OilyT/ShroomShedMKII/SolidWorks/AE_parts/AE_Hinge_31x40_ass.SLDASM

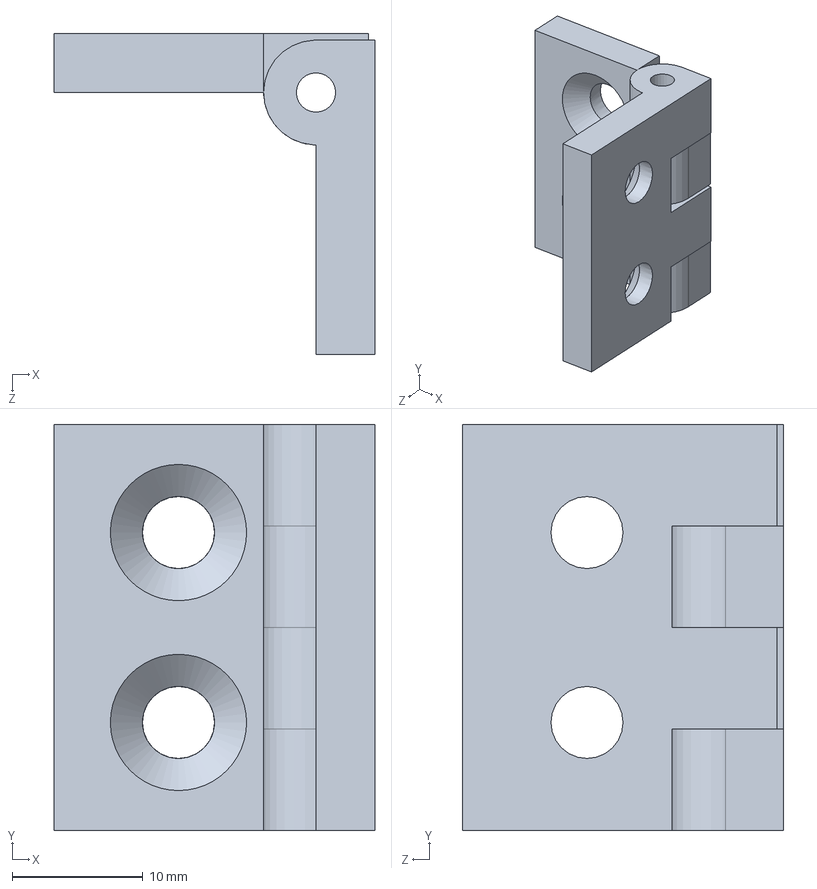
[picture p1: CAD file, 2026-11-09]
SolidWorks/AE_parts/AE_Hinge_31x40_ass.SLDASM
24.5 x 31.0 x 24.5 mm
AE_Hinge_31x40_A x 2
