OilyT/ShroomShedMKII/SolidWorks/Right_Assembly.SLDASM

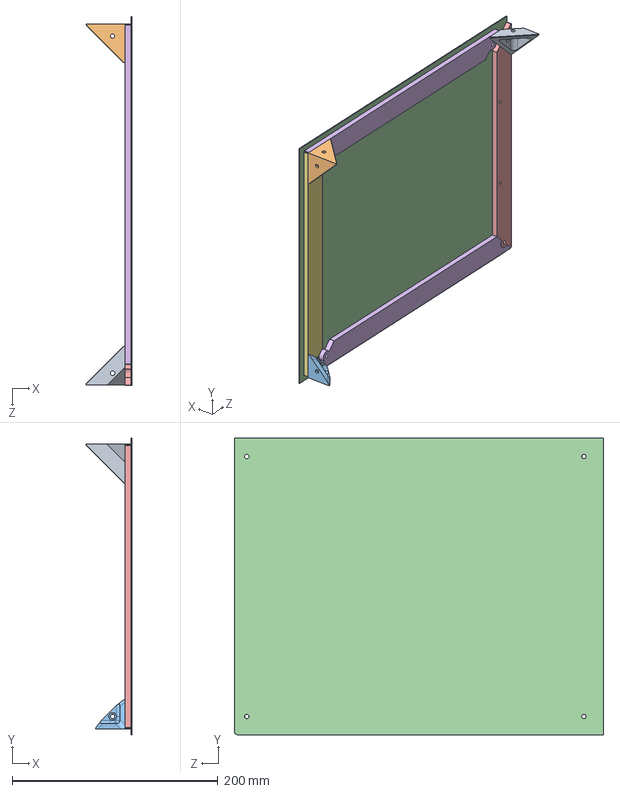
[picture p2: CAD file, 2026-11-09]
SolidWorks/Right_Assembly.SLDASM
45.0 x 289.0 x 359.3 mm
FRAME_SIDE_VERTICAL
FRAME_SIDE_HORIZONTAL x 2
FRAME_SIDE_VERTICAL_HOLED_RIGHT
Right_Panel
L2_bracket_2H_1C
L2_bracket_3H
V3_bracket_front_TOP
