OilyT/ShroomShedMKII/SolidWorks/DXF/Frame_cuts_all.SLDASM

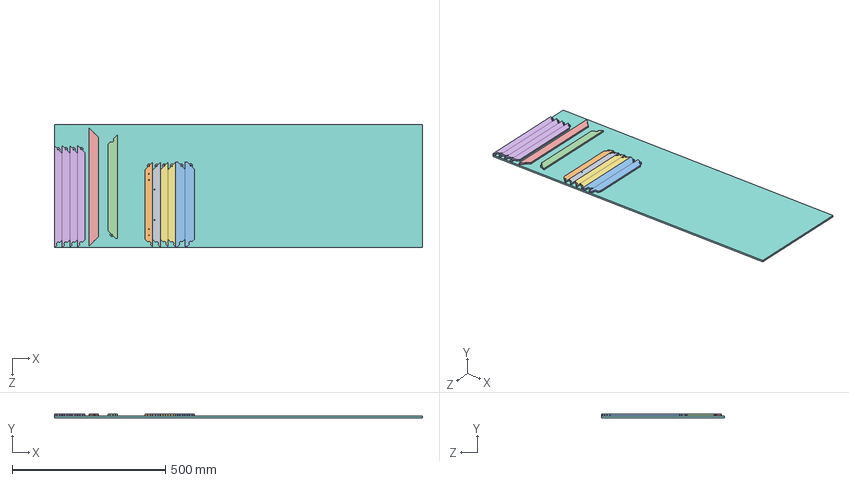
[picture p3: CAD file, 2026-11-09]
SolidWorks/DXF/Frame_cuts_all.SLDASM
1200.0 x 12.0 x 400.4 mm
400x1200mm_base
FRAME_SIDE_VERTICAL x 2
FRAME_SIDE_HORIZONTAL x 4
FRAME_TOP_BACK
FRAME_TOP_SIDE
FRAME_REAR_VERT x 2
FRAME_SIDE_VERTICAL_HOLED
FRAME_SIDE_VERTICAL_HOLED_RIGHT
