OilyT/ShroomShedMKII/SolidWorks/Rear_assembly.SLDASM

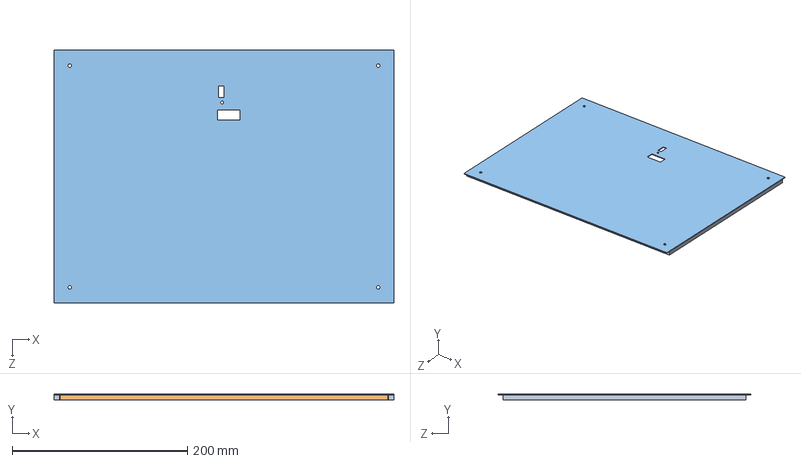
[picture p4: CAD file, 2026-11-09]
SolidWorks/Rear_assembly.SLDASM
388.0 x 7.00 x 289.0 mm
Rear_Panel
FRAME_REAR_BOTT
FRAME_REAR_VERT x 2
