OilyT/ShroomShedMKII/SolidWorks/subass/Hinge 2 Piece.SLDASM

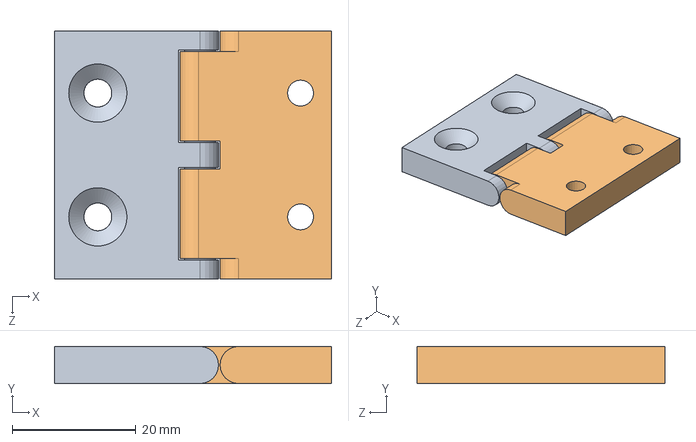
[picture p5: CAD file, 2026-11-09]
SolidWorks/subass/Hinge 2 Piece.SLDASM
44.8 x 6.00 x 40.0 mm
Hinge_SideB
Hinge_sideA
