OilyT/ShroomShedMKII/SolidWorks/SIDE_FRAME.SLDASM

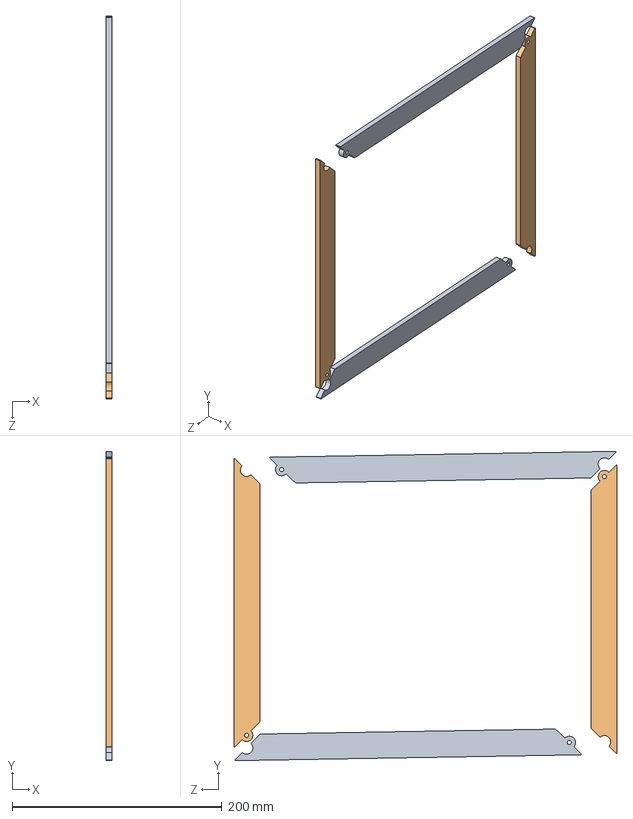
[picture p6: CAD file, 2026-02-02]
SolidWorks/SIDE_FRAME.SLDASM
6.00 x 295.1 x 365.5 mm
FRAME_SIDE_VERTICAL x 2
FRAME_SIDE_HORIZONTAL x 2
