OilyT/ShroomShedMKII/MFG/ShroomShed 0.1/DXF/PC_LEFT_RIGHT_DOOR_REAR.DXF

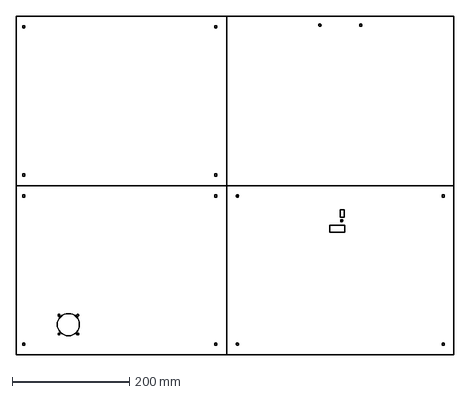
[picture p7: CAD file, 2026-07-16]
MFG/ShroomShed 0.1/DXF/PC_LEFT_RIGHT_DOOR_REAR.DXF
748.0 x 578.0 mm
