OilyT/ShroomShedMKII/MFG/ShroomShed 0.2/DXF/Frame/FRAME_CUT_C.DXF

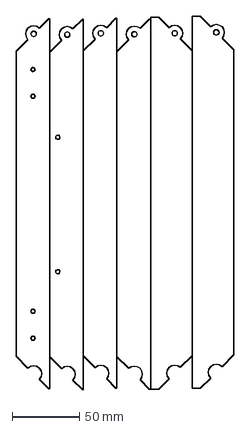
[picture p9: CAD file, 2026-11-09]
MFG/ShroomShed 0.2/DXF/Frame/FRAME_CUT_C.DXF
162.0 x 277.9 mm
