OilyT/ShroomShedMKII/MFG/ShroomShed 0.2/DXF/Top_Panel_.DXF

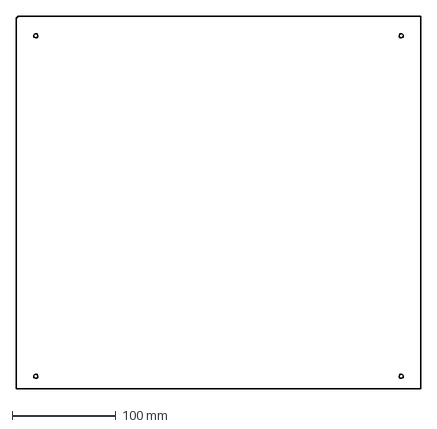
[picture p10: CAD file, 2026-11-09]
MFG/ShroomShed 0.2/DXF/Top_Panel_.DXF
390.0 x 359.0 mm
