OilyT/ShroomShedMKII/ShroomShed_MKII_PCB/ShroomShed_Sensor/Shroomshed_Sensor_R1_PCB.step

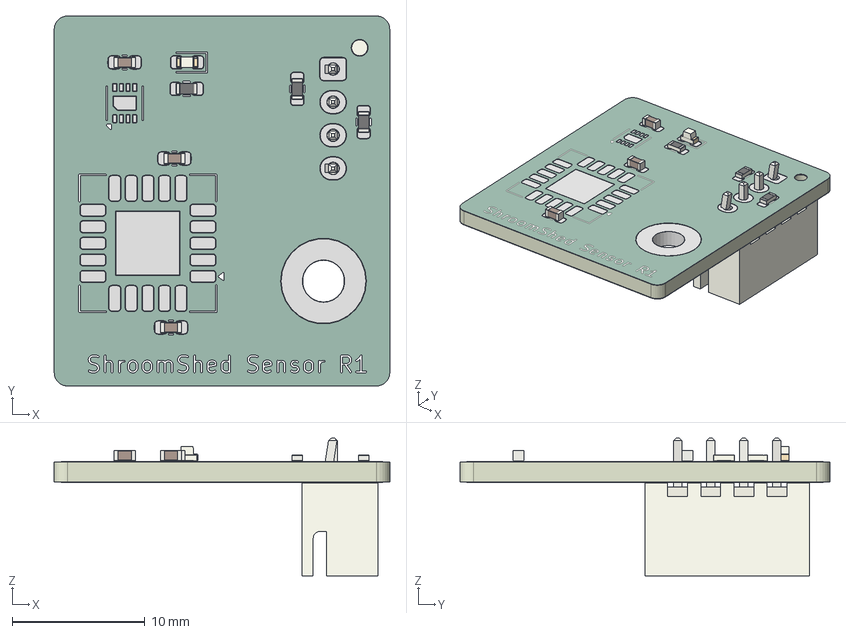
[picture p12: CAD file, 2026-07-03]
ShroomShed_MKII_PCB/ShroomShed_Sensor/Shroomshed_Sensor_R1_PCB.step
25.3 x 27.9 x 10.4 mm
LED_0603_1608Metric
C_0603_1608Metric x 3
R_0603_1608Metric x 3
JST_XH_B4B-XH-A_1x04_P2.50mm_Vertical
ShroomShed_Sensor_copper
ShroomShed_Sensor_pad
ShroomShed_Sensor_via
ShroomShed_Sensor_silkscreen x 2
ShroomShed_Sensor_soldermask x 2
ShroomShed_Sensor_PCB
