OilyT/ShroomShedMKII/ShroomShed_MKII_PCB/ShroomShedController_V22_simple.step

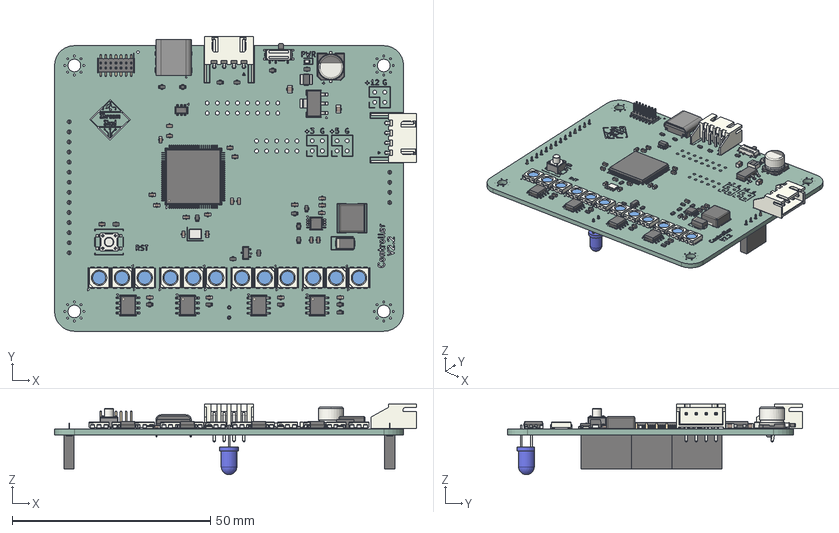
[picture p13: CAD file, 2026-07-03]
ShroomShed_MKII_PCB/ShroomShedController_V22_simple.step
91.2 x 74.2 x 17.8 mm
C_0603_1608Metric x 24
LED_RGB_5050-6 x 12
R_0603_1608Metric x 19
SW_SPST_PTS647Sx50
JST_XH_S4B-XH-A-1_1x04_P2.50mm_Horizontal x 2
USB_C_Receptacle_GCT_USB4085
C_0805_2012Metric x 2
CP_Elec_6.3x5.4
L_TechFuse_SL0630
Fuse_1210_3225Metric
SOIC-8_3.9x4.9mm_P1.27mm x 4
Crystal_SMD_3225-4Pin_3.2x2.5mm
SOT-223
PinHeader_2x07_P1.27mm_Vertical_SMD
SOT-23
SOT-23-6
VSSOP-8_3x3mm_P0.65mm
LQFP-100_14x14mm_P0.5mm
SW_SPDT_PCM12
LED_0603_1608Metric
D_SMA
LED_D4.0mm_Blue
PinSocket_1x04_P2.54mm_Vertical
PinSocket_1x14_P2.54mm_Vertical
ShroomShed_MKII_PCB_silkscreen x 2
ShroomShed_MKII_PCB_PCB
