OilyT/ShroomShedMKII/SolidWorks/AE_parts/AE_Hinge_31x40_A.SLDPRT

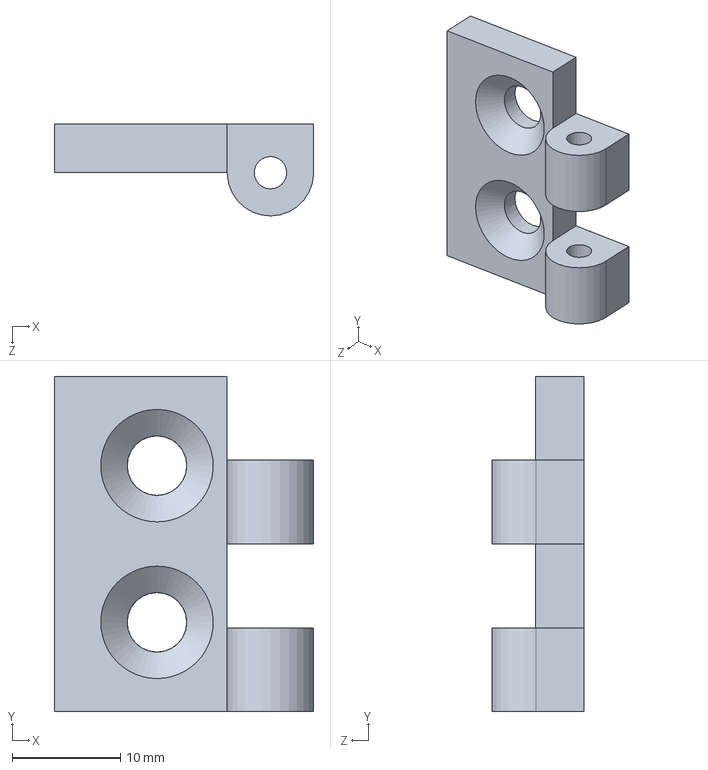
[picture p14: CAD file, 2026-11-09]
SolidWorks/AE_parts/AE_Hinge_31x40_A.SLDPRT
24.0 x 31.0 x 8.50 mm
