OilyT/ShroomShedMKII/SolidWorks/DXF/Door_V2.DXF

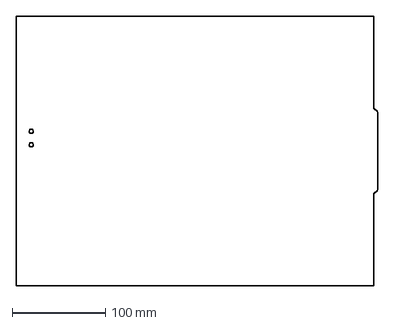
[picture p15: CAD file, 2026-11-09]
SolidWorks/DXF/Door_V2.DXF
388.0 x 289.0 mm
