OilyT/ShroomShedMKII/SolidWorks/proto/L1_bracket_1H_1C.STL

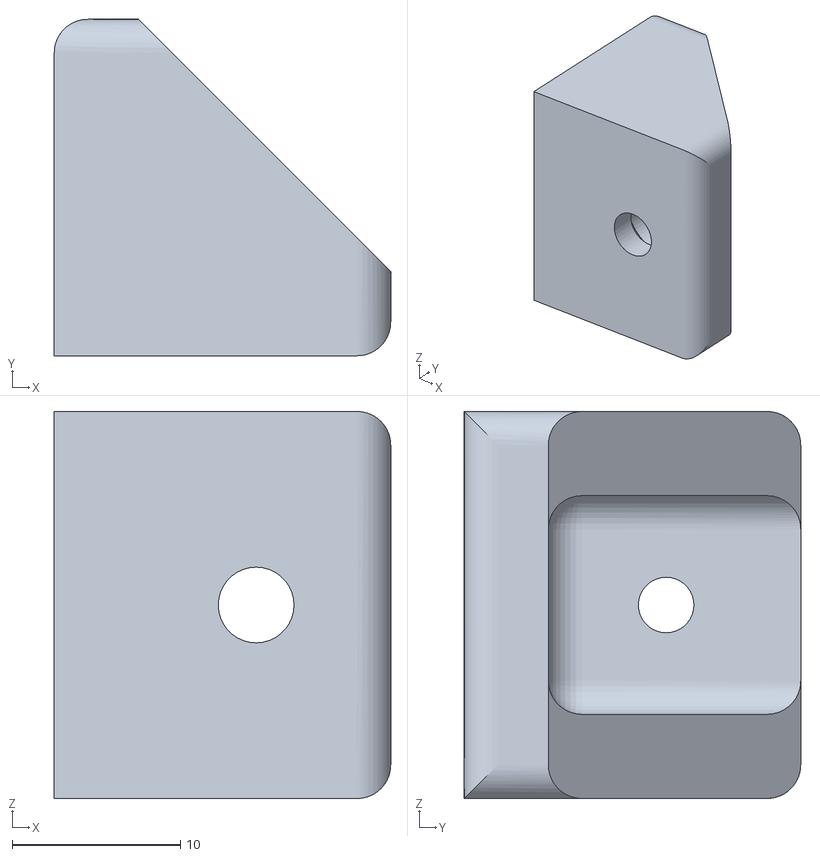
[picture p16: CAD file, 2026-11-09]
SolidWorks/proto/L1_bracket_1H_1C.STL
20.0 x 20.0 x 23.0
