OilyT/ShroomShedMKII/SolidWorks/Rear_Panel.SLDPRT

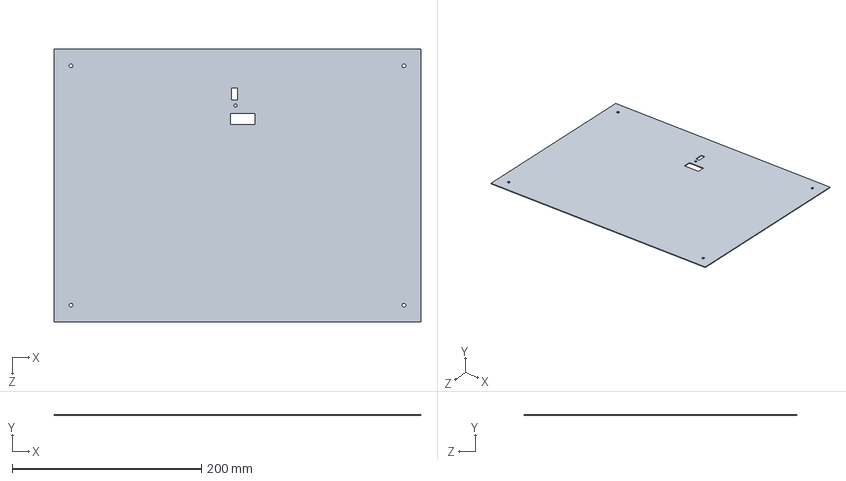
[picture p17: CAD file, 2026-11-09]
SolidWorks/Rear_Panel.SLDPRT
388.0 x 1.00 x 289.0 mm
