OilyT/ShroomShedMKII/SolidWorks/STL/TPU_SEAL_85mm.SLDPRT

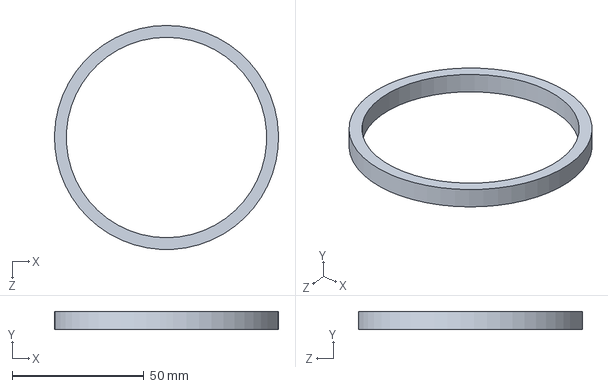
[picture p18: CAD file, 2026-07-21]
SolidWorks/STL/TPU_SEAL_85mm.SLDPRT
85.0 x 7.00 x 85.0 mm
