OilyT/ShroomShedMKII/SolidWorks/subass/Hinge_sideA.SLDPRT

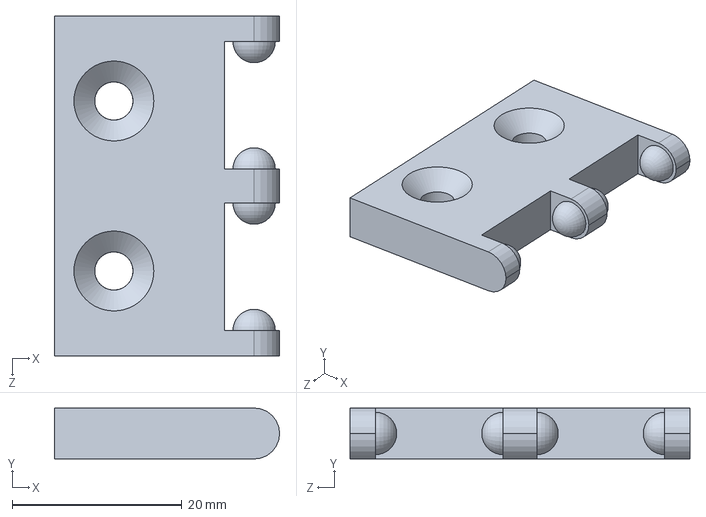
[picture p19: CAD file, 2026-11-09]
SolidWorks/subass/Hinge_sideA.SLDPRT
26.5 x 6.00 x 40.0 mm
