OilyT/ShroomShedMKII/MFG/ShroomShed 0.1/DXF/FRAME_top_side_2.DXF

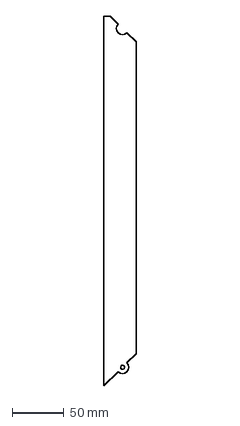
[picture p20: CAD file, 2026-07-03]
MFG/ShroomShed 0.1/DXF/FRAME_top_side_2.DXF
31.0 x 358.0 mm
