OilyT/ShroomShedMKII/MFG/ShroomShed 0.1/STL/Wick_cutting_jig_56mm.STL

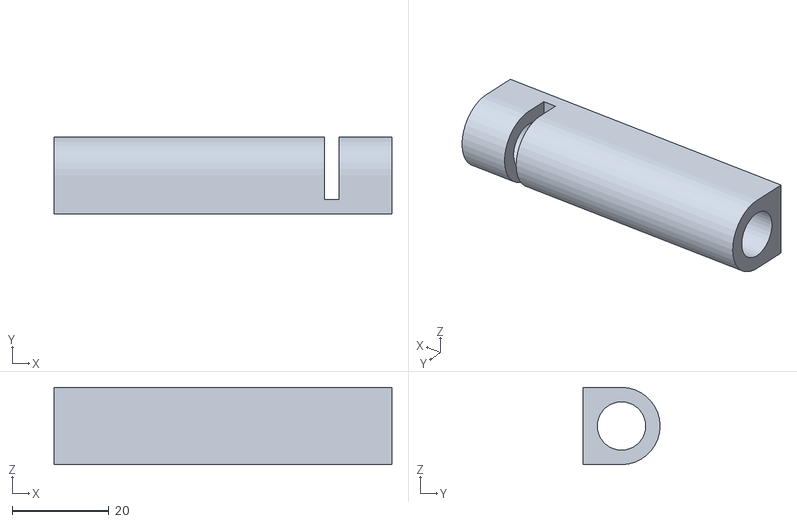
[picture p21: CAD file, 2026-07-30]
MFG/ShroomShed 0.1/STL/Wick_cutting_jig_56mm.STL
70.0 x 16.0 x 16.0
