OilyT/ShroomShedMKII/MFG/ShroomShed 0.2/DXF/Door_.DXF

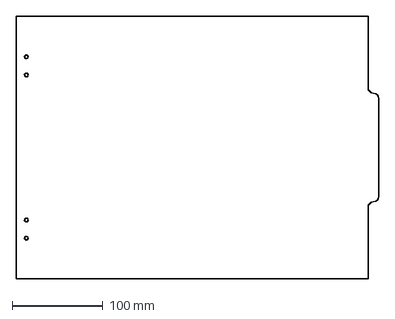
[picture p22: CAD file, 2026-11-09]
MFG/ShroomShed 0.2/DXF/Door_.DXF
400.0 x 289.0 mm
