OilyT/ShroomShedMKII/MFG/ShroomShed 0.2/DXF/Frame/FRAME_SIDE_VERTICAL_HOLED_RIGHT.DXF

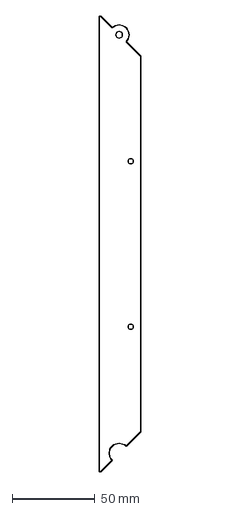
[picture p23: CAD file, 2026-11-09]
MFG/ShroomShed 0.2/DXF/Frame/FRAME_SIDE_VERTICAL_HOLED_RIGHT.DXF
25.0 x 275.7 mm
