OilyT/ShroomShedMKII/ShroomShed_MKII_PCB/ERM_PCB/ERM_BOARD_TRACES.step

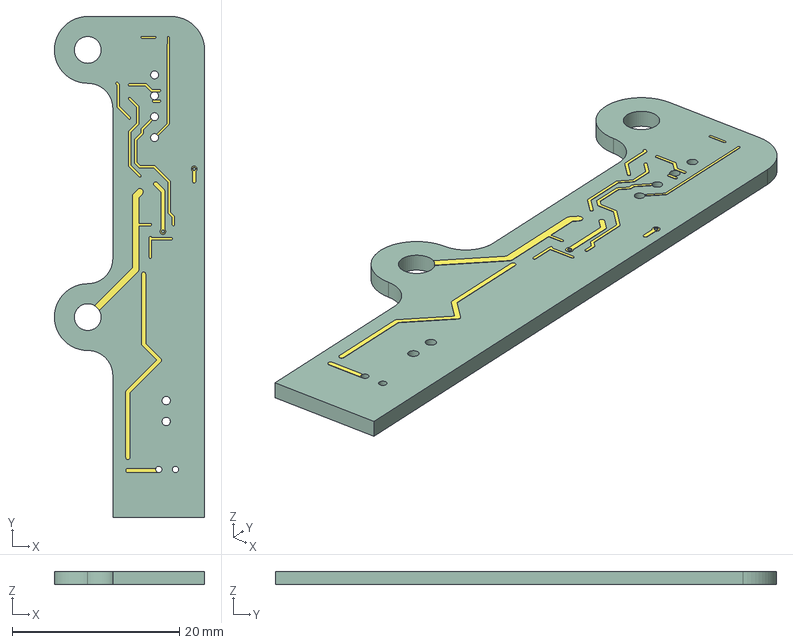
[picture p24: CAD file, 2026-04-01]
ShroomShed_MKII_PCB/ERM_PCB/ERM_BOARD_TRACES.step
18.0 x 60.0 x 1.58 mm
ERM_PCB_copper
ERM_PCB_via
ERM_PCB_PCB
