OilyT/ShroomShedMKII/ShroomShed_MKII_PCB/ShroomShed_MKII_PCB.step

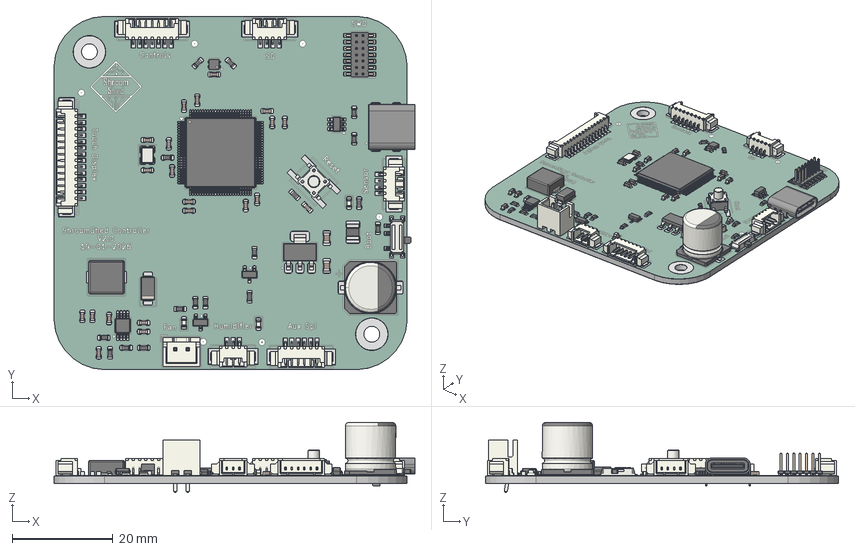
[picture p25: CAD file, 2026-02-02]
ShroomShed_MKII_PCB/ShroomShed_MKII_PCB.step
71.5 x 70.0 x 13.9 mm
C_0603_1608Metric x 21
R_0603_1608Metric x 17
LED_0603_1608Metric x 3
SW_SPDT_PCM12
SW_SPST_PTS647Sx50
Molex_PicoBlade_53261-0471_1x04-1MP_P1.25mm_Horizontal x 2
USB_C_Receptacle_GCT_USB4085
C_0805_2012Metric x 2
CP_Elec_10x10.5
L_TechFuse_SL0630
Fuse_1210_3225Metric
Crystal_SMD_3225-4Pin_3.2x2.5mm
SOT-223
SOT-23 x 2
PinHeader_2x07_P1.27mm_Vertical_SMD
DFN-6-1EP_2x2mm_P0.5mm_EP0.61x1.42mm
SOT-23-6
VSSOP-8_3x3mm_P0.65mm
Molex_PicoBlade_53261-0371_1x03-1MP_P1.25mm_Horizontal
LQFP-100_14x14mm_P0.5mm
Molex_PicoBlade_53261-1471_1x14-1MP_P1.25mm_Horizontal
Molex_PicoBlade_53261-0771_1x07-1MP_P1.25mm_Horizontal
Molex_PicoBlade_53261-0671_1x06-1MP_P1.25mm_Horizontal
D_SMA
JST_XH_B2B-XH-A_1x02_P2.50mm_Vertical
ShroomShed_MKII_PCB_copper
ShroomShed_MKII_PCB_pad
ShroomShed_MKII_PCB_via
ShroomShed_MKII_PCB_silkscreen x 2
ShroomShed_MKII_PCB_soldermask x 2
ShroomShed_MKII_PCB_PCB
