OilyT/ShroomShedMKII/SolidWorks/DXF/400x1200mm_base.SLDPRT

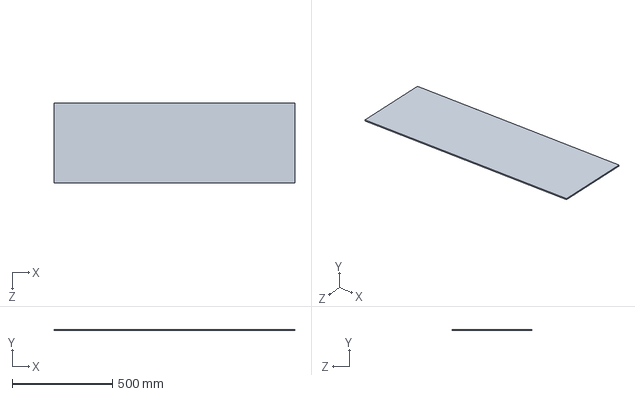
[picture p26: CAD file, 2026-11-09]
SolidWorks/DXF/400x1200mm_base.SLDPRT
1200.0 x 6.00 x 400.0 mm
