OilyT/ShroomShedMKII/SolidWorks/proto/L1_bracket_1H_1C_MAG_Bracket.STL

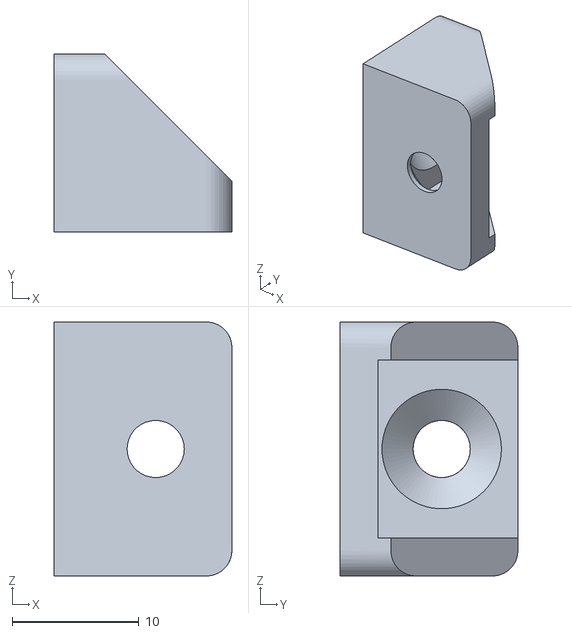
[picture p27: CAD file, 2026-11-09]
SolidWorks/proto/L1_bracket_1H_1C_MAG_Bracket.STL
14.0 x 14.0 x 20.0
