OilyT/ShroomShedMKII/SolidWorks/STL/Filter_Bracket.SLDPRT

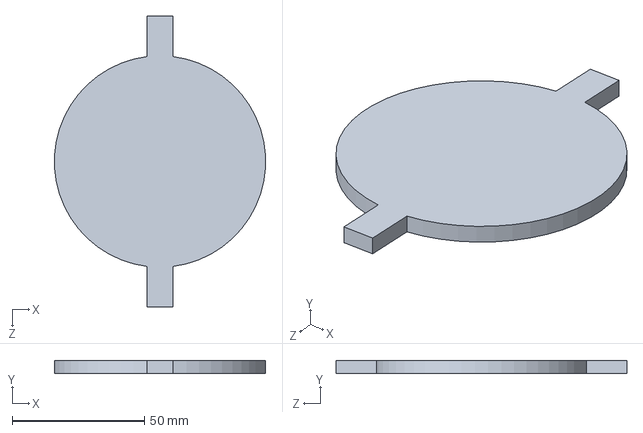
[picture p28: CAD file, 2026-07-21]
SolidWorks/STL/Filter_Bracket.SLDPRT
79.8 x 5.00 x 110.0 mm
