OilyT/ShroomShedMKII/SolidWorks/subass/Hinge_SideB.SLDPRT

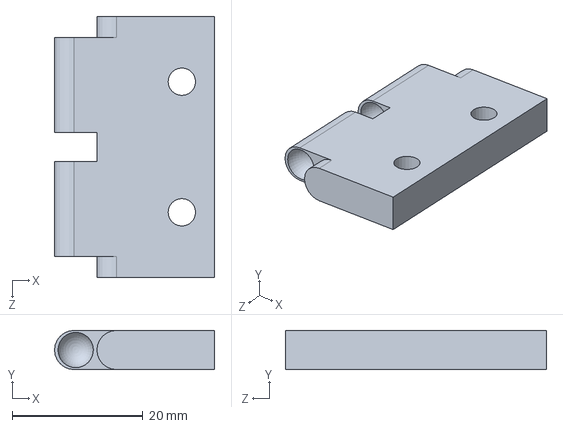
[picture p29: CAD file, 2026-11-09]
SolidWorks/subass/Hinge_SideB.SLDPRT
24.5 x 6.00 x 40.0 mm
