OilyT/ShroomShedMKII/MFG/ShroomShed 0.1/DXF/FRAME_CUT_C.DXF

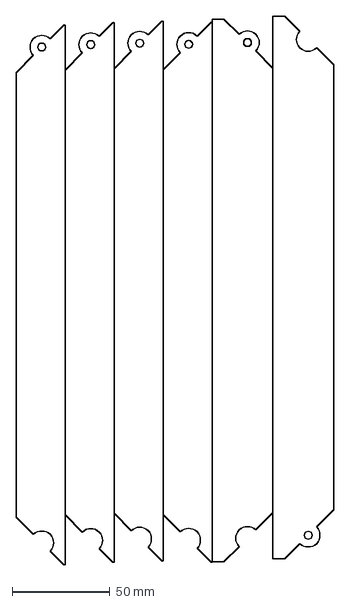
[picture p30: CAD file, 2026-07-03]
MFG/ShroomShed 0.1/DXF/FRAME_CUT_C.DXF
162.0 x 280.2 mm
