OilyT/ShroomShedMKII/MFG/ShroomShed 0.1/STL/Controller_Module.STL

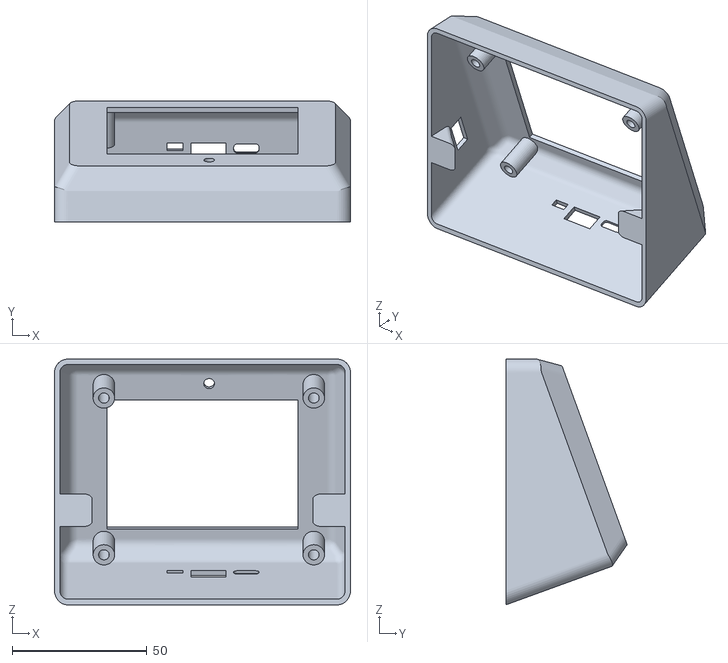
[picture p31: CAD file, 2026-07-03]
MFG/ShroomShed 0.1/STL/Controller_Module.STL
110.0 x 45.1 x 91.3
