OilyT/ShroomShedMKII/MFG/ShroomShed 0.2/DXF/Floor.DXF

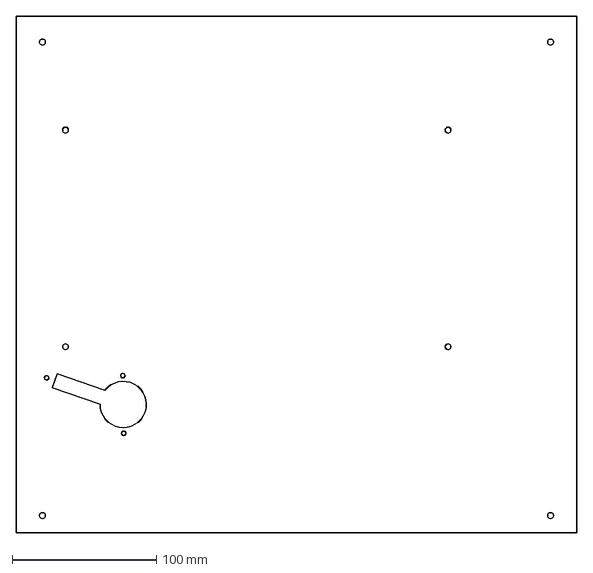
[picture p32: CAD file, 2026-11-09]
MFG/ShroomShed 0.2/DXF/Floor.DXF
388.0 x 358.0 mm
