OilyT/ShroomShedMKII/ShroomShed_MKII_PCB/ERM_PCB/ERM_PCB.step

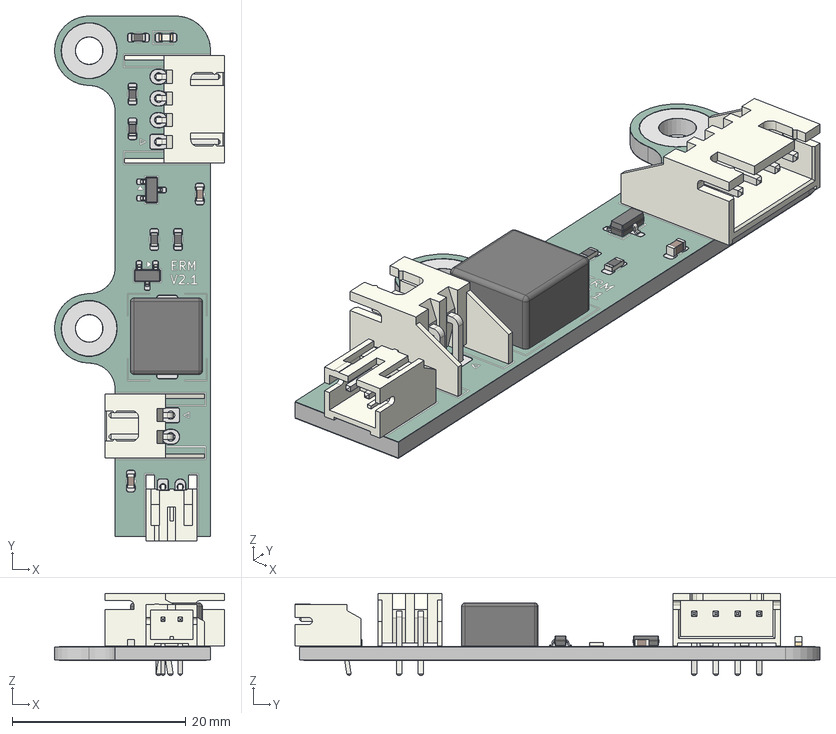
[picture p34: CAD file, 2026-02-11]
ShroomShed_MKII_PCB/ERM_PCB/ERM_PCB.step
19.6 x 60.5 x 9.50 mm
JST_XH_S2B-XH-A-1_1x02_P2.50mm_Horizontal
R_0603_1608Metric x 5
C_0603_1608Metric x 2
L_Coilcraft_XAL8050-223
JST_PH_S2B-PH-K_1x02_P2.00mm_Horizontal
SOT-23 x 2
JST_XH_S4B-XH-A-1_1x04_P2.50mm_Horizontal
LED_0603_1608Metric
ERM_PCB_copper
ERM_PCB_pad
ERM_PCB_via
ERM_PCB_silkscreen
ERM_PCB_soldermask x 2
ERM_PCB_PCB
