OilyT/ShroomShedMKII/SolidWorks/proto/V3_bracket_front_base.STL

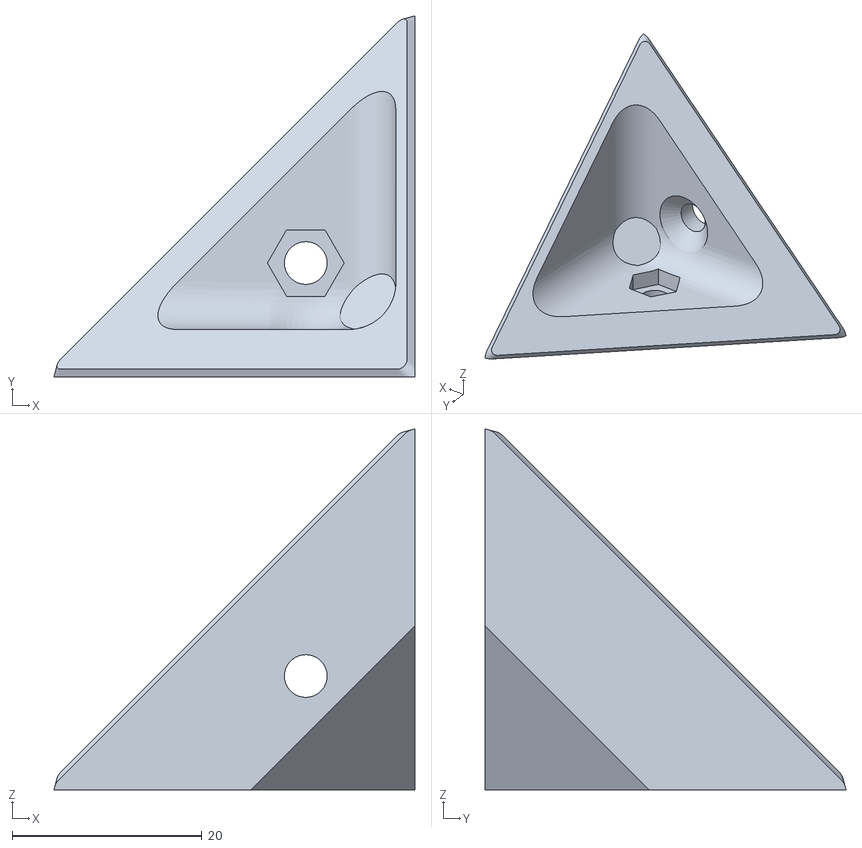
[picture p35: CAD file, 2026-11-09]
SolidWorks/proto/V3_bracket_front_base.STL
38.0 x 38.0 x 38.0
