OilyT/ShroomShedMKII/MFG/ShroomShed 0.1/DXF/Right_Panel.DXF

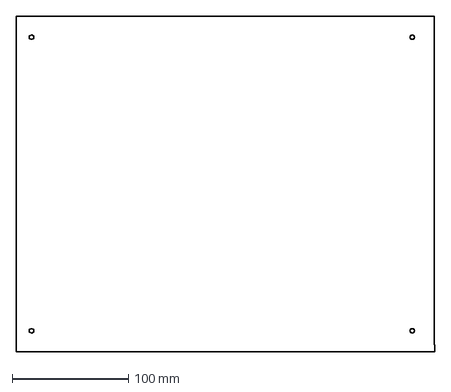
[picture p36: CAD file, 2026-07-03]
MFG/ShroomShed 0.1/DXF/Right_Panel.DXF
360.2 x 289.0 mm
