OilyT/ShroomShedMKII/MFG/ShroomShed 0.2/DXF/Frame/FRAME_rear_bot_(tf).DXF

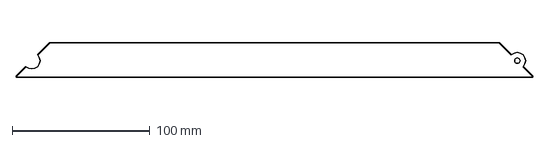
[picture p38: CAD file, 2026-07-03]
MFG/ShroomShed 0.2/DXF/Frame/FRAME_rear_bot_(tf).DXF
374.7 x 25.0 mm
