OilyT/ShroomShedMKII/MFG/ShroomShed 0.2/DXF/Rear_Panel.DXF

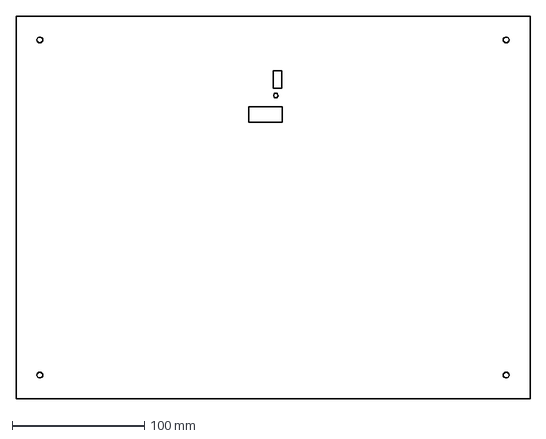
[picture p39: CAD file, 2026-11-09]
MFG/ShroomShed 0.2/DXF/Rear_Panel.DXF
388.0 x 289.0 mm
