OilyT/ShroomShedMKII/SolidWorks/proto/Hinge 2 Piece_holed.STL

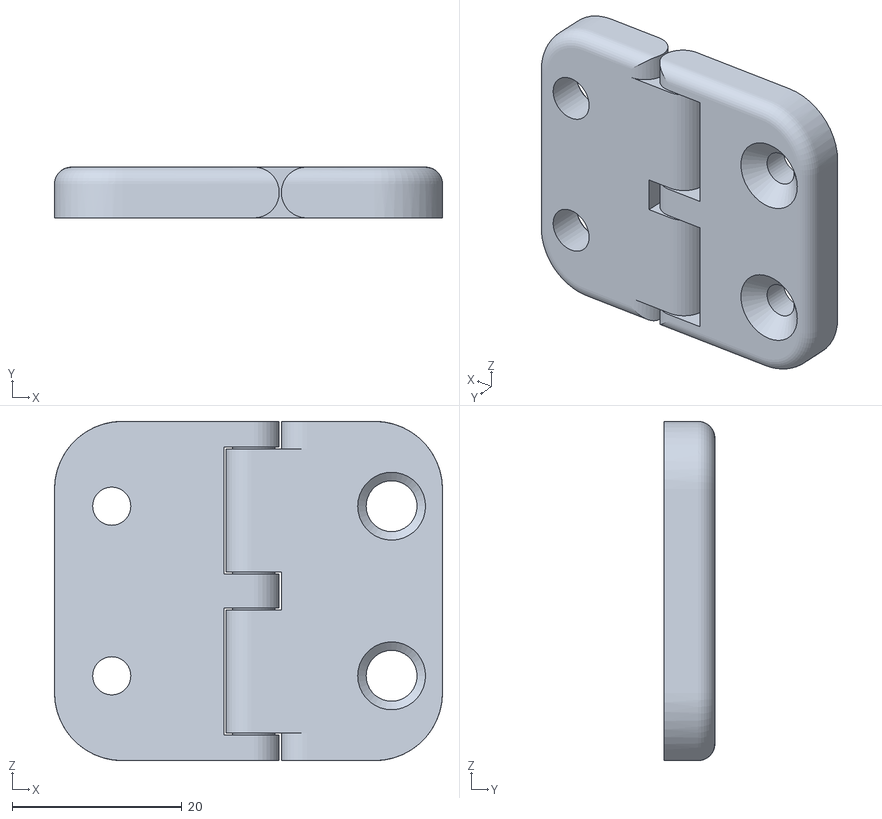
[picture p40: CAD file, 2026-11-09]
SolidWorks/proto/Hinge 2 Piece_holed.STL
45.8 x 6.00 x 40.0
