OilyT/ShroomShedMKII/MFG/ShroomShed 0.1/DXF/FRAME_top_back.DXF

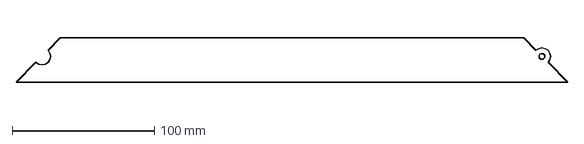
[picture p41: CAD file, 2026-07-03]
MFG/ShroomShed 0.1/DXF/FRAME_top_back.DXF
388.0 x 31.0 mm
