OilyT/ShroomShedMKII/MFG/ShroomShed 0.1/STL/L2_bracket_front_high.STL

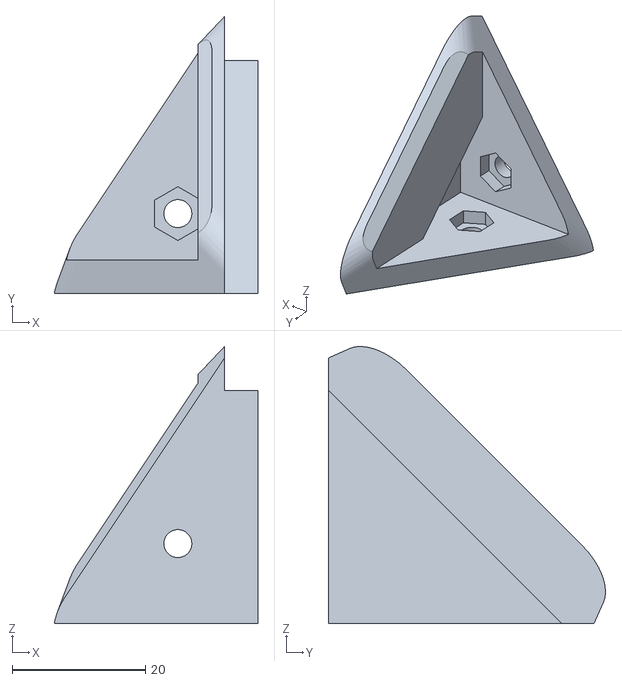
[picture p42: CAD file, 2026-07-03]
MFG/ShroomShed 0.1/STL/L2_bracket_front_high.STL
30.6 x 41.6 x 41.6
