OilyT/ShroomShedMKII/MFG/ShroomShed 0.2/DXF/acrylic_magnet_bracket.DXF

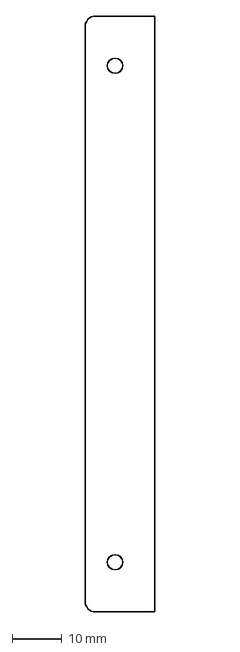
[picture p43: CAD file, 2026-11-09]
MFG/ShroomShed 0.2/DXF/acrylic_magnet_bracket.DXF
14.0 x 120.0 mm
