OilyT/ShroomShedMKII/SolidWorks/DXF/PC_TOP_X2.DXF

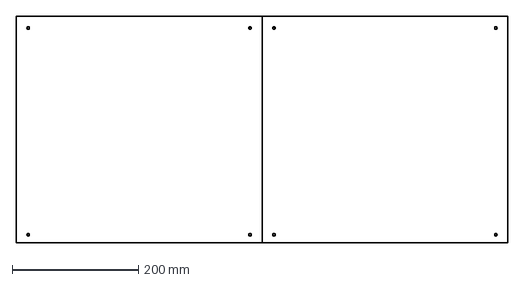
[picture p44: CAD file, 2026-07-16]
SolidWorks/DXF/PC_TOP_X2.DXF
780.0 x 360.0 mm
