OilyT/ShroomShedMKII/MFG/ShroomShed 0.1/DXF/Left_Panel.DXF

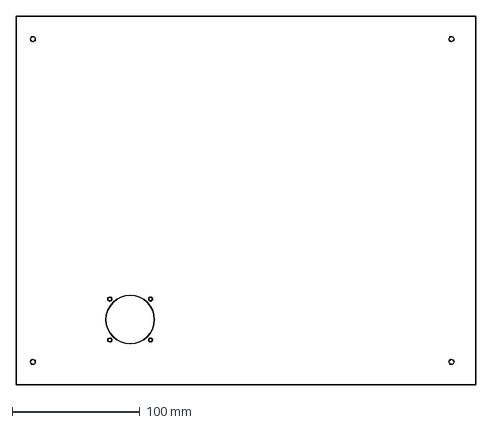
[picture p45: CAD file, 2026-07-03]
MFG/ShroomShed 0.1/DXF/Left_Panel.DXF
360.0 x 289.0 mm
