OilyT/ShroomShedMKII/MFG/ShroomShed 0.2/DXF/Right_Panel.DXF

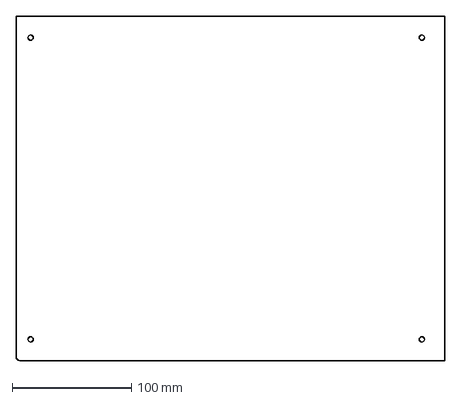
[picture p46: CAD file, 2026-11-09]
MFG/ShroomShed 0.2/DXF/Right_Panel.DXF
359.3 x 289.0 mm
