OilyT/ShroomShedMKII/SolidWorks/DXF/PC_DOOR_REAR.DXF

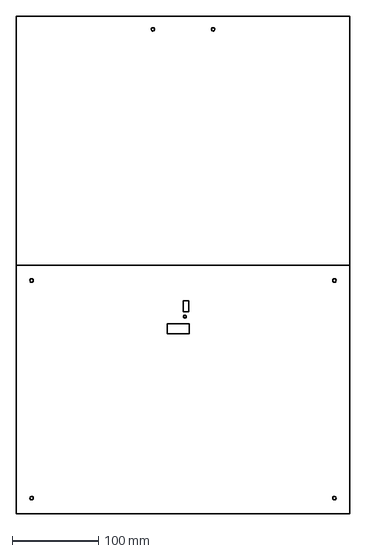
[picture p47: CAD file, 2026-07-16]
SolidWorks/DXF/PC_DOOR_REAR.DXF
388.0 x 578.0 mm
