OilyT/ShroomShedMKII/SolidWorks/hinge_bracket.SLDPRT

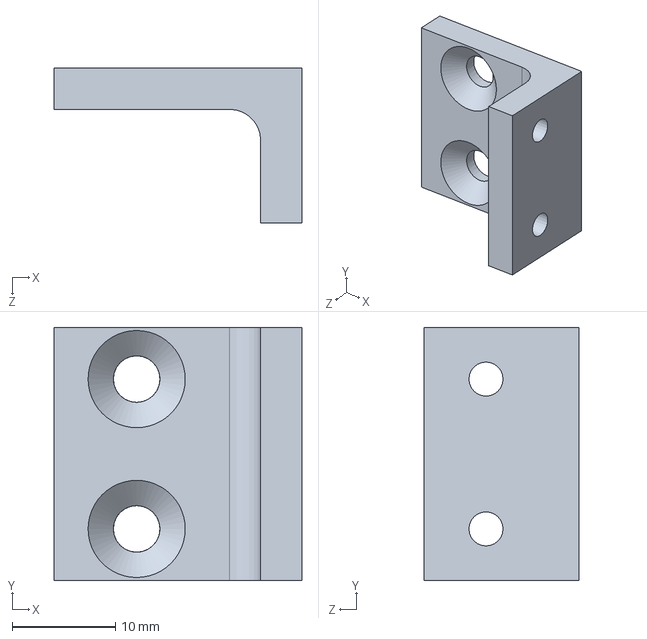
[picture p48: CAD file, 2026-11-09]
SolidWorks/hinge_bracket.SLDPRT
24.0 x 24.5 x 15.0 mm
