OilyT/ShroomShedMKII/SolidWorks/proto/Transducer_Lid_CONV_V2.STL

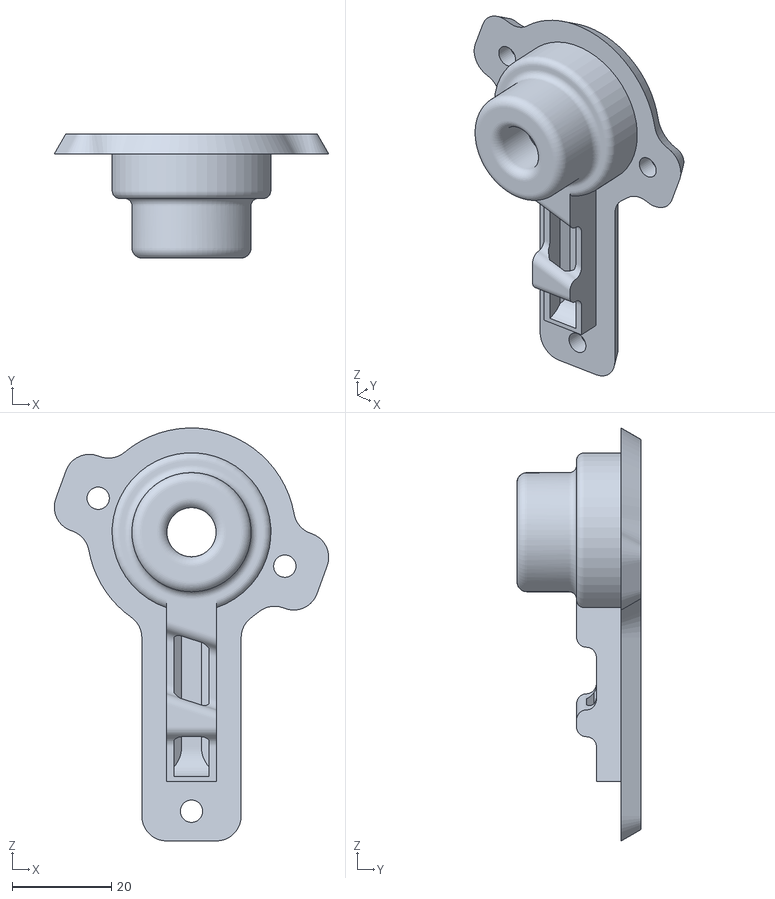
[picture p49: CAD file, 2026-11-09]
SolidWorks/proto/Transducer_Lid_CONV_V2.STL
55.3 x 25.0 x 83.2
