OilyT/ShroomShedMKII/MFG/ShroomShed 0.1/STL/Transducer_Lid.STL

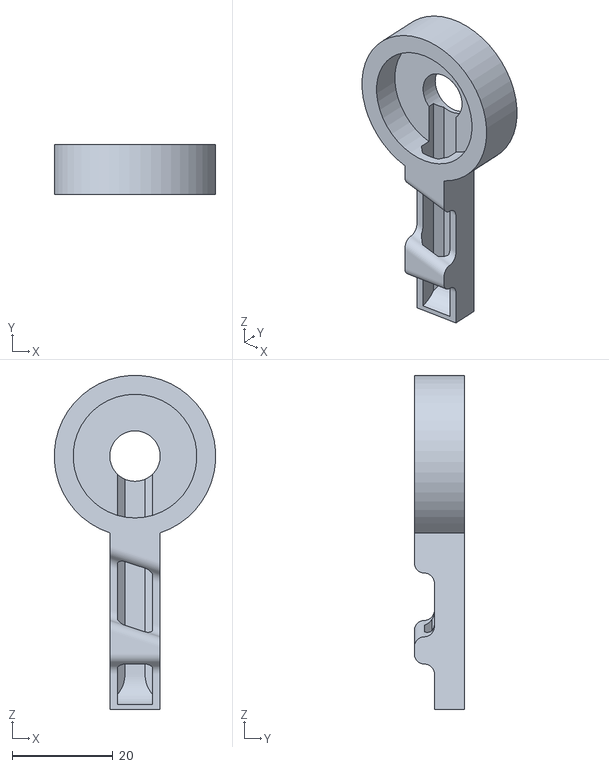
[picture p50: CAD file, 2026-04-29]
MFG/ShroomShed 0.1/STL/Transducer_Lid.STL
31.9 x 10.0 x 66.2
