OilyT/ShroomShedMKII/MFG/ShroomShed 0.2/DXF/Left_Panel.DXF

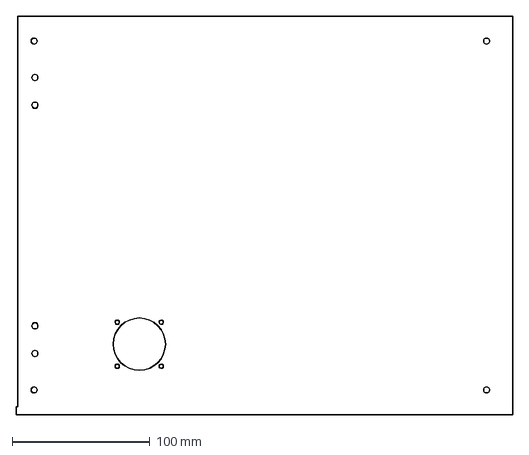
[picture p51: CAD file, 2026-11-09]
MFG/ShroomShed 0.2/DXF/Left_Panel.DXF
360.0 x 289.0 mm
