OilyT/ShroomShedMKII/SolidWorks/acrylic_magnet_bracket.SLDPRT

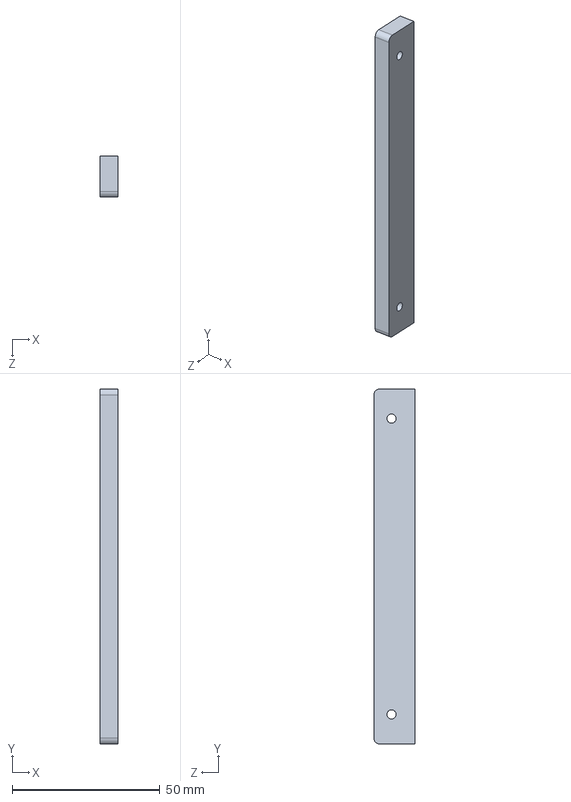
[picture p52: CAD file, 2026-11-09]
SolidWorks/acrylic_magnet_bracket.SLDPRT
6.00 x 120.0 x 14.0 mm
