OilyT/ShroomShedMKII/SolidWorks/DXF/PC_LEFT_RIGHT.DXF

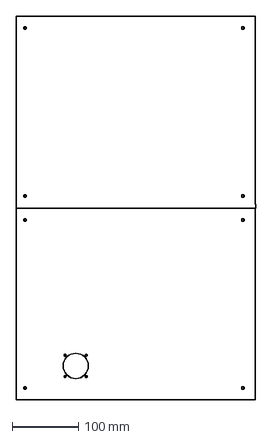
[picture p53: CAD file, 2026-07-16]
SolidWorks/DXF/PC_LEFT_RIGHT.DXF
360.2 x 578.0 mm
