OilyT/ShroomShedMKII/MFG/ShroomShed 0.1/DXF/FRAME_CUT_B.DXF

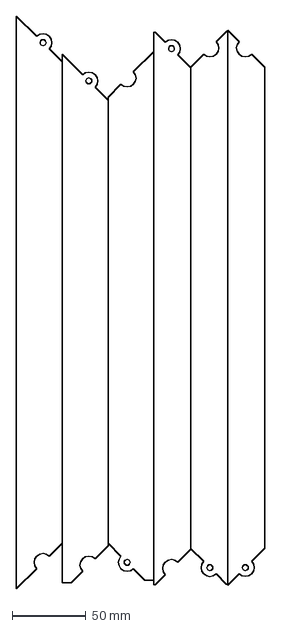
[picture p54: CAD file, 2026-07-03]
MFG/ShroomShed 0.1/DXF/FRAME_CUT_B.DXF
168.0 x 388.0 mm
