OilyT/ShroomShedMKII/MFG/ShroomShed 0.1/STL/L2_bracket_3H.STL

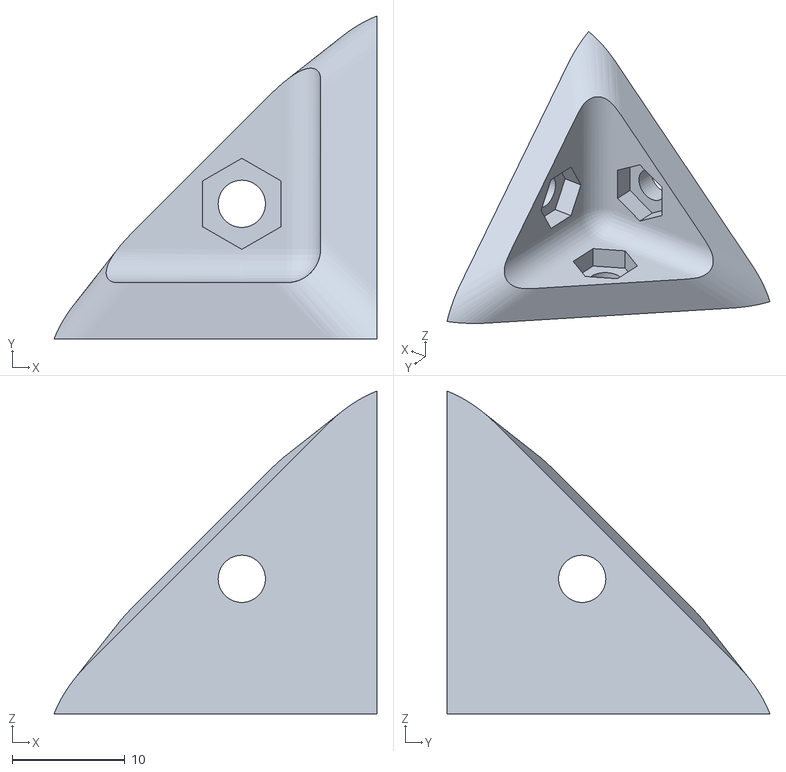
[picture p55: CAD file, 2026-04-09]
MFG/ShroomShed 0.1/STL/L2_bracket_3H.STL
28.7 x 28.7 x 28.7
