OilyT/ShroomShedMKII/SolidWorks/DXF/FRAME_side_vert.DXF

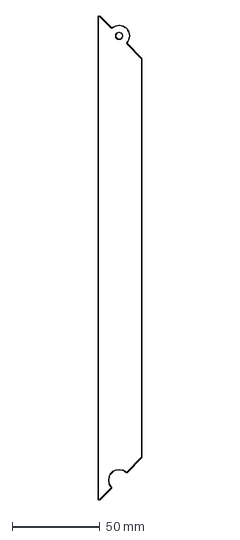
[picture p56: CAD file, 2026-07-03]
SolidWorks/DXF/FRAME_side_vert.DXF
25.0 x 275.7 mm
