OilyT/ShroomShedMKII/SolidWorks/FRAME_REAR_BOTT.SLDPRT

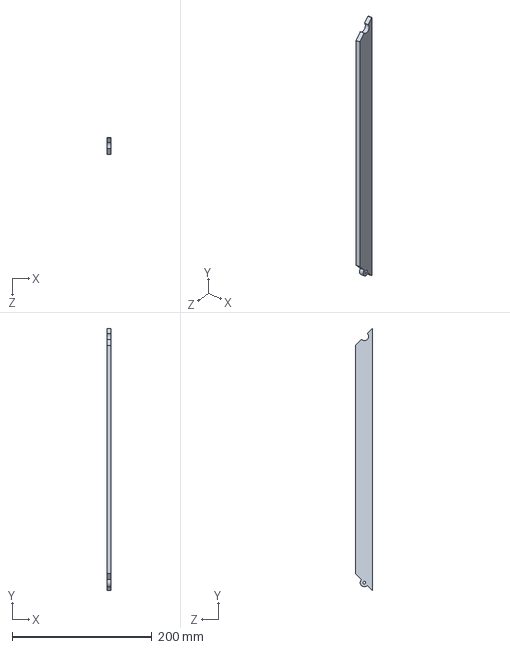
[picture p57: CAD file, 2026-11-09]
SolidWorks/FRAME_REAR_BOTT.SLDPRT
6.00 x 374.6 x 25.0 mm
