OilyT/ShroomShedMKII/SolidWorks/proto/V3_bracket_front_TOP.STL

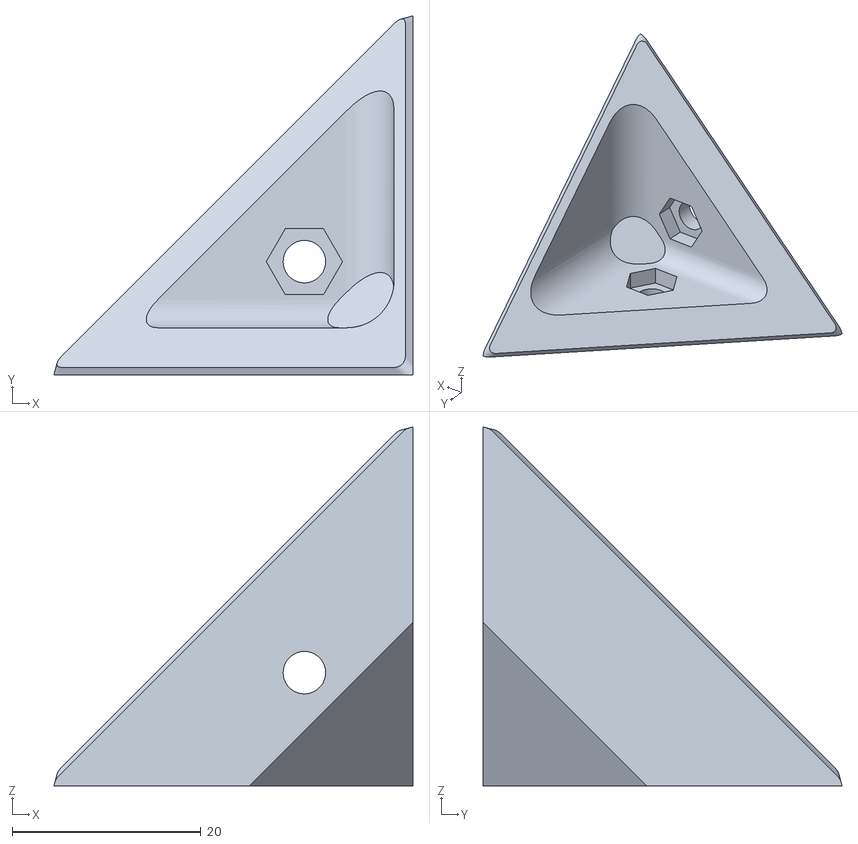
[picture p58: CAD file, 2026-11-09]
SolidWorks/proto/V3_bracket_front_TOP.STL
38.0 x 38.0 x 38.0
