OilyT/ShroomShedMKII/SolidWorks/DXF/FRAME_rear_top_(actual).DXF

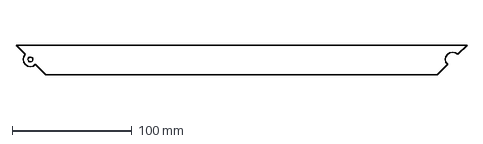
[picture p59: CAD file, 2026-07-03]
SolidWorks/DXF/FRAME_rear_top_(actual).DXF
376.0 x 25.0 mm
