OilyT/ShroomShedMKII/SolidWorks/FRAME_SIDE_HORIZONTAL.SLDPRT

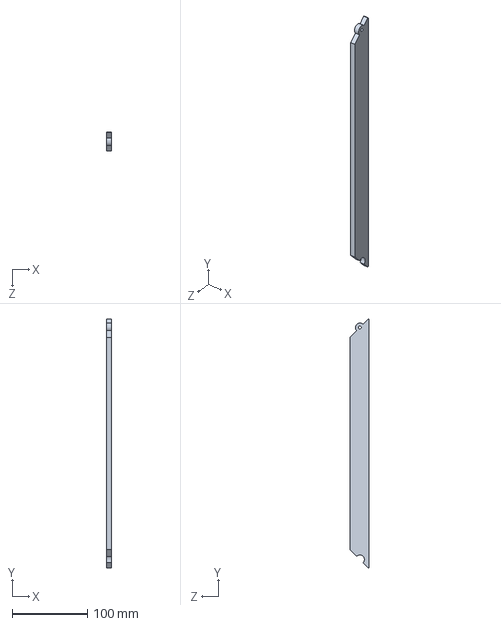
[picture p60: CAD file, 2026-11-09]
SolidWorks/FRAME_SIDE_HORIZONTAL.SLDPRT
6.00 x 330.6 x 25.0 mm
