OilyT/ShroomShedMKII/SolidWorks/proto/foot_flat.STL

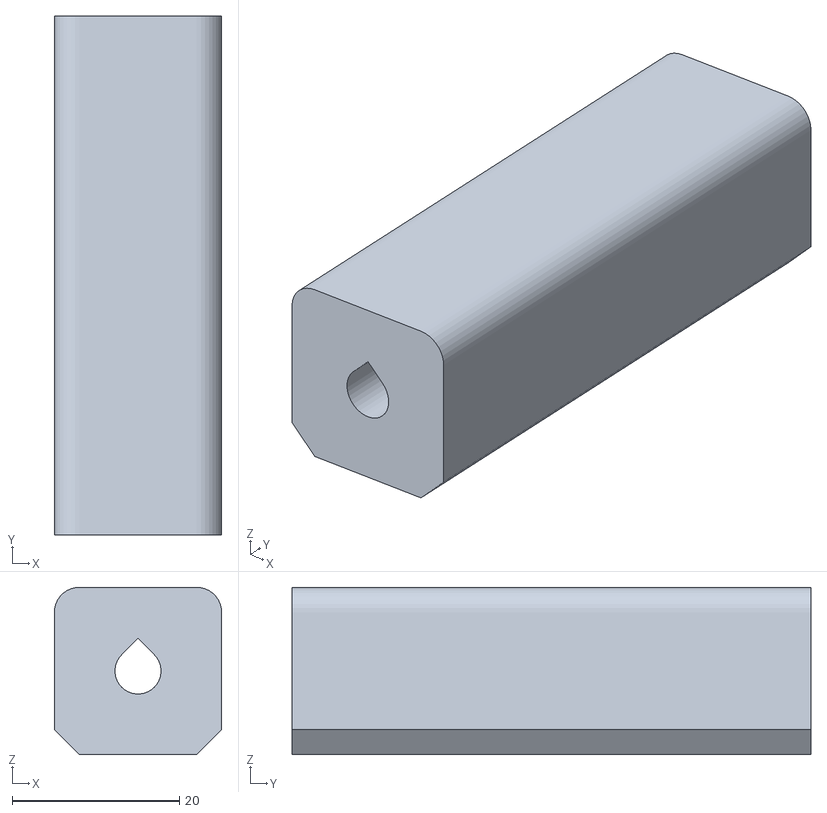
[picture p61: CAD file, 2026-11-09]
SolidWorks/proto/foot_flat.STL
20.0 x 62.0 x 20.0
