OilyT/ShroomShedMKII/SolidWorks/DXF/FRAME_CUT_A.DXF

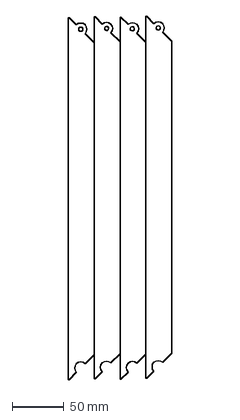
[picture p62: CAD file, 2026-07-03]
SolidWorks/DXF/FRAME_CUT_A.DXF
100.0 x 351.9 mm
