OilyT/ShroomShedMKII/SolidWorks/Polycarbonate_Tub_240x304mm.SLDPRT

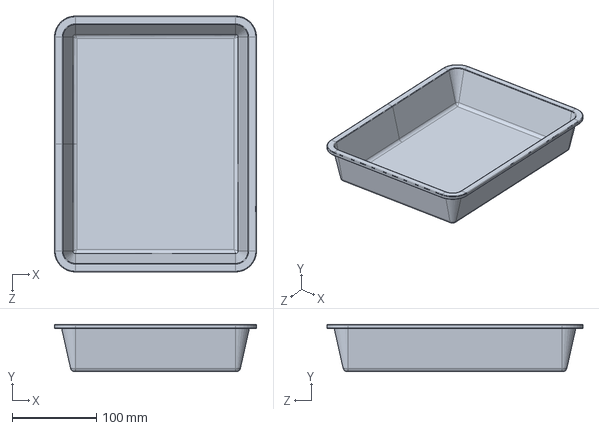
[picture p63: CAD file, 2026-11-09]
SolidWorks/Polycarbonate_Tub_240x304mm.SLDPRT
240.0 x 56.0 x 304.0 mm
