OilyT/ShroomShedMKII/SolidWorks/Door_.SLDPRT

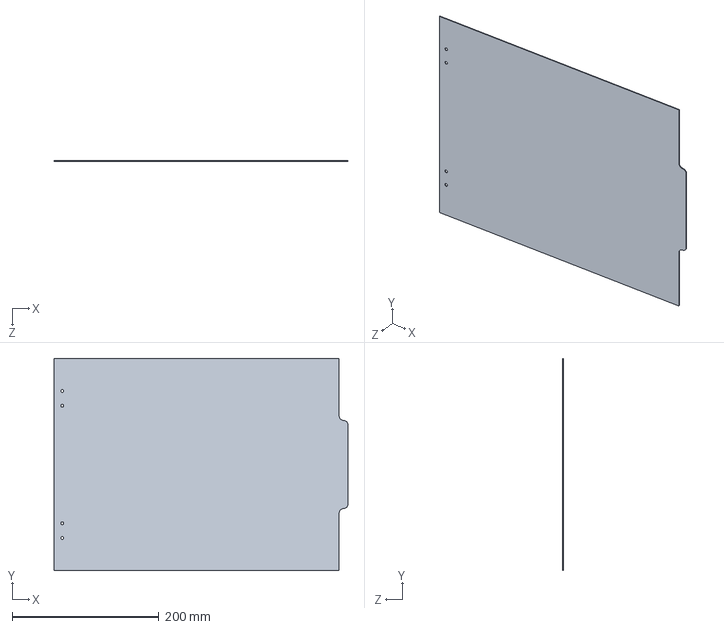
[picture p64: CAD file, 2026-11-09]
SolidWorks/Door_.SLDPRT
400.0 x 289.0 x 1.00 mm
