OilyT/ShroomShedMKII/SolidWorks/DXF/Frame_cuts_SIDE_VERTICAL.DXF

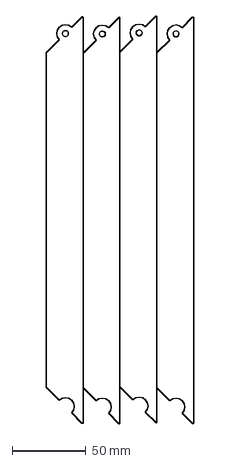
[picture p65: CAD file, 2026-07-03]
SolidWorks/DXF/Frame_cuts_SIDE_VERTICAL.DXF
100.0 x 276.4 mm
