OilyT/ShroomShedMKII/SolidWorks/proto/HUMIDIFIER_CAP.STL

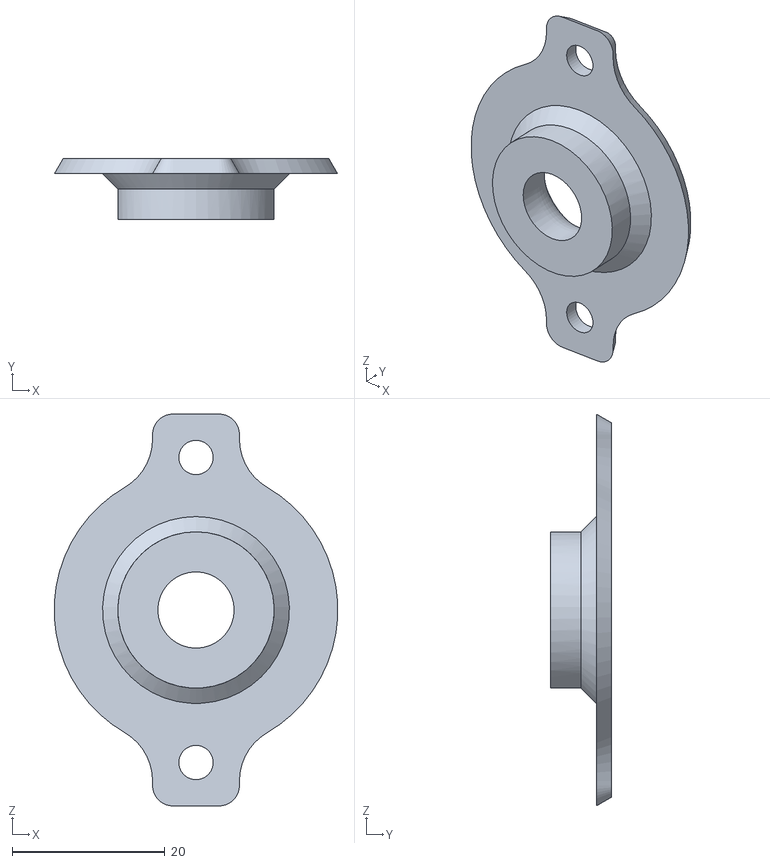
[picture p66: CAD file, 2026-11-09]
SolidWorks/proto/HUMIDIFIER_CAP.STL
37.1 x 8.00 x 51.4
