OilyT/ShroomShedMKII/SolidWorks/DXF/Frame_cuts_SIDE_HORIZONTAL.DXF

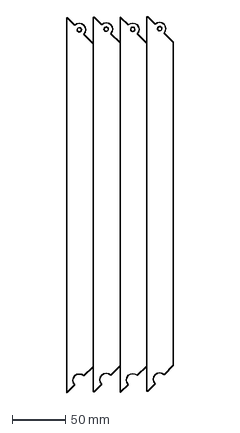
[picture p67: CAD file, 2026-07-03]
SolidWorks/DXF/Frame_cuts_SIDE_HORIZONTAL.DXF
100.0 x 351.9 mm
