OilyT/ShroomShedMKII/SolidWorks/L2_bracket_2H_1C.SLDPRT

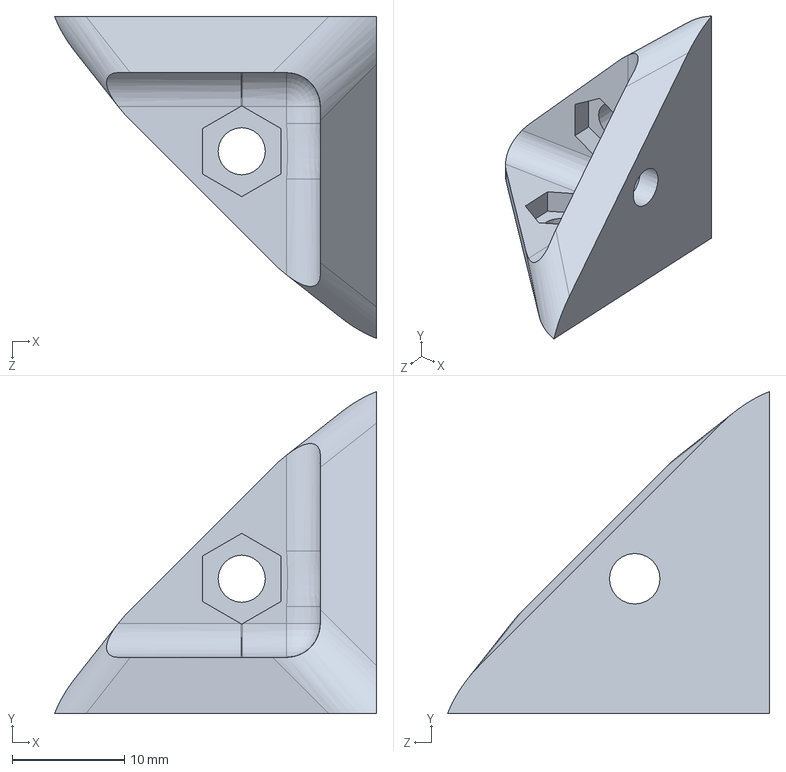
[picture p68: CAD file, 2026-11-09]
SolidWorks/L2_bracket_2H_1C.SLDPRT
28.7 x 28.7 x 28.7 mm
