OilyT/ShroomShedMKII/SolidWorks/FRAME_SIDE_VERTICAL_HOLED.SLDPRT

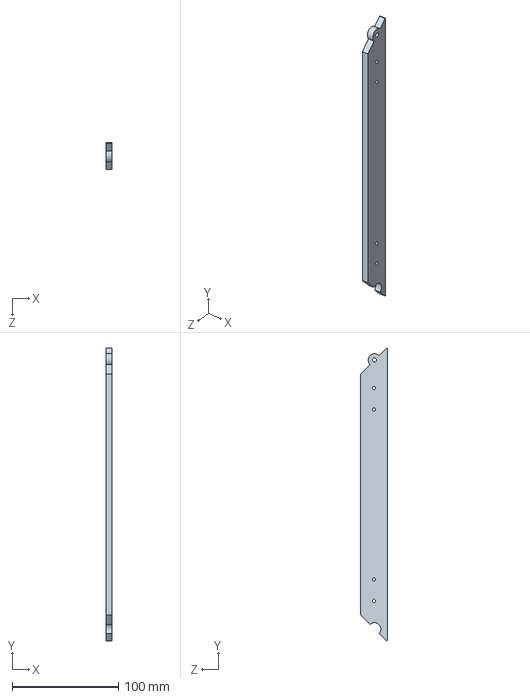
[picture p69: CAD file, 2026-11-09]
SolidWorks/FRAME_SIDE_VERTICAL_HOLED.SLDPRT
6.00 x 275.6 x 25.0 mm
