OilyT/ShroomShedMKII/SolidWorks/Floor.SLDPRT

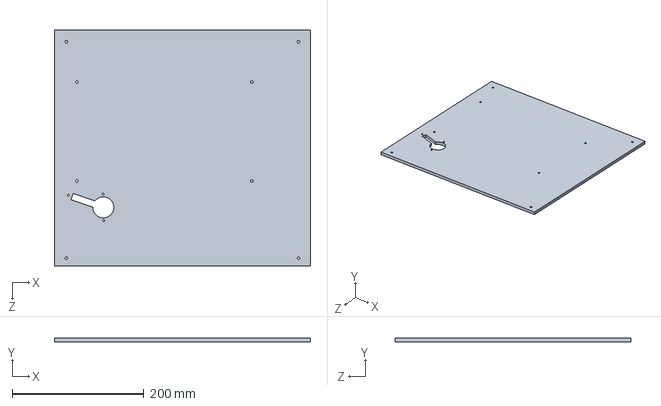
[picture p70: CAD file, 2026-11-09]
SolidWorks/Floor.SLDPRT
388.0 x 6.00 x 358.0 mm
