OilyT/ShroomShedMKII/SolidWorks/foot.SLDPRT

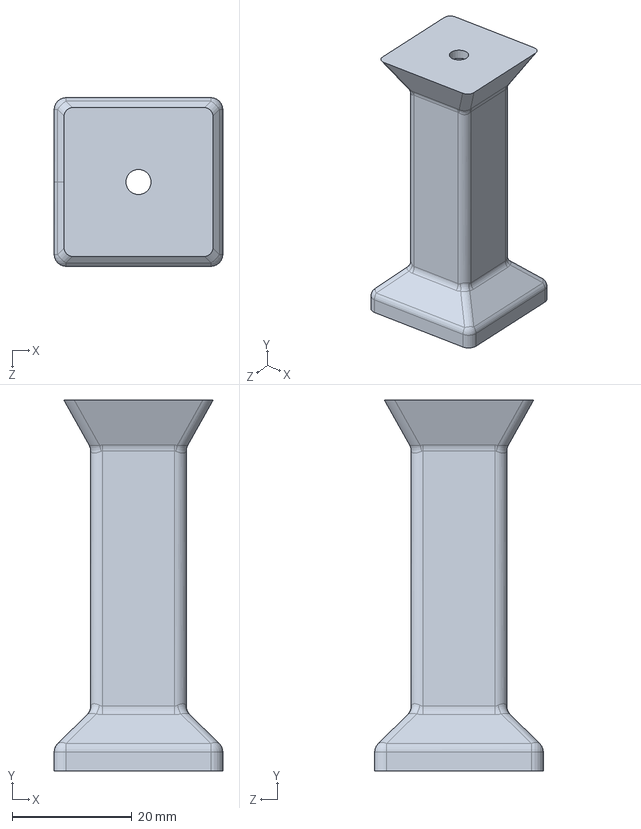
[picture p71: CAD file, 2026-11-09]
SolidWorks/foot.SLDPRT
28.2 x 62.0 x 28.2 mm
