OilyT/ShroomShedMKII/SolidWorks/FRAME_REAR_VERT.SLDPRT

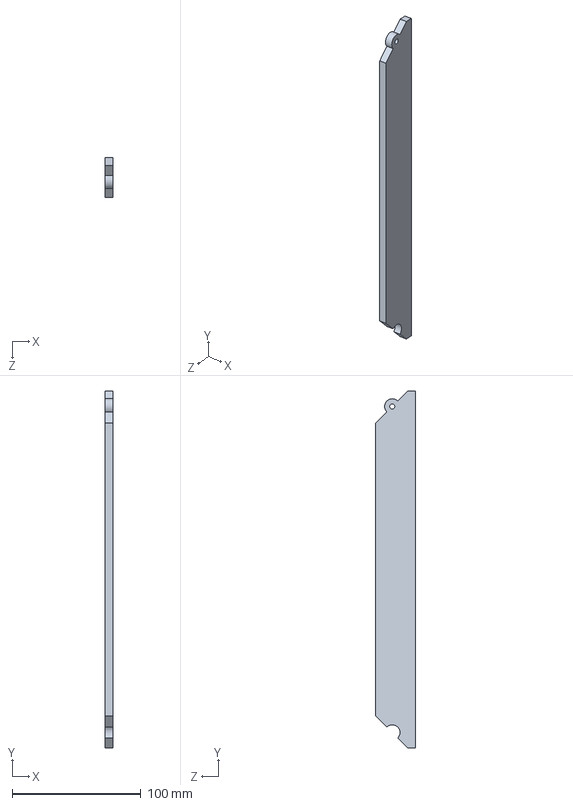
[picture p72: CAD file, 2026-11-09]
SolidWorks/FRAME_REAR_VERT.SLDPRT
6.00 x 277.0 x 31.0 mm
