OilyT/ShroomShedMKII/SolidWorks/FRAME_TOP_SIDE.SLDPRT

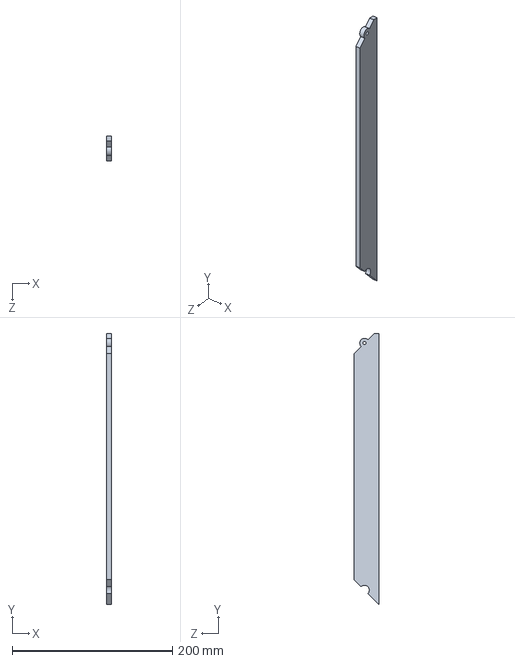
[picture p73: CAD file, 2026-11-09]
SolidWorks/FRAME_TOP_SIDE.SLDPRT
6.00 x 338.0 x 31.0 mm
