OilyT/ShroomShedMKII/SolidWorks/Left_Panel.SLDPRT

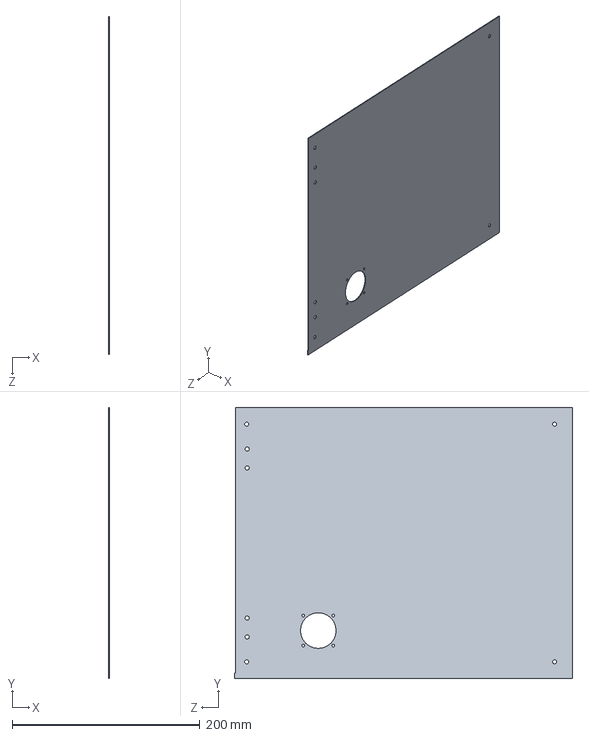
[picture p74: CAD file, 2026-11-09]
SolidWorks/Left_Panel.SLDPRT
1.00 x 289.0 x 360.0 mm
