OilyT/ShroomShedMKII/SolidWorks/humidifer_holder.SLDPRT

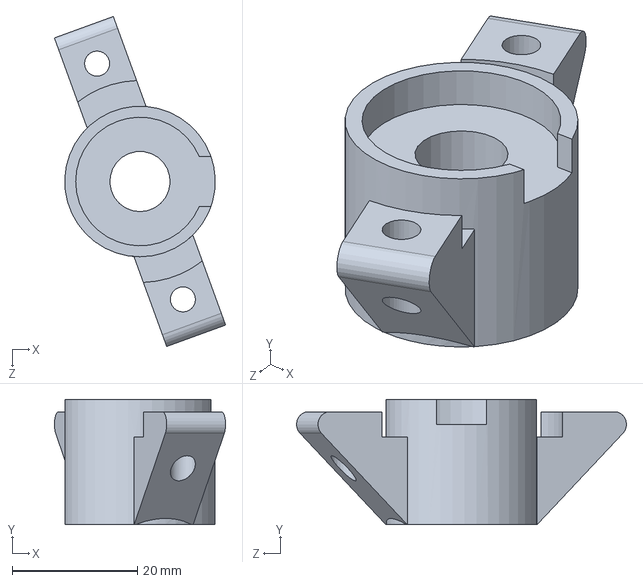
[picture p75: CAD file, 2026-11-09]
SolidWorks/humidifer_holder.SLDPRT
27.3 x 20.0 x 52.6 mm
