OilyT/ShroomShedMKII/SolidWorks/2,8 tft spi 240x320 v1.2 v2.SLDPRT

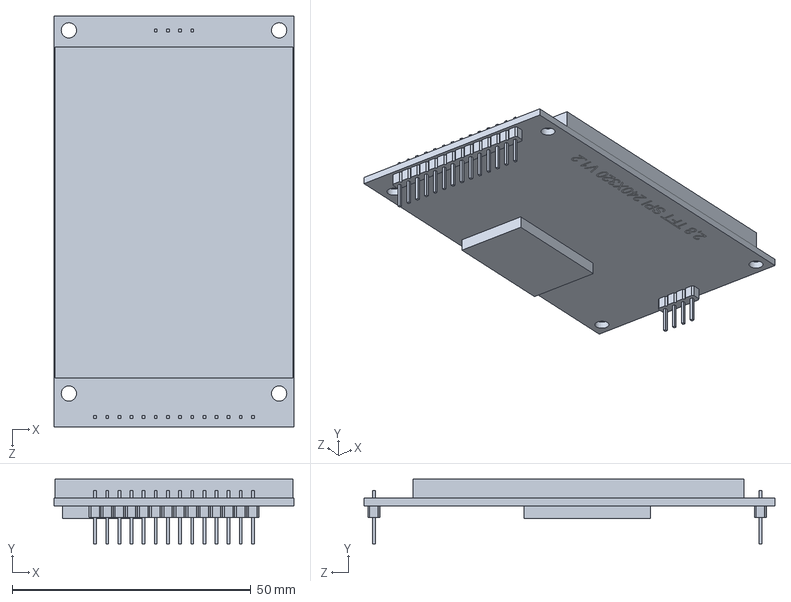
[picture p76: CAD file, 2026-11-09]
SolidWorks/2,8 tft spi 240x320 v1.2 v2.SLDPRT
50.2 x 13.6 x 86.0 mm
