OilyT/ShroomShedMKII/SolidWorks/Sensor_R1_housing.SLDPRT

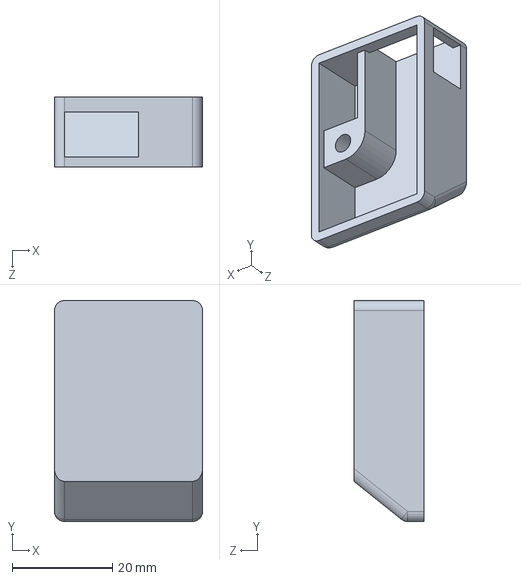
[picture p77: CAD file, 2026-11-09]
SolidWorks/Sensor_R1_housing.SLDPRT
29.5 x 44.0 x 14.0 mm
