OilyT/ShroomShedMKII/SolidWorks/L2_bracket_1H_1C.SLDPRT

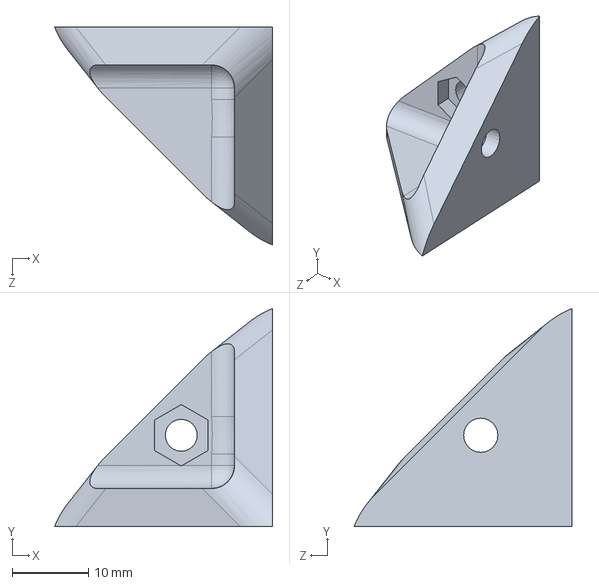
[picture p78: CAD file, 2026-11-09]
SolidWorks/L2_bracket_1H_1C.SLDPRT
28.7 x 28.7 x 28.7 mm
