OilyT/ShroomShedMKII/SolidWorks/FRAME_TOP_BACK.SLDPRT

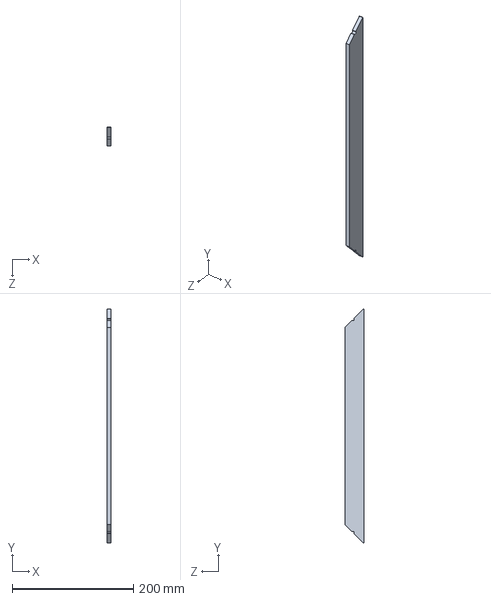
[picture p79: CAD file, 2026-11-09]
SolidWorks/FRAME_TOP_BACK.SLDPRT
6.00 x 386.6 x 31.0 mm
