OilyT/ShroomShedMKII/SolidWorks/L2_bracket_3H.SLDPRT

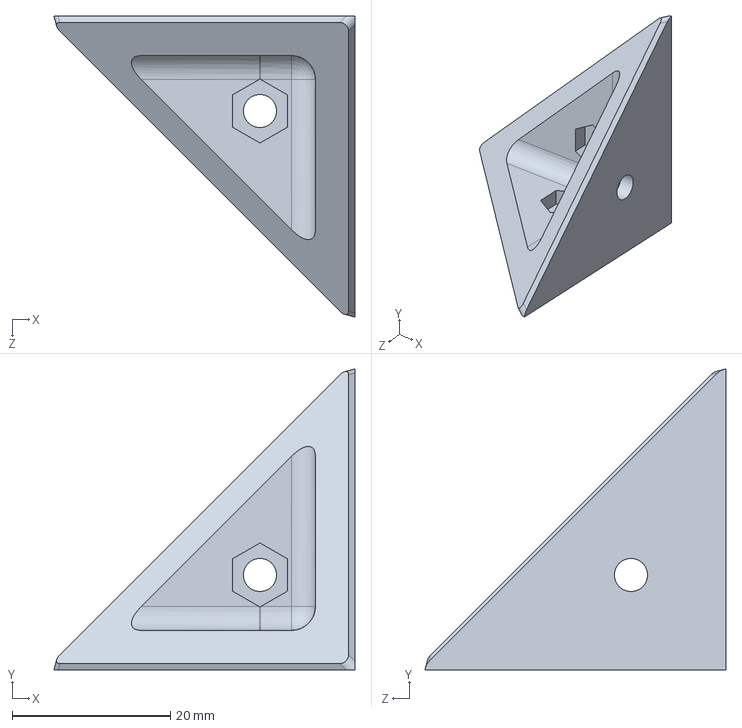
[picture p80: CAD file, 2026-11-09]
SolidWorks/L2_bracket_3H.SLDPRT
38.0 x 38.0 x 38.0 mm
