OilyT/ShroomShedMKII/SolidWorks/polcarb tub left bracket.SLDPRT

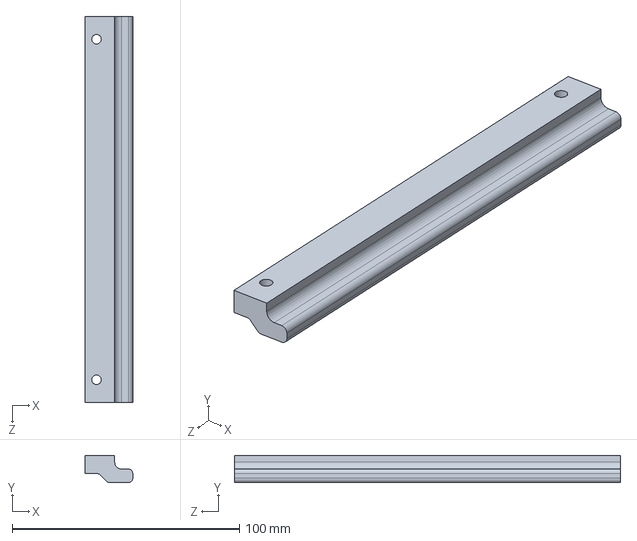
[picture p81: CAD file, 2026-11-09]
SolidWorks/polcarb tub left bracket.SLDPRT
21.0 x 12.0 x 170.0 mm
