OilyT/ShroomShedMKII/SolidWorks/FRAME_REAR_TOP.SLDPRT

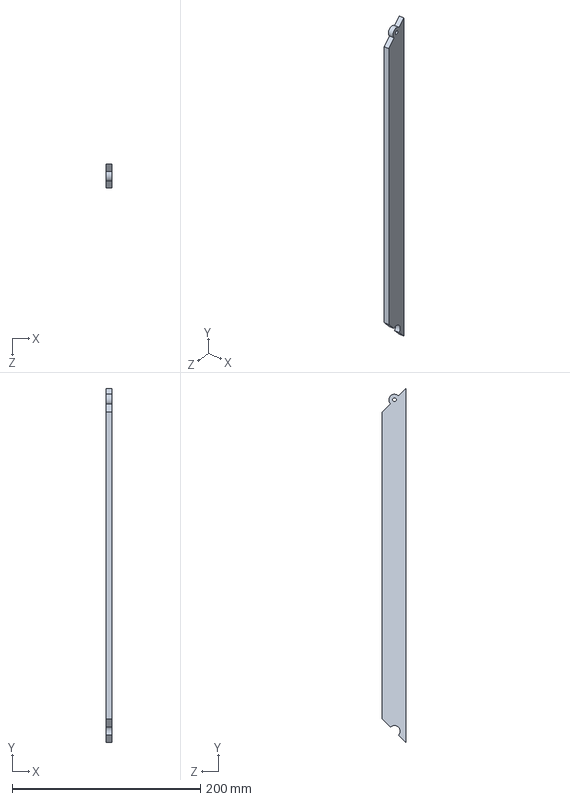
[picture p82: CAD file, 2026-11-09]
SolidWorks/FRAME_REAR_TOP.SLDPRT
6.00 x 376.0 x 25.0 mm
