OilyT/ShroomShedMKII/SolidWorks/L1_bracket_template.SLDPRT

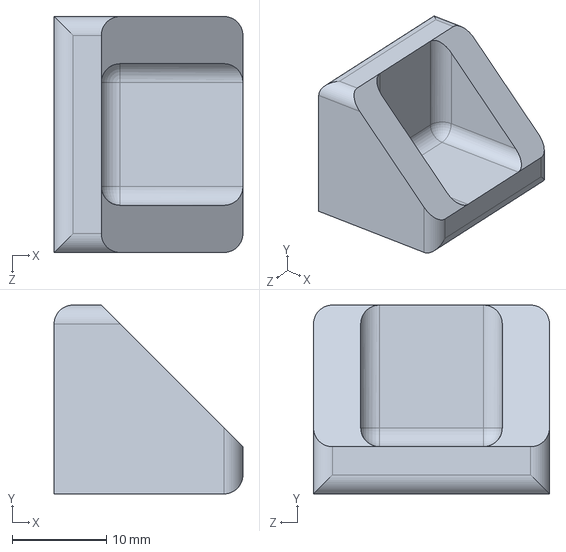
[picture p83: CAD file, 2026-11-09]
SolidWorks/L1_bracket_template.SLDPRT
20.0 x 20.0 x 25.0 mm
