OilyT/ShroomShedMKII/SolidWorks/foot_angled.SLDPRT

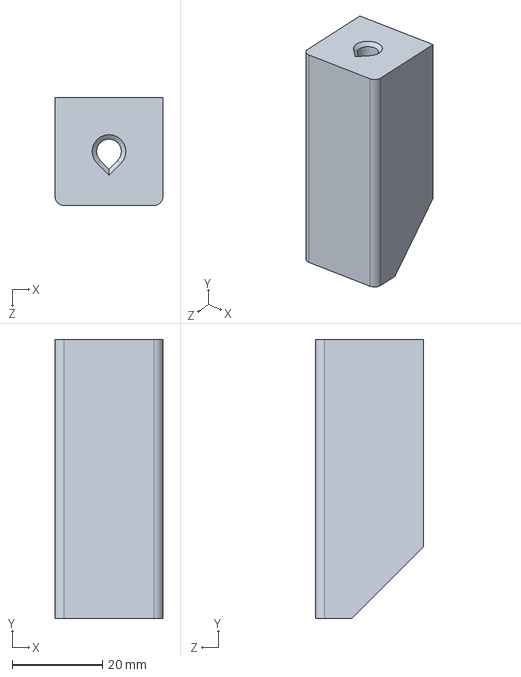
[picture p84: CAD file, 2026-11-09]
SolidWorks/foot_angled.SLDPRT
24.0 x 62.0 x 24.0 mm
