OilyT/ShroomShedMKII/SolidWorks/ERM_Cover.SLDPRT

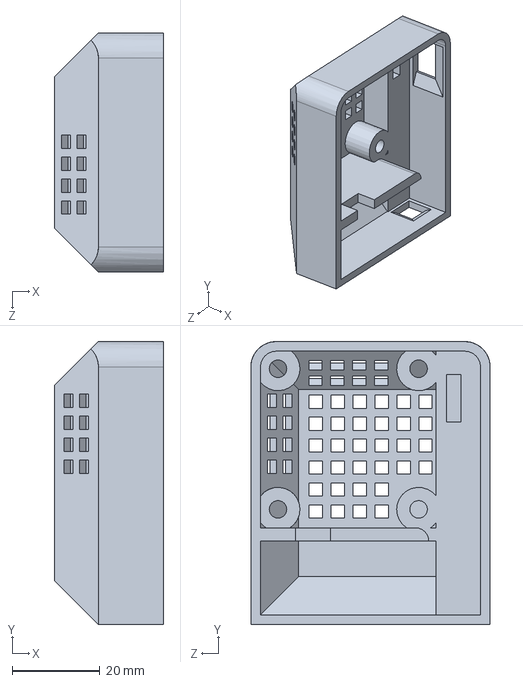
[picture p85: CAD file, 2026-11-09]
SolidWorks/ERM_Cover.SLDPRT
24.8 x 64.4 x 54.5 mm
