OilyT/ShroomShedMKII/SolidWorks/Top_Panel_.SLDPRT

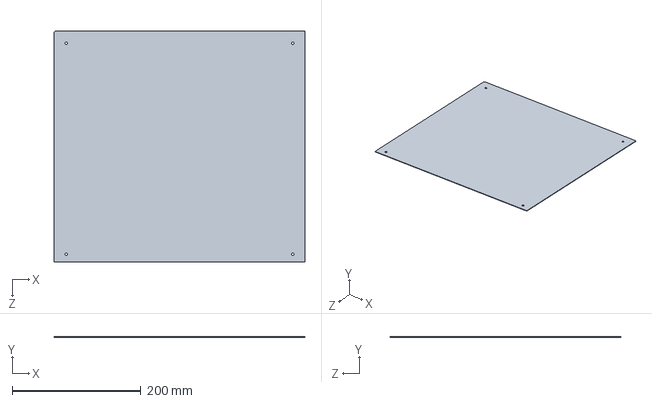
[picture p86: CAD file, 2026-11-09]
SolidWorks/Top_Panel_.SLDPRT
390.0 x 1.00 x 359.0 mm
