OilyT/ShroomShedMKII/SolidWorks/SHT31_V2_Housing.SLDPRT

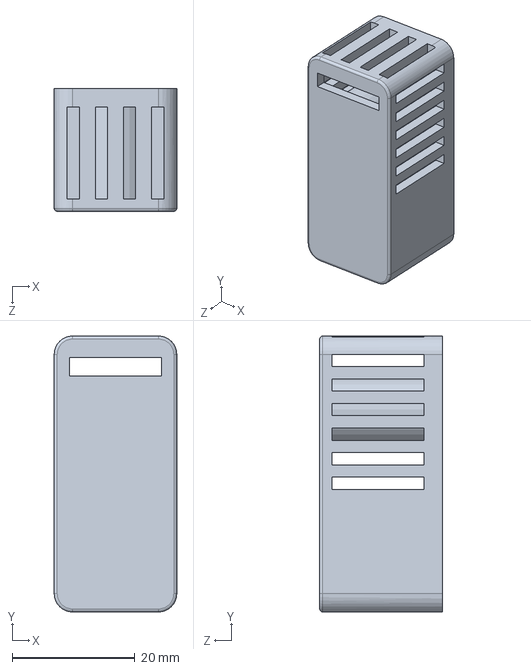
[picture p87: CAD file, 2026-04-28]
SolidWorks/SHT31_V2_Housing.SLDPRT
20.0 x 45.0 x 20.0 mm
