OilyT/ShroomShedMKII/SolidWorks/TEMP_FEET.SLDPRT

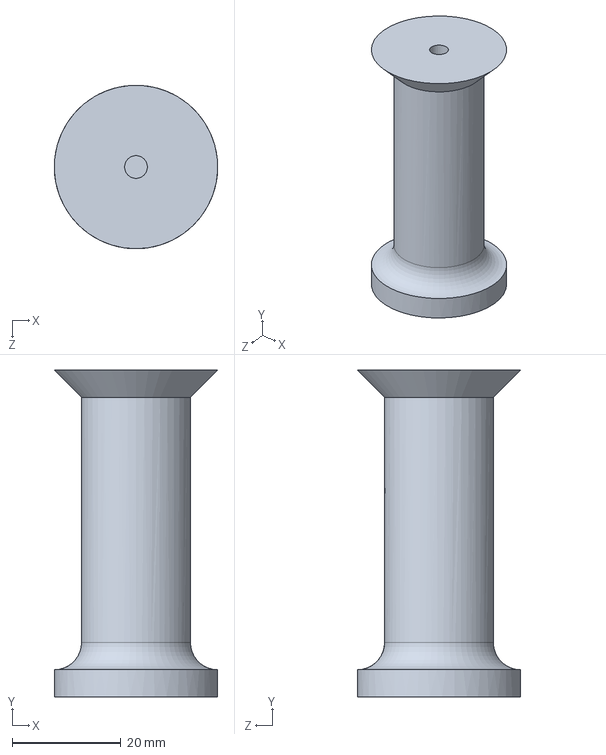
[picture p88: CAD file, 2026-04-28]
SolidWorks/TEMP_FEET.SLDPRT
30.0 x 60.0 x 30.0 mm
