OilyT/ShroomShedMKII/SolidWorks/magnet_stick_wall.SLDPRT

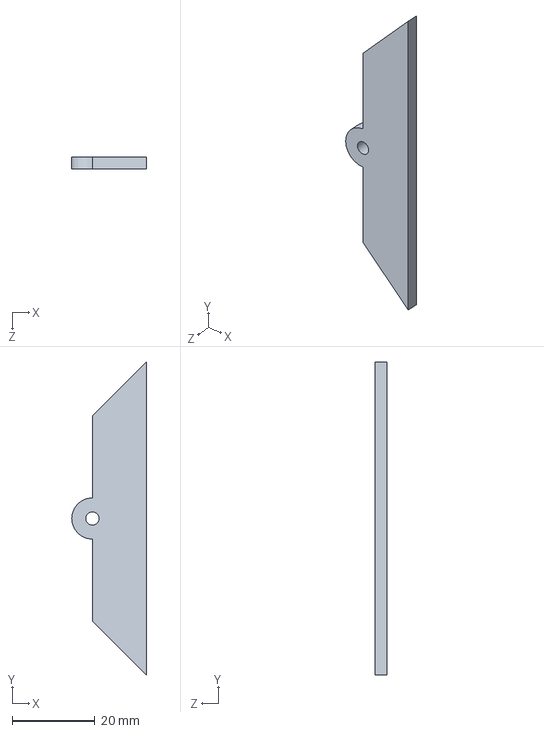
[picture p89: CAD file, 2026-04-28]
SolidWorks/magnet_stick_wall.SLDPRT
18.0 x 75.5 x 3.00 mm
