OilyT/ShroomShedMKII/SolidWorks/foot_well_2.SLDPRT

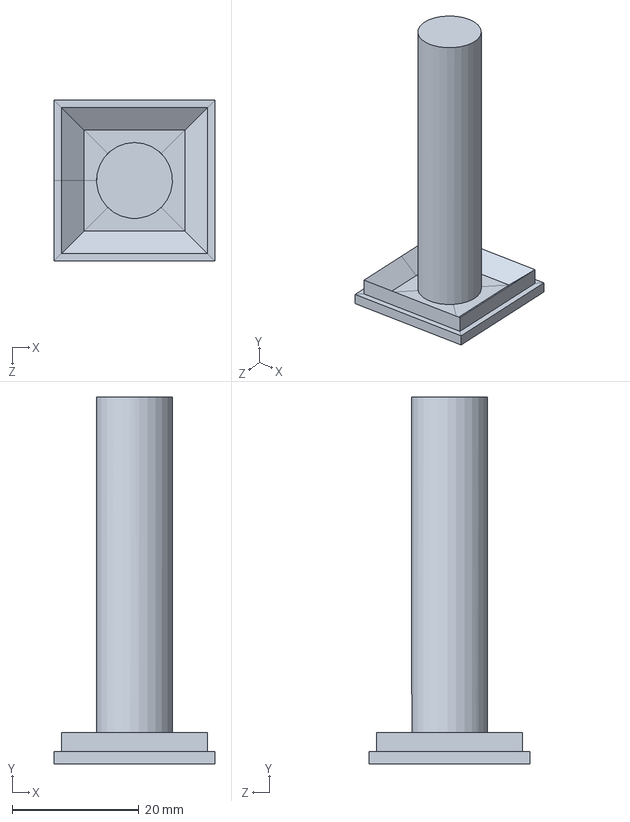
[picture p90: CAD file, 2026-04-09]
SolidWorks/foot_well_2.SLDPRT
25.4 x 58.0 x 25.4 mm
