OilyT/ShroomShedMKII/SolidWorks/Alu_extr_254_56.SLDPRT

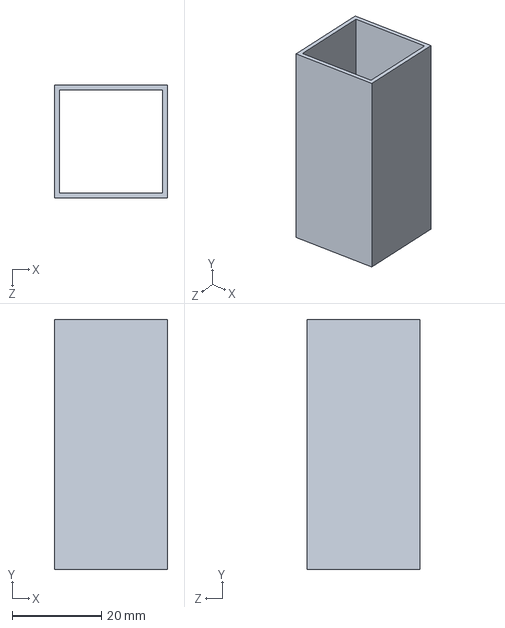
[picture p91: CAD file, 2026-04-09]
SolidWorks/Alu_extr_254_56.SLDPRT
25.4 x 56.0 x 25.4 mm
