OilyT/ShroomShedMKII/SolidWorks/L2_bracket_front_high_right.SLDPRT

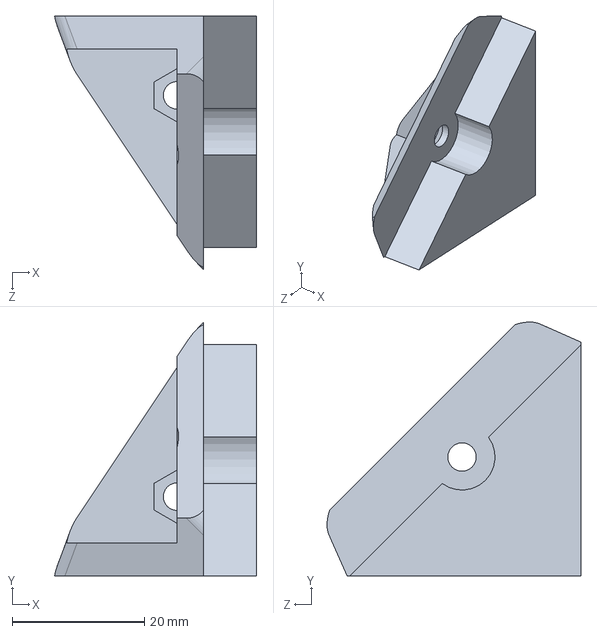
[picture p92: CAD file, 2026-04-01]
SolidWorks/L2_bracket_front_high_right.SLDPRT
30.6 x 38.4 x 38.4 mm
