OilyT/ShroomShedMKII/SolidWorks/door_handle.SLDPRT

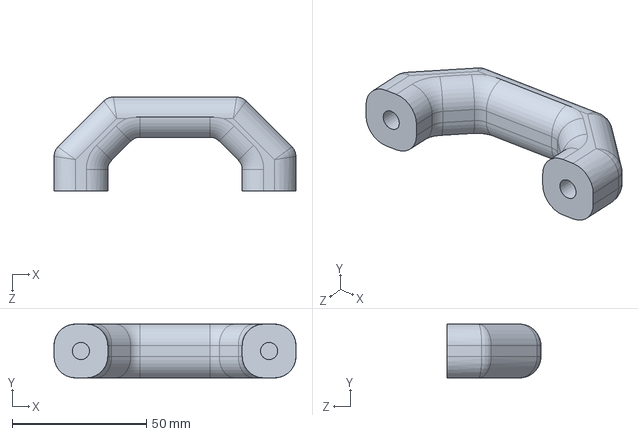
[picture p93: CAD file, 2026-04-01]
SolidWorks/door_handle.SLDPRT
90.0 x 20.0 x 35.0 mm
