OilyT/ShroomShedMKII/SolidWorks/magnetic_strip.SLDPRT

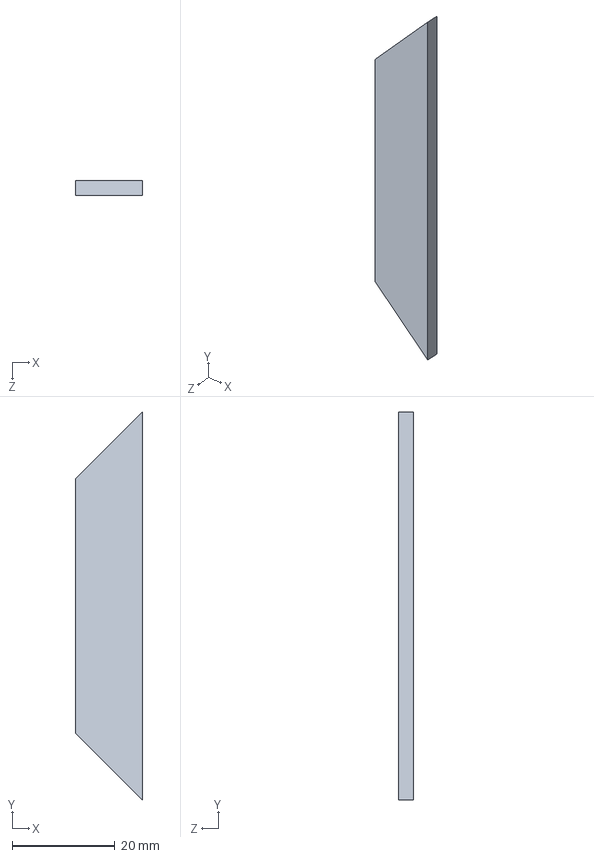
[picture p94: CAD file, 2026-04-01]
SolidWorks/magnetic_strip.SLDPRT
13.0 x 75.5 x 3.00 mm
