OilyT/ShroomShedMKII/SolidWorks/door_bracket.SLDPRT

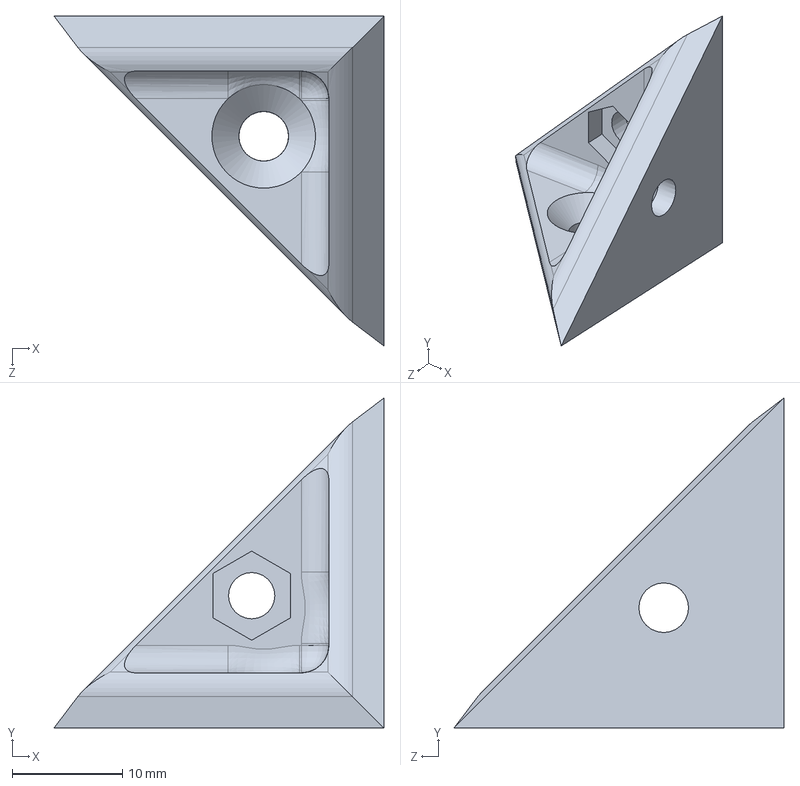
[picture p95: CAD file, 2026-03-16]
SolidWorks/door_bracket.SLDPRT
29.9 x 29.9 x 29.9 mm
