OilyT/ShroomShedMKII/SolidWorks/Tri_Bracket_.SLDPRT

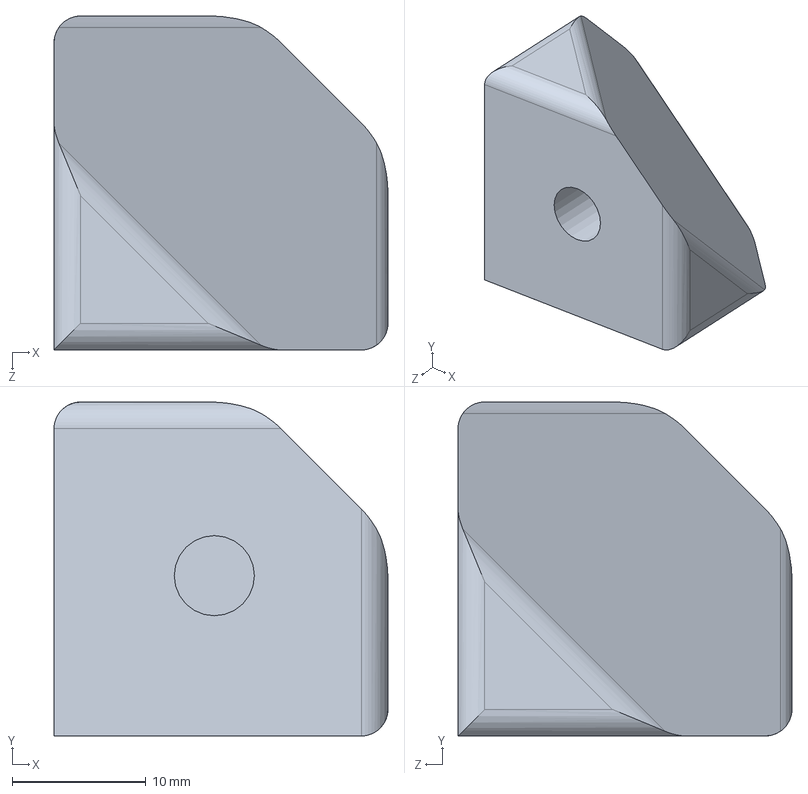
[picture p96: CAD file, 2026-03-05]
SolidWorks/Tri_Bracket_.SLDPRT
25.0 x 25.0 x 25.0 mm
