OilyT/ShroomShedMKII/SolidWorks/Tri_Bracket_Door.SLDPRT

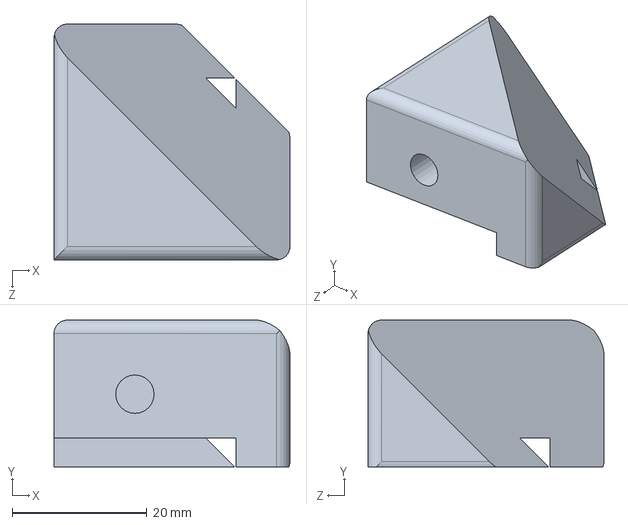
[picture p97: CAD file, 2026-03-05]
SolidWorks/Tri_Bracket_Door.SLDPRT
35.0 x 21.8 x 35.0 mm
