OilyT/ShroomShedMKII/SolidWorks/mag_ protector.SLDPRT

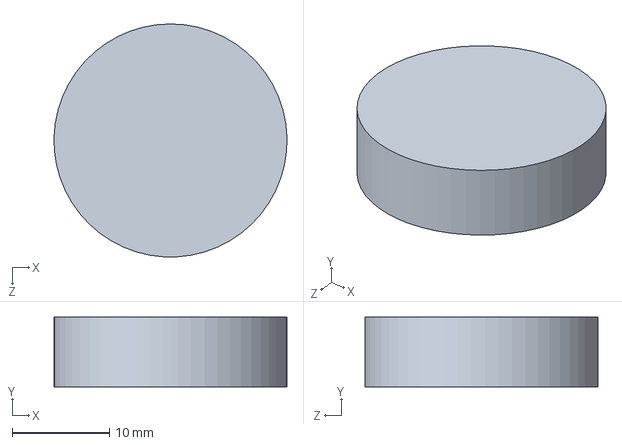
[picture p98: CAD file, 2026-03-05]
SolidWorks/mag_ protector.SLDPRT
24.0 x 7.20 x 24.0 mm
