OilyT/ShroomShedMKII/SolidWorks/Sensor_Exhaust.SLDPRT

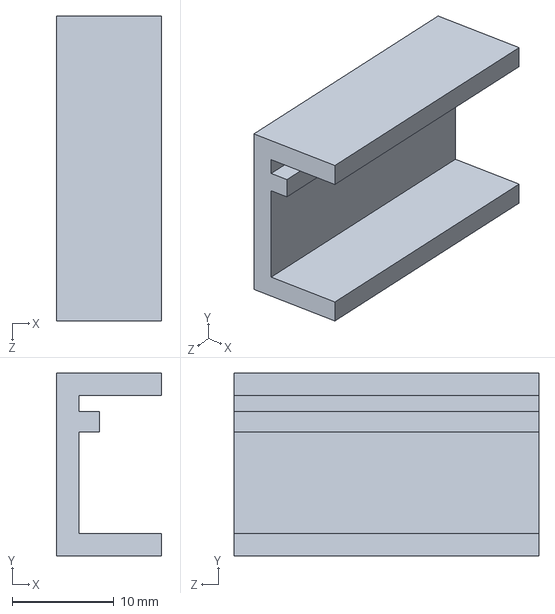
[picture p99: CAD file, 2026-02-06]
SolidWorks/Sensor_Exhaust.SLDPRT
10.3 x 18.0 x 30.0 mm
