OilyT/ShroomShedMKII/SolidWorks/FRAME_SIDE_2Piece_ECH.SLDPRT

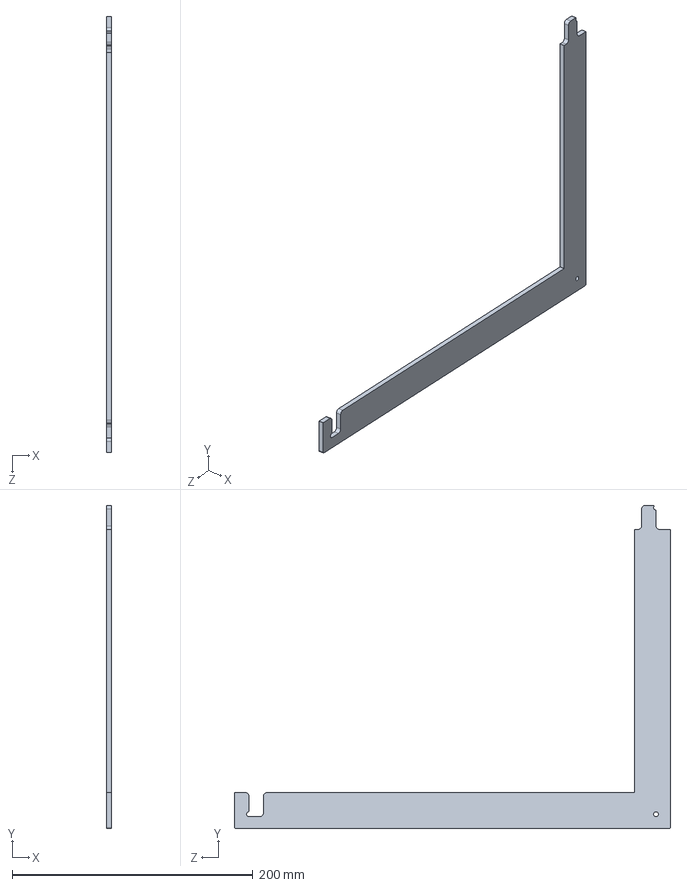
[picture p100: CAD file, 2026-02-02]
SolidWorks/FRAME_SIDE_2Piece_ECH.SLDPRT
4.50 x 268.5 x 362.0 mm
