OilyT/ShroomShedMKII/SolidWorks/Tri_Bracket_rebuild.SLDPRT

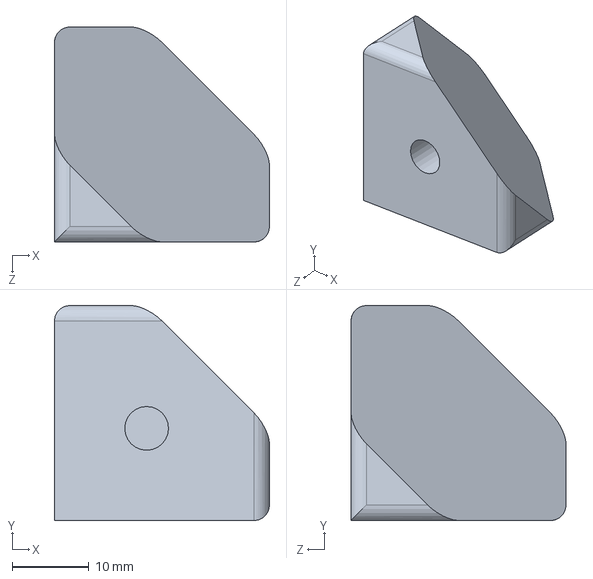
[picture p101: CAD file, 2026-02-02]
SolidWorks/Tri_Bracket_rebuild.SLDPRT
28.0 x 28.0 x 28.0 mm
