OilyT/ShroomShedMKII/SolidWorks/FRAME_TOP_2Piece.SLDPRT

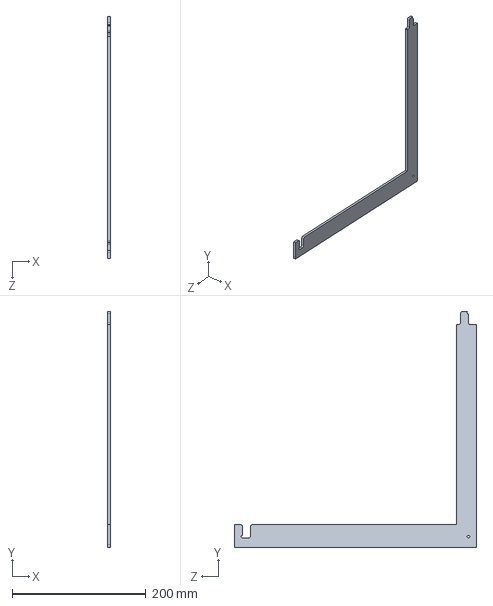
[picture p102: CAD file, 2026-02-02]
SolidWorks/FRAME_TOP_2Piece.SLDPRT
4.50 x 353.5 x 362.0 mm
