OilyT/ShroomShedMKII/SolidWorks/DXF/PC_multi_cuts.SLDASM

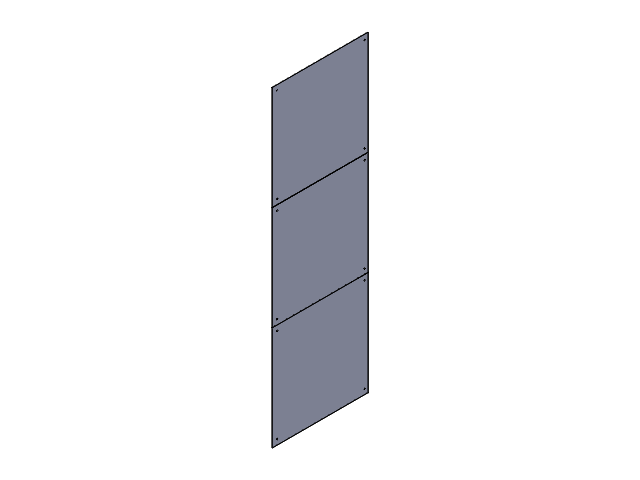
[picture p103: CAD file, 2026-10-27]
SolidWorks/DXF/PC_multi_cuts.SLDASM
Top_Panel_ x 3
