OilyT/ShroomShedMKII/SolidWorks/ERM_PCB.SLDASM

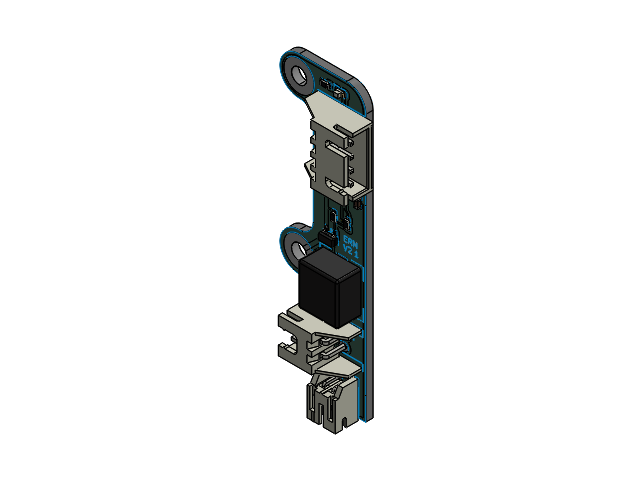
[picture p105: CAD file, 2026-11-09]
SolidWorks/ERM_PCB.SLDASM
JST_XH_S2B-XH-A-1_1x02_P2.50mm_Horizontal.step
R_0603_1608Metric.step x 5
C_0603_1608Metric.step x 2
L_Coilcraft_XAL8050-223.step
JST_PH_S2B-PH-K_1x02_P2.00mm_Horizontal.step
SOT-23.step x 2
JST_XH_S4B-XH-A-1_1x04_P2.50mm_Horizontal.step
LED_0603_1608Metric.step
ERM_PCB_copper.step
ERM_PCB_pad.step
ERM_PCB_via.step
ERM_PCB_silkscreen.step
ERM_PCB_soldermask.step
ERM_PCB_soldermask-0.step
ERM_PCB_PCB.step
