OilyT/ShroomShedMKII/SolidWorks/Sensor_assembly.SLDASM

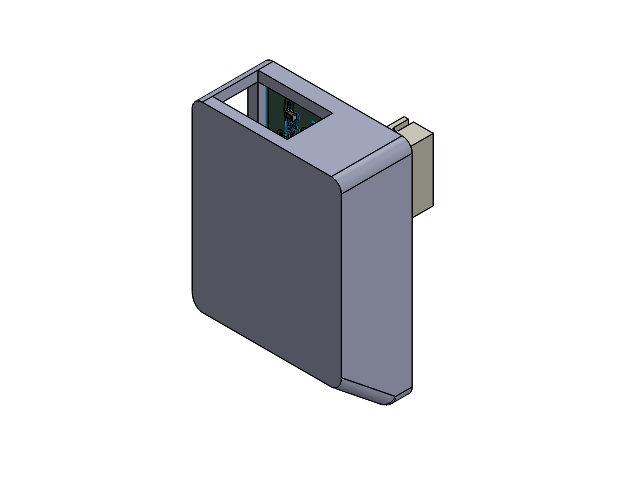
[picture p107: CAD file, 2026-11-09]
SolidWorks/Sensor_assembly.SLDASM
Sensor_R1_housing
LED_0603_1608Metric_1.step
C_0603_1608Metric_1.step x 3
R_0603_1608Metric_1.step x 3
JST_XH_B4B-XH-A_1x04_P2.50mm_Vertical.step
ShroomShed_Sensor_copper.step
ShroomShed_Sensor_pad.step
ShroomShed_Sensor_via.step
ShroomShed_Sensor_silkscreen.step
ShroomShed_Sensor_silkscreen-0.step
ShroomShed_Sensor_soldermask.step
ShroomShed_Sensor_soldermask-1.step
ShroomShed_Sensor_PCB.step
