OilyT/ShroomShedMKII/SolidWorks/Top_assembly.SLDASM

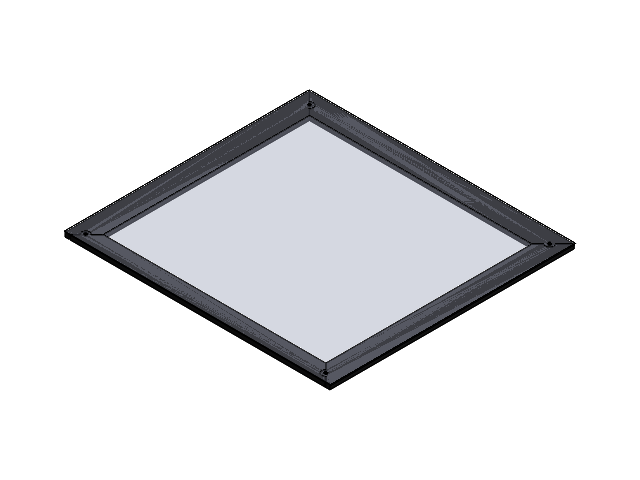
[picture p108: CAD file, 2026-11-09]
SolidWorks/Top_assembly.SLDASM
Top_Panel_
FRAME_TOP_FRONT
FRAME_TOP_SIDE
FRAME_TOP_BACK
FRAME_TOP_SIDE_2
