OilyT/ShroomShedMKII/SolidWorks/ShroomShed_MKII.SLDASM

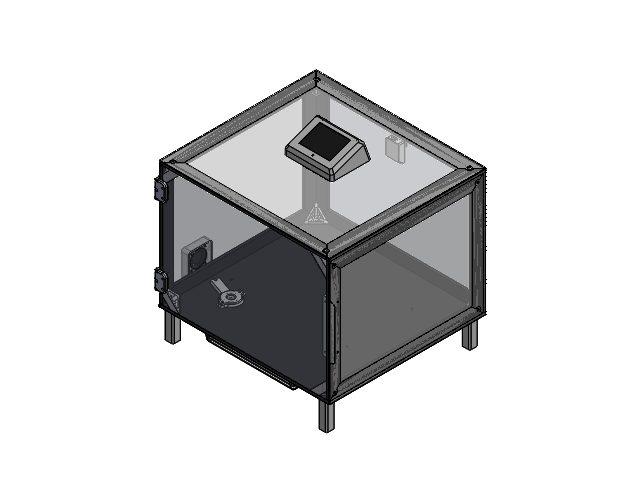
[picture p109: CAD file, 2026-11-09]
SolidWorks/ShroomShed_MKII.SLDASM
Floor
FRAME_SIDE_VERTICAL x 2
FRAME_SIDE_HORIZONTAL x 4
FRAME_SIDE_VERTICAL_HOLED_RIGHT
Right_Panel
L2_bracket_2H_1C x 2
L2_bracket_3H x 2
V3_bracket_front_RIGHT
V3_bracket_front_TOP x 2
Controller_Module
2,8 tft spi 240x320 v1.2 v2
C_0603_1608Metric_1.step x 27
LED_RGB_5050-6_1.step x 12
R_0603_1608Metric_1.step x 22
SW_SPST_PTS647Sx50_1.step
JST_XH_S4B-XH-A-1_1x04_P2.50mm_Horizontal_1.step x 2
USB_C_Receptacle_GCT_USB4085_1.step
C_0805_2012Metric_1.step x 2
CP_Elec_6.3x5.4_1.step
L_TechFuse_SL0630_1.step
Fuse_1210_3225Metric_1.step
SOIC-8_3.9x4.9mm_P1.27mm_1.step x 4
Crystal_SMD_3225-4Pin_3.2x2.5mm_1.step
SOT-223_1.step
PinHeader_2x07_P1.27mm_Vertical_SMD_1.step
SOT-23_1.step
SOT-23-6_1.step
VSSOP-8_3x3mm_P0.65mm_1.step
LQFP-100_14x14mm_P0.5mm_1.step
SW_SPDT_PCM12_1.step
LED_0603_1608Metric_1.step x 2
D_SMA_1.step
LED_D4.0mm_Blue_1.step
PinSocket_1x04_P2.54mm_Vertical_1.step
PinSocket_1x14_P2.54mm_Vertical_1.step
ShroomShed_MKII_PCB_silkscreen_1.step
ShroomShed_MKII_PCB_silkscreen-0_1.step
ShroomShed_MKII_PCB_PCB_1.step
Top_Panel_
FRAME_TOP_FRONT
FRAME_TOP_SIDE
FRAME_TOP_BACK
FRAME_TOP_SIDE_2
FRAME_SIDE_VERTICAL_HOLED
Left_Panel
V3_bracket_front_LEFT
Rear_Panel
FRAME_REAR_BOTT
FRAME_REAR_VERT x 2
FRAME_REAR_TOP
ERM_Cover
404010 fan v5
JST_XH_S2B-XH-A-1_1x02_P2.50mm_Horizontal.step
R_0603_1608Metric.step x 5
C_0603_1608Metric.step x 2
L_Coilcraft_XAL8050-223.step
JST_PH_S2B-PH-K_1x02_P2.00mm_Horizontal.step
SOT-23.step x 2
JST_XH_S4B-XH-A-1_1x04_P2.50mm_Horizontal.step
LED_0603_1608Metric.step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
