OilyT/ShroomShedMKII/SolidWorks/foot_assembly_2.SLDASM

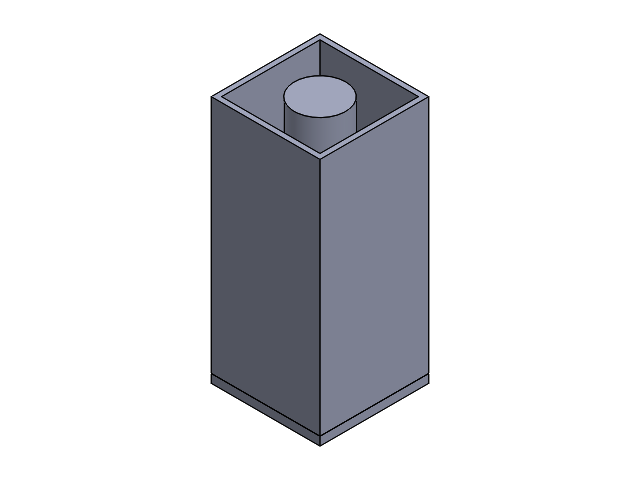
[picture p110: CAD file, 2026-04-09]
SolidWorks/foot_assembly_2.SLDASM
foot_well_2
Alu_extr_254_56
