OilyT/ShroomShedMKII/SolidWorks/EC_box.SLDASM

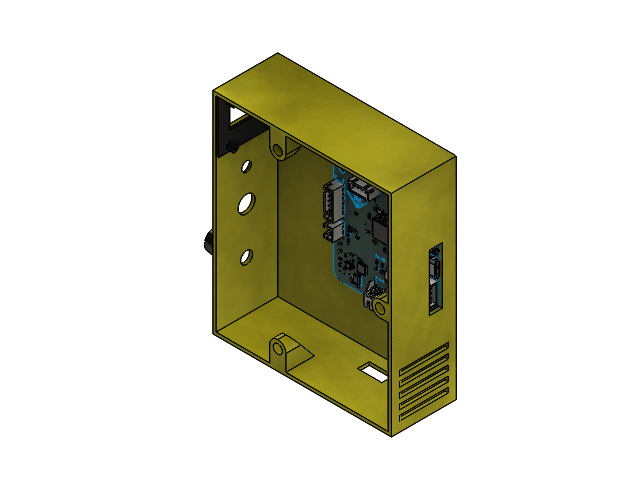
[picture p111: CAD file, 2026-04-01]
SolidWorks/EC_box.SLDASM
Electronics_housing_Lateral
TYPE-C-31-M-12-0.step
JST_XH_B2B-XH-A_1x02_P2.50mm_Vertical.step
R_0603_1608Metric.step x 24
C_0603_1608Metric.step x 16
SW_SPDT_PCM12.step
D_SMA.step x 2
JST_XH_S4B-XH-A_1x04_P2.50mm_Horizontal.step
LED_0603_1608Metric.step x 7
JST_XH_B6B-XH-A_1x06_P2.50mm_Vertical.step
SW_SPST_PTS647Sx50.step
SOT-23.step
Fuse_1210_3225Metric.step
VSSOP-8_3x3mm_P0.65mm.step
VSSOP-8_3.0x3.0mm_P0.65mm.step
CP_Elec_10x10.5.step
JST_XH_B4B-XH-A_1x04_P2.50mm_Vertical.step
L_APV_ANR5012.step
JST_XH_S3B-XH-A_1x03_P2.50mm_Horizontal.step
PinHeader_2x03_P2.54mm_Vertical_SMD.step
TQFP-44_10x10mm_P0.8mm.step
X322516MLB4SI.step
ShroomShed_V1_silkscreen.step
ShroomShed_V1_soldermask.step
ShroomShed_V1_soldermask-1.step
ShroomShed_V1_PCB.step
Display_bracket
