OilyT/ShroomShedMKII/SolidWorks/ShroomShed_MKII_CONTROLLER.SLDASM

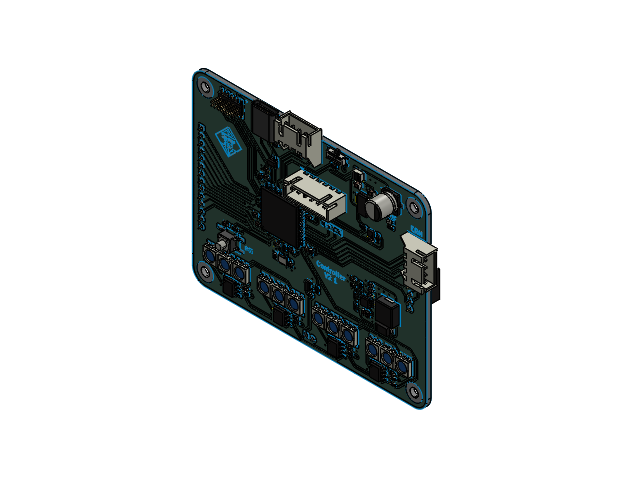
[picture p112: CAD file, 2026-02-20]
SolidWorks/ShroomShed_MKII_CONTROLLER.SLDASM
C_0603_1608Metric.step x 25
LED_RGB_5050-6.step x 12
R_0603_1608Metric.step x 21
SW_SPST_PTS647Sx50.step
JST_XH_B6B-XH-A_1x06_P2.50mm_Vertical.step
JST_XH_S4B-XH-A-1_1x04_P2.50mm_Horizontal.step x 2
USB_C_Receptacle_GCT_USB4085.step
C_0805_2012Metric.step x 2
CP_Elec_6.3x7.7.step
L_TechFuse_SL0630.step
Fuse_1210_3225Metric.step
SOIC-8_3.9x4.9mm_P1.27mm.step x 4
Crystal_SMD_3225-4Pin_3.2x2.5mm.step
SOT-223.step
PinHeader_2x07_P1.27mm_Vertical_SMD.step
SOT-23.step
DFN-6-1EP_2x2mm_P0.5mm_EP0.61x1.42mm.step
SOT-23-6.step
VSSOP-8_3x3mm_P0.65mm.step
LQFP-100_14x14mm_P0.5mm.step
SW_SPDT_PCM12.step
LED_0603_1608Metric.step
D_SMA.step
LED_D4.0mm_Blue.step
PinSocket_1x04_P2.54mm_Vertical.step
PinSocket_1x14_P2.54mm_Vertical.step
ShroomShed_MKII_PCB_copper.step
ShroomShed_MKII_PCB_pad.step
ShroomShed_MKII_PCB_via.step
ShroomShed_MKII_PCB_silkscreen.step
ShroomShed_MKII_PCB_silkscreen-0.step
ShroomShed_MKII_PCB_soldermask.step
ShroomShed_MKII_PCB_soldermask-1.step
ShroomShed_MKII_PCB_PCB.step
