OilyT/ShroomShedMKII/SolidWorks/Sensor.SLDASM

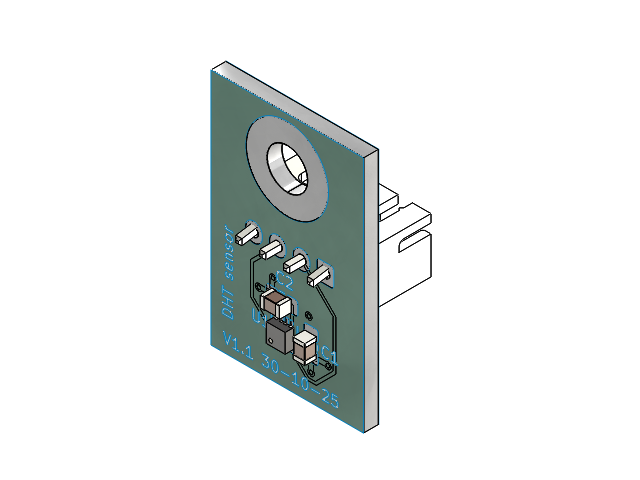
[picture p113: CAD file, 2026-02-20]
SolidWorks/Sensor.SLDASM
DFN-8-1EP_2x2mm_P0.5mm_EP0.6x1.2mm.step
C_0805_2012Metric.step x 2
JST_XH_B4B-XH-A_1x04_P2.50mm_Vertical.step
SHT31_copper.step
SHT31_pad.step
SHT31_via.step
SHT31_silkscreen.step
SHT31_silkscreen-0.step
SHT31_soldermask.step
SHT31_soldermask-1.step
SHT31_PCB.step
