OilyT/ShroomShedMKII/SolidWorks/2-8in 240x320 TFT LCD ILI9341.SLDASM

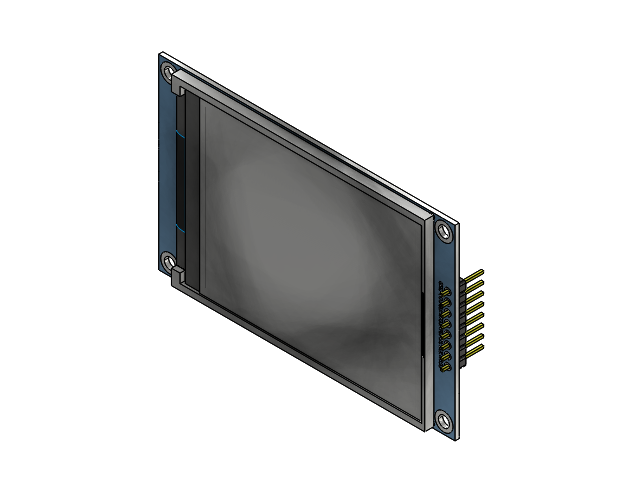
[picture p115: CAD file, 2026-02-02]
SolidWorks/2-8in 240x320 TFT LCD ILI9341.SLDASM
Pino.step
Base.step
Pino001.step
Base001.step
Pino002.step
Base002.step
Pino003.step
Base003.step
Pino004.step
Base004.step
Pino005.step
Base005.step
Pino006.step
Base006.step
Pino007.step
Base007.step
PCB.step
Frame.step
LCD.step
Glass.step
