OilyT/ShroomShedMKII/SolidWorks/Foot_ass.SLDASM

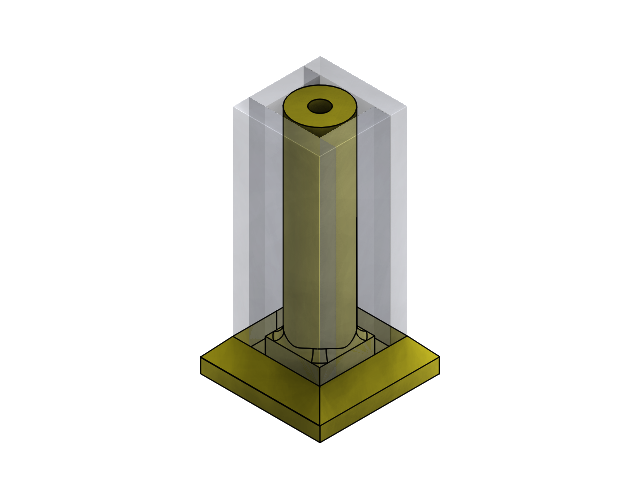
[picture p116: CAD file, 2026-02-02]
SolidWorks/Foot_ass.SLDASM
foot_well
Foot_wall_long x 2
Foot_wall_short x 2
