OilyT/ShroomShedMKII/(list of files, cad)

Other CAD files:
MFG/ShroomShed 0.1/DXF/Frame_cuts_all.SLDASM
SolidWorks/Left_Assembly.SLDASM
SolidWorks/Exhaust_Sensor_assembly.SLDASM
SolidWorks/L2_bracket_front_low_left.SLDPRT
SolidWorks/proto/Hinge 2 Piece.STL
MFG/ShroomShed 0.1/STL/L2_bracket_front_low_left.STL
SolidWorks/proto/V3_bracket_front_RIGHT.STL
SolidWorks/proto/hinge_bracket.STL
SolidWorks/proto/Hinge 2 Piece_m4_threadholed.STL
SolidWorks/proto/V3_bracket_front_LEFT.STL
SolidWorks/L1_bracket_1H_1C.SLDPRT
SolidWorks/proto/L1_bracket_2H.STL
SolidWorks/HUMIDIFIER_CAP.SLDPRT
SolidWorks/V3_bracket_front_TOP.SLDPRT
SolidWorks/L1_bracket_2H.SLDPRT
SolidWorks/L2_bracket_front_high.SLDPRT
SolidWorks/Transducer_Lid_CONV_V2.SLDPRT
SolidWorks/FRAME_SIDE_VERTICAL.SLDPRT
SolidWorks/V3_bracket_front_base.SLDPRT
SolidWorks/Right_Panel.SLDPRT
SolidWorks/V3_bracket_front_LEFT.SLDPRT
SolidWorks/FRAME_SIDE_VERTICAL_HOLED_RIGHT.SLDPRT
SolidWorks/L1_bracket_1H_1C_MAG_Bracket.SLDPRT
SolidWorks/foot_flat.SLDPRT
SolidWorks/FRAME_REAR_BOT.SLDPRT
SolidWorks/FRAME_TOP_FRONT.SLDPRT
SolidWorks/FRAME_TOP_SIDE_2.SLDPRT
SolidWorks/V3_bracket_front_RIGHT.SLDPRT
SolidWorks/L2_bracket_front_low_right.SLDPRT
SolidWorks/Wick_cutting_jig_56mm.SLDPRT
SolidWorks/Wick_cutting_jig_58mm.SLDPRT
SolidWorks/L2_bracket_1H_1C_1M.SLDPRT
SolidWorks/L2_bracket_front_low.SLDPRT
SolidWorks/FRAME_SIDE_2Piece.SLDPRT
MFG/ShroomShed 0.1/DXF/Frame_cuts_all.DXF
MFG/ShroomShed 0.1/STL/Legacy/Controller_Module_V1.STL
MFG/ShroomShed 0.1/STL/Legacy/SHT31_V2_Housing.STL
MFG/ShroomShed 0.1/STL/Legacy/Tri_Bracket_.STL
ShroomShed_MKII_PCB/ERM_PCB/ERM_BOARD_TRACES.stl
ShroomShed_MKII_PCB/ShroomShedController_V22_simple.SLDASM
ShroomShed_MKII_PCB/ShroomShed_Sensor/Shroomshed_Sensor_R1_PCB.SLDASM
SolidWorks/404010 fan v5.SLDPRT
SolidWorks/AE_parts/AE_Hinge_31x40_A.STL
SolidWorks/AE_parts/AE_Hinge_31x40_ass.STL
SolidWorks/Controller_Module.SLDPRT
SolidWorks/DXF/Door_.DXF
SolidWorks/DXF/FRAME_SIDE_VERTICAL_HOLED.DXF
SolidWorks/DXF/FRAME_rear_vert.DXF
SolidWorks/DXF/FRAME_side_horizontal.DXF
SolidWorks/DXF/FRAME_top_side.DXF
SolidWorks/DXF/Floor.DXF
SolidWorks/DXF/Rear_Panel.DXF
SolidWorks/DXF/Top_Panel_.DXF
SolidWorks/Electronics_housing_Lateral.SLDPRT
SolidWorks/FRAME_SIDE_HORIZONTAL_TOP_LEFT.SLDPRT
SolidWorks/Foot_wall_long.SLDPRT
SolidWorks/Foot_wall_short.SLDPRT
SolidWorks/Rear_Panel.DXF
SolidWorks/STL/ERM_Cover.STL
SolidWorks/STL/L2_bracket_2H_1C.STL
SolidWorks/STL/Legacy/Controller_Module_V1.SLDPRT
SolidWorks/STL/Legacy/Controller_Module_V21.STL
SolidWorks/STL/Legacy/TEMP_FEET.STL
SolidWorks/STL/Legacy/Tri_Bracket_Door.STL
SolidWorks/STL/Legacy/foot_well.STL
SolidWorks/STL/Sensor_R1_housing.STL
SolidWorks/STL/ShroomShed_MKII.STL
SolidWorks/STL/TPU_SEAL_85mm.STL
SolidWorks/STL/Transducer_Lid_CONV.STL
SolidWorks/STL/V3_bracket_front_base.STL
SolidWorks/STL/door_handle.STL
SolidWorks/STL/foot.STL
SolidWorks/STL/humidifer_holder.STL
SolidWorks/STL/polcarb tub left bracket.STL
SolidWorks/Transducer_Lid_CONV.SLDPRT
SolidWorks/Tri_Bracket_MAGNET_.SLDPRT
SolidWorks/foot_well.SLDPRT
