OilyT/ShroomShedMKII/ShroomShed_MKII_PCB/ShroomShed_MKII_PCB.kicad_pcb

## KiCad design ShroomShed_MKII_PCB/ShroomShed_MKII_PCB.kicad_pcb (2026-11-09)

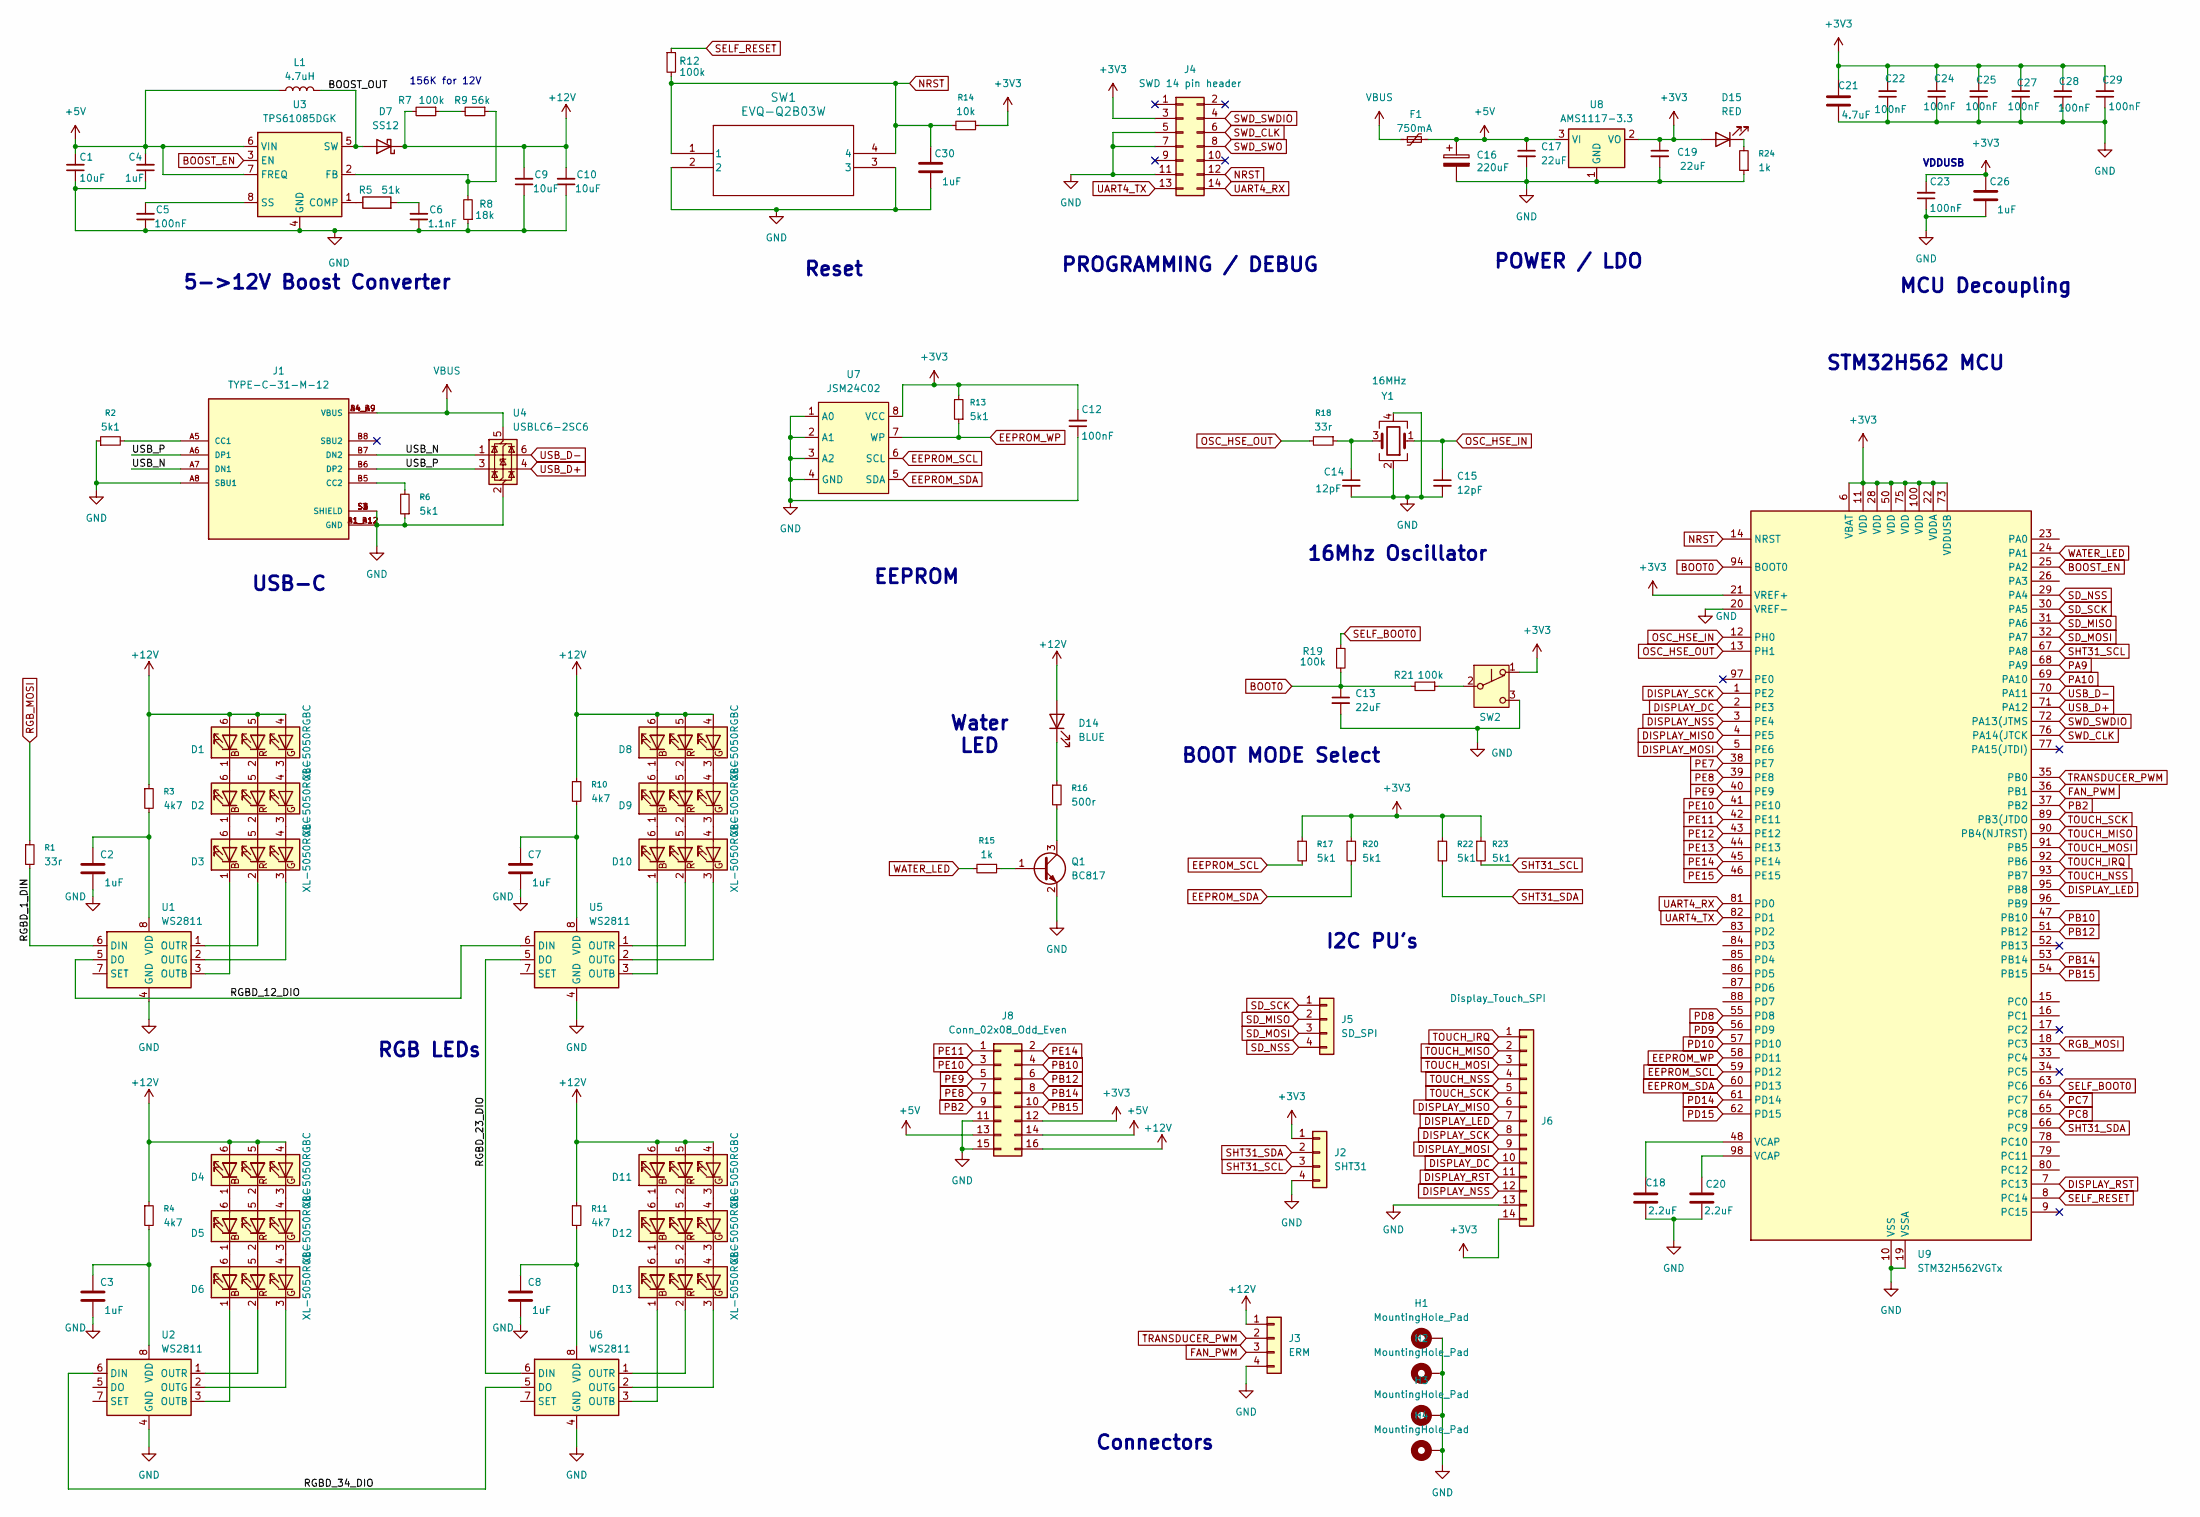
[picture p117: schematic ShroomShed_MKII_PCB.kicad_sch]

Parts:
C1, C9, C10: 10uF; C_0603_1608Metric
C2, C3, C4, C7, C8, C26, C30: 1uF; C_0603_1608Metric
C5, C12, C22, C23, C24, C25, C27, C28, C29: 100nF; C_0603_1608Metric
C6: 1.1nF; C_0603_1608Metric
C13, C17, C19: 22uF; C_0805_2012Metric
C14, C15: 12pF; C_0603_1608Metric
C16: 220uF; CP_Elec_6.3x5.4
C18, C20: 2.2uF; C_0603_1608Metric
C21: 4.7uF; C_0603_1608Metric
D1, D2, D3, D4, D5, D6, D8, D9, D10, D11, D12, D13: XL-5050RGBC; LED_RGB_5050-6
D7: SS12; D_SMA
D14: BLUE; LED_D4.0mm
D15: RED; LED_0603_1608Metric
F1: 750mA; Fuse_1210_3225Metric_Pad1.42x2.65mm_HandSolder
H1, H2, H3, H4: MountingHole_Pad; MountingHole_3.2mm_M3_Pad_Via
J1: TYPE-C-31-M-12; HRO_TYPE-C-31-M-12; PARTREV 2020.12.08
J2: SHT31; JST_XH_S4B-XH-A-1_1x04_P2.50mm_Horizontal; JLCPCB Part # C696092
J3: ERM; JST_XH_S4B-XH-A-1_1x04_P2.50mm_Horizontal; JLCPCB Part # C696092
J4: SWD 14 pin header; PinHeader_2x07_P1.27mm_Vertical_SMD
J5: SD_SPI; PinSocket_1x04_P2.54mm_Vertical; JLCPCB Part # C696092
J6: Display_Touch_SPI; PinSocket_1x14_P2.54mm_Vertical; JLCPCB Part # C505101
J8: Conn_02x08_Odd_Even; PinHeader_2x08_P2.54mm_Vertical
L1: 4.7uH; L_7.3x7.3_H4.5
Q1: BC817; SOT-23
R1, R18: 33r; R_0603_1608Metric
R2, R6, R13, R17, R20, R22, R23: 5k1; R_0603_1608Metric
R3, R4, R10, R11: 4k7; R_0603_1608Metric
R5: 51k; R_0603_1608Metric
R7, R12, R19, R21: 100k; R_0603_1608Metric
R8: 18k; R_0603_1608Metric
R9: 56k; R_0603_1608Metric
R14: 10k; R_0603_1608Metric
R15, R24: 1k; R_0603_1608Metric
R16: 500r; R_0603_1608Metric
SW1: EVQ-Q2B03W; EVQQ2_3_PAN
SW2: BOOT SELECT; MST-22D18G2 3J
U1, U2, U5, U6: WS2811; SOIC-8_3.9x4.9mm_P1.27mm
U3: TPS61085DGK; VSSOP-8_3x3mm_P0.65mm
U4: USBLC6-2SC6; SOT-23-6
U7: JSM24C02; SOIC-8_3.9x4.9mm_P1.27mm
U8: AMS1117-3.3; SOT-223-3_TabPin2
U9: STM32H562VGTx; LQFP-100_14x14mm_P0.5mm
Y1: 16MHz; Crystal_SMD_3225-4Pin_3.2x2.5mm; part# C13738

Connections:
+3V3: C12.2, C19.1, C21.1, C22.2, C23.2, C24.2, C25.2, C26.1, C27.2, C28.2, C29.2, D15.2 (A), J2.1, J4.3, J6.14, J8.12, R13.2, R14.1, R17.1, R20.1, R22.1, R23.1, SW2.1 (A), U7.8 (VCC), U8.2 (VO), U9.6 (VBAT), U9.11 (VDD), U9.21 (VREF+), U9.22 (VDDA), U9.28 (VDD), U9.50 (VDD), U9.73 (VDDUSB), U9.75 (VDD), U9.100 (VDD)
+5V: C1.2, C4.2, C16.1, C17.1, F1.2, J8.13, J8.14, L1.1, U3.6 (VIN), U3.7 (FREQ), U8.3 (VI)
+12V: C9.2, C10.2, D1.4 (BA), D1.5 (GA), D1.6 (RA), D4.4 (BA), D4.5 (GA), D4.6 (RA), D7.1 (K), D8.4 (BA), D8.5 (GA), D8.6 (RA), D11.4 (BA), D11.5 (GA), D11.6 (RA), D14.2 (A), J3.1, J8.16, R3.1, R4.1, R7.2, R10.1, R11.1
/BOOST_OUT: D7.2 (A), L1.2, U3.5 (SW)
/RGBD_1_DIN: R1.2, U1.6 (DIN)
/RGBD_12_DIO: U1.5 (DO), U5.6 (DIN)
/RGBD_23_DIO: U5.5 (DO), U6.6 (DIN)
/RGBD_34_DIO: U2.6 (DIN), U6.5 (DO)
/USB_N: J1.A7 (DN1), J1.B7 (DN2), U4.1 (I/O1)
/USB_P: J1.A6 (DP1), J1.B6 (DP2), U4.3 (I/O2)
BOOST_EN: U3.3 (EN), U9.25 (PA2)
BOOT0: C13.1, R19.2, R21.2, U9.94 (BOOT0)
DISPLAY_DC: J6.10, U9.2 (PE3)
DISPLAY_LED: J6.7, U9.95 (PB8)
DISPLAY_MISO: J6.6, U9.4 (PE5)
DISPLAY_MOSI: J6.9, U9.5 (PE6)
DISPLAY_NSS: J6.12, U9.3 (PE4)
DISPLAY_RST: J6.11, U9.7 (PC13)
DISPLAY_SCK: J6.8, U9.1 (PE2)
EEPROM_SCL: R17.2, U7.6 (SCL), U9.59 (PD12)
EEPROM_SDA: R20.2, U7.5 (SDA), U9.60 (PD13)
EEPROM_WP: R13.1, U7.7 (WP), U9.58 (PD11)
FAN_PWM: J3.3, U9.36 (PB1)
GND: C1.1, C2.2, C3.2, C4.1, C5.1, C6.1, C7.2, C8.2, C9.1, C10.1, C12.1, C13.2, C14.2, C15.2, C16.2, C17.2, C18.1, C19.2, C20.1, C21.2, C22.1, C23.1, C24.1, C25.1, C26.2, C27.1, C28.1, C29.1, C30.2, H1.1 (1_1), H2.1 (1_1), H3.1 (1_1), H4.1 (1_1), J1.A1_B12 (GND), J1.A8 (SBU1), J1.B1_A12 (GND), J1.S1 (SHIELD), J1.S2 (SHIELD), J1.S3 (SHIELD), J1.S4 (SHIELD), J2.4, J3.4, J4.5, J4.7, J4.11, J6.13, J8.11, J8.15, Q1.2 (E), R2.1, R6.1, R8.1, R24.1, SW1.2, SW1.3, SW2.3 (C), U1.4 (GND), U2.4 (GND), U3.4 (GND), U4.2 (GND), U5.4 (GND), U6.4 (GND), U7.1 (A0), U7.2 (A1), U7.3 (A2), U7.4 (GND), U8.1 (GND), U9.10 (VSS), U9.19 (VSSA), U9.20 (VREF-), U9.27 (VSS), U9.49 (VSS), U9.74 (VSS), U9.99 (VSS), Y1.2, Y1.4
NRST: C30.1, J4.12, R12.2, R14.2, SW1.1, SW1.4, U9.14 (NRST)
unnamed: C6.2, R5.2
unnamed: C14.1, R18.1, Y1.3
unnamed: C18.2, U9.48 (VCAP)
unnamed: C20.2, U9.98 (VCAP)
unnamed: D1.3 (BK), D2.4 (BA)
unnamed: D1.2 (GK), D2.5 (GA)
unnamed: D1.1 (RK), D2.6 (RA)
unnamed: D2.3 (BK), D3.4 (BA)
unnamed: D2.2 (GK), D3.5 (GA)
unnamed: D2.1 (RK), D3.6 (RA)
unnamed: D3.3 (BK), U1.2 (OUTG)
unnamed: D3.2 (GK), U1.1 (OUTR)
unnamed: D3.1 (RK), U1.3 (OUTB)
unnamed: D4.3 (BK), D5.4 (BA)
unnamed: D4.2 (GK), D5.5 (GA)
unnamed: D4.1 (RK), D5.6 (RA)
unnamed: D5.3 (BK), D6.4 (BA)
unnamed: D5.2 (GK), D6.5 (GA)
unnamed: D5.1 (RK), D6.6 (RA)
unnamed: D6.3 (BK), U2.2 (OUTG)
unnamed: D6.2 (GK), U2.1 (OUTR)
unnamed: D6.1 (RK), U2.3 (OUTB)
unnamed: D8.3 (BK), D9.4 (BA)
unnamed: D8.2 (GK), D9.5 (GA)
unnamed: D8.1 (RK), D9.6 (RA)
unnamed: D9.3 (BK), D10.4 (BA)
unnamed: D10.3 (BK), U5.2 (OUTG)
unnamed: D9.2 (GK), D10.5 (GA)
unnamed: D10.2 (GK), U5.1 (OUTR)
unnamed: D9.1 (RK), D10.6 (RA)
unnamed: D10.1 (RK), U5.3 (OUTB)
unnamed: D11.3 (BK), D12.4 (BA)
unnamed: D11.2 (GK), D12.5 (GA)
unnamed: D11.1 (RK), D12.6 (RA)
unnamed: D12.3 (BK), D13.4 (BA)
unnamed: D12.2 (GK), D13.5 (GA)
unnamed: D12.1 (RK), D13.6 (RA)
unnamed: D13.3 (BK), U6.2 (OUTG)
unnamed: D13.2 (GK), U6.1 (OUTR)
unnamed: D13.1 (RK), U6.3 (OUTB)
unnamed: D14.1 (K), R16.1
unnamed: D15.1 (K), R24.2
unnamed: J1.A5 (CC1), R2.2
unnamed: J1.B5 (CC2), R6.2
unnamed: Q1.1 (B), R15.1
unnamed: Q1.3 (C), R16.2
unnamed: R7.1, R9.2
unnamed: R21.1, SW2.2 (B)
unnamed: C2.1, R3.2, U1.8 (VDD)
unnamed: C3.1, R4.2, U2.8 (VDD)
unnamed: R5.1, U3.1 (COMP)
unnamed: R8.2, R9.1, U3.2 (FB)
unnamed: C5.2, U3.8 (SS)
unnamed: C7.1, R10.2, U5.8 (VDD)
unnamed: C8.1, R11.2, U6.8 (VDD)
OSC_HSE_IN: C15.1, U9.12 (PH0), Y1.1
OSC_HSE_OUT: R18.2, U9.13 (PH1)
PA9: U9.68 (PA9)
PA10: U9.69 (PA10)
PB2: J8.9, U9.37 (PB2)
PB10: J8.4, U9.47 (PB10)
PB12: J8.6, U9.51 (PB12)
PB14: J8.8, U9.53 (PB14)
PB15: J8.10, U9.54 (PB15)
PC7: U9.64 (PC7)
PC8: U9.65 (PC8)
PD8: U9.55 (PD8)
PD9: U9.56 (PD9)
PD10: U9.57 (PD10)
PD14: U9.61 (PD14)
PD15: U9.62 (PD15)
PE7: U9.38 (PE7)
PE8: J8.7, U9.39 (PE8)
PE9: J8.5, U9.40 (PE9)
PE10: J8.3, U9.41 (PE10)
PE11: J8.1, U9.42 (PE11)
PE12: U9.43 (PE12)
PE13: U9.44 (PE13)
PE14: J8.2, U9.45 (PE14)
PE15: U9.46 (PE15)
RGB_MOSI: R1.1, U9.18 (PC3)
SD_MISO: J5.2, U9.31 (PA6)
SD_MOSI: J5.3, U9.32 (PA7)
SD_NSS: J5.4, U9.29 (PA4)
SD_SCK: J5.1, U9.30 (PA5)
SELF_BOOT0: R19.1, U9.63 (PC6)
SELF_RESET: R12.1, U9.8 (PC14)
SHT31_SCL: J2.3, R23.2, U9.67 (PA8)
SHT31_SDA: J2.2, R22.2, U9.66 (PC9)
SWD_CLK: J4.6, U9.76 (PA14(JTCK)
SWD_SWDIO: J4.4, U9.72 (PA13(JTMS)
SWD_SWO: J4.8
TOUCH_IRQ: J6.1, U9.92 (PB6)
TOUCH_MISO: J6.2, U9.90 (PB4(NJTRST))
TOUCH_MOSI: J6.3, U9.91 (PB5)
TOUCH_NSS: J6.4, U9.93 (PB7)
TOUCH_SCK: J6.5, U9.89 (PB3(JTDO)
TRANSDUCER_PWM: J3.2, U9.35 (PB0)
UART4_RX: J4.14, U9.81 (PD0)
UART4_TX: J4.13, U9.82 (PD1)
USB_D+: U4.4 (I/O2), U9.71 (PA12)
USB_D-: U4.6 (I/O1), U9.70 (PA11)
VBUS: F1.1, J1.A4_B9 (VBUS), J1.B4_A9 (VBUS), U4.5 (VBUS)
WATER_LED: R15.2, U9.24 (PA1)

Notes on the sheet:
STM32H562 MCU
16Mhz Oscillator
USB-C
BOOT MODE Select
MCU Decoupling
5->12V Boost Converter
RGB LEDs
POWER / LDO
Water LED
I2C PU's
PROGRAMMING / DEBUG
Connectors
Reset
VDDUSB
EEPROM
156K for 12V

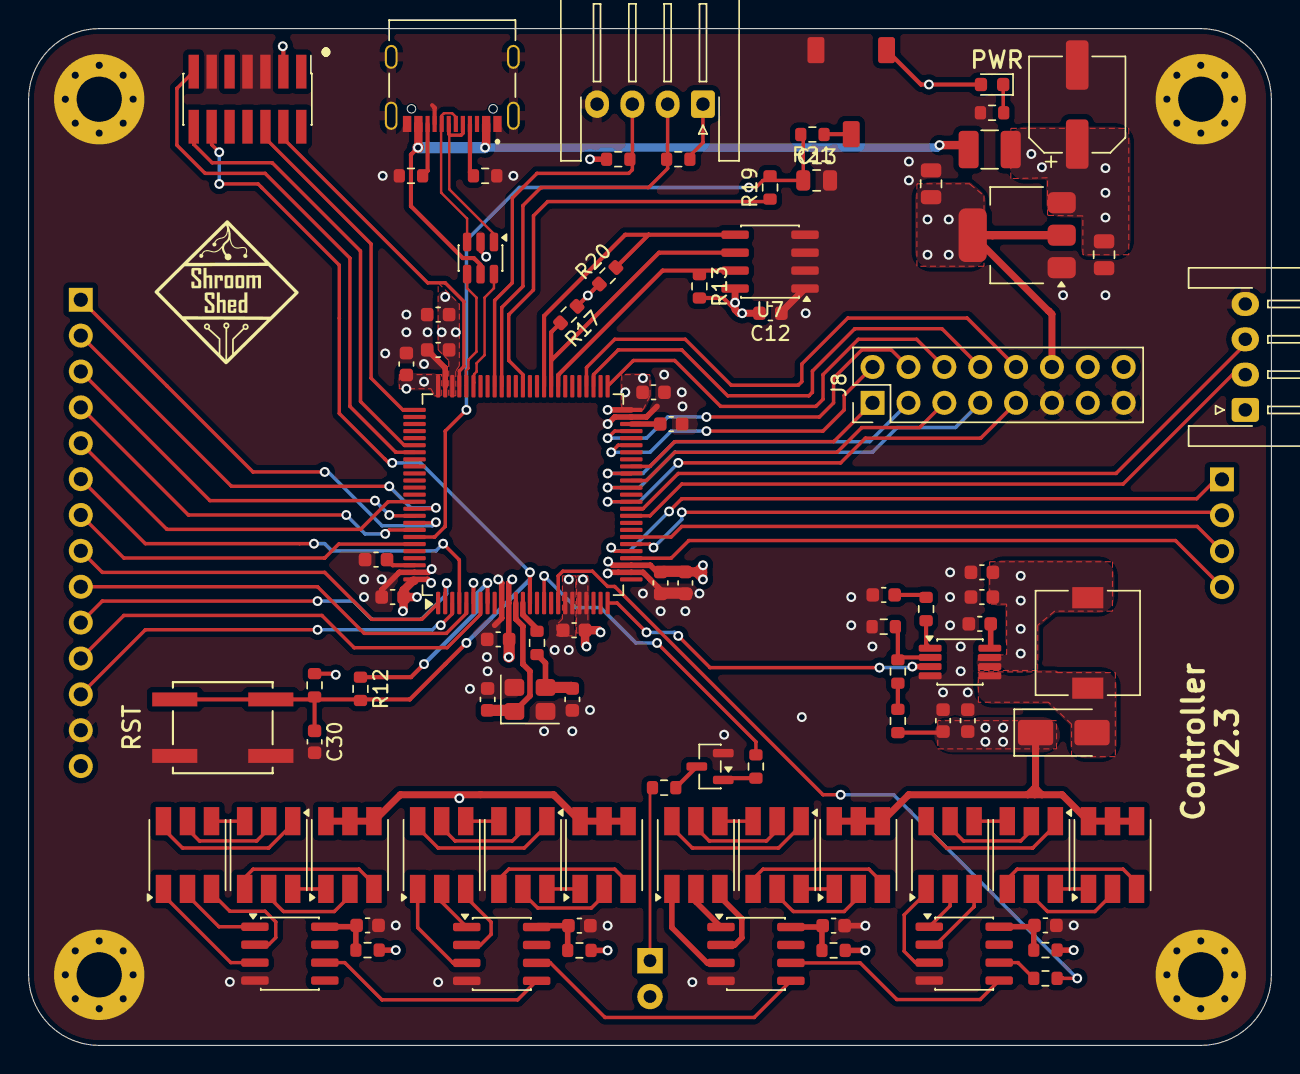
[picture p118: board ShroomShed_MKII_PCB.kicad_pcb from above]

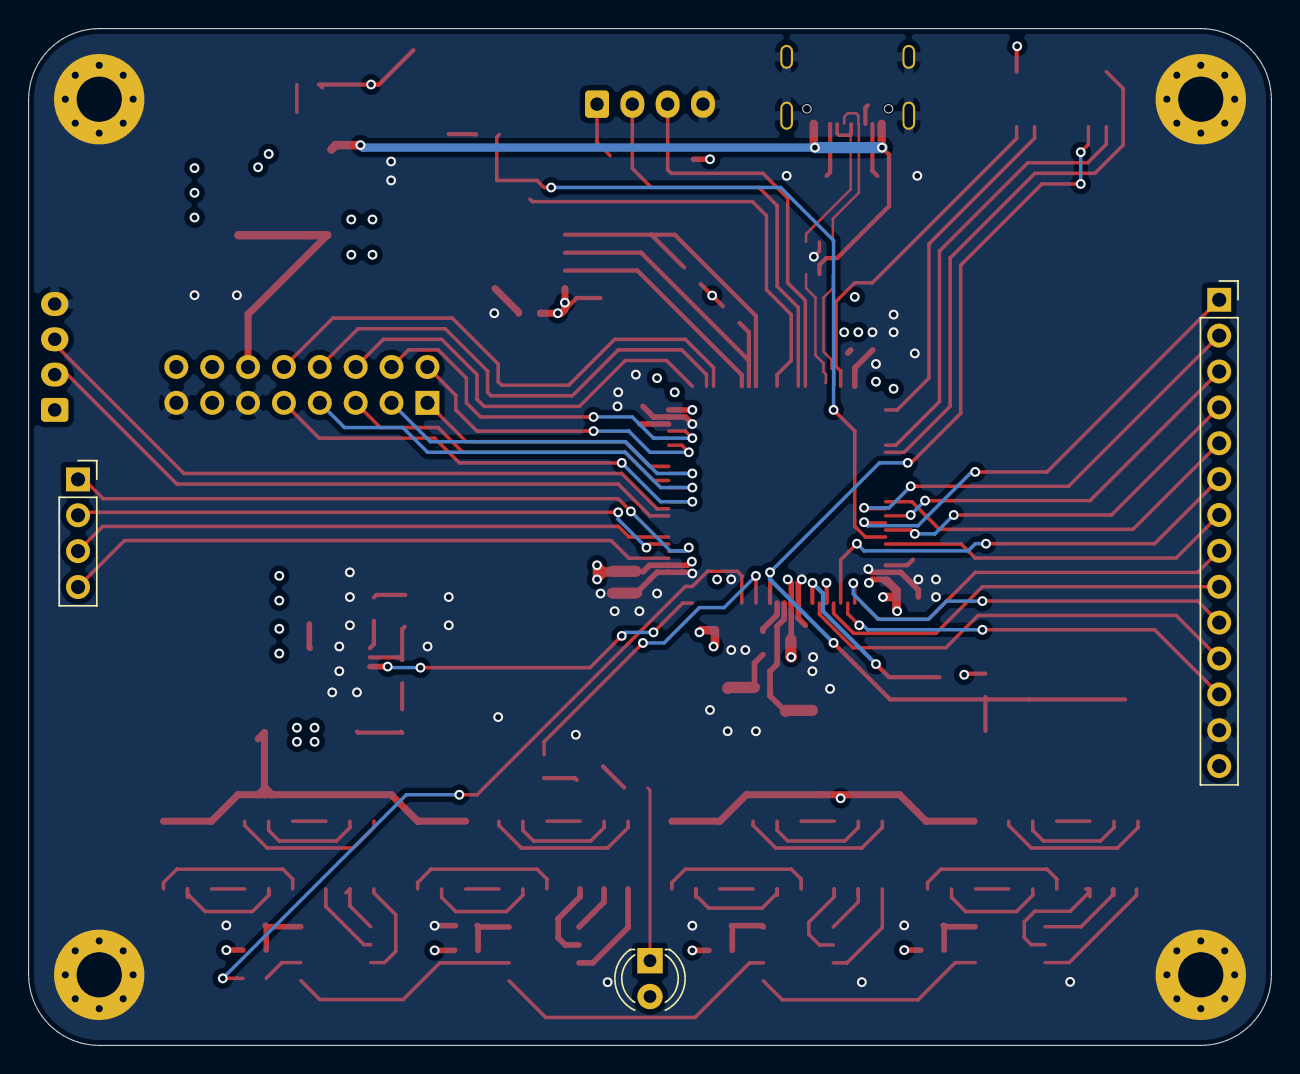
[picture p119: board ShroomShed_MKII_PCB.kicad_pcb from below]

Board: 4 copper layers, 88.0 x 72.0 mm, 94 parts (3 on the bottom side), 115 nets.
