OilyT/ShroomShedMKII/ShroomShed_MKII_PCB/ERM_PCB/ERM_PCB.kicad_pcb

## KiCad design ShroomShed_MKII_PCB/ERM_PCB/ERM_PCB.kicad_pcb (2026-11-09)

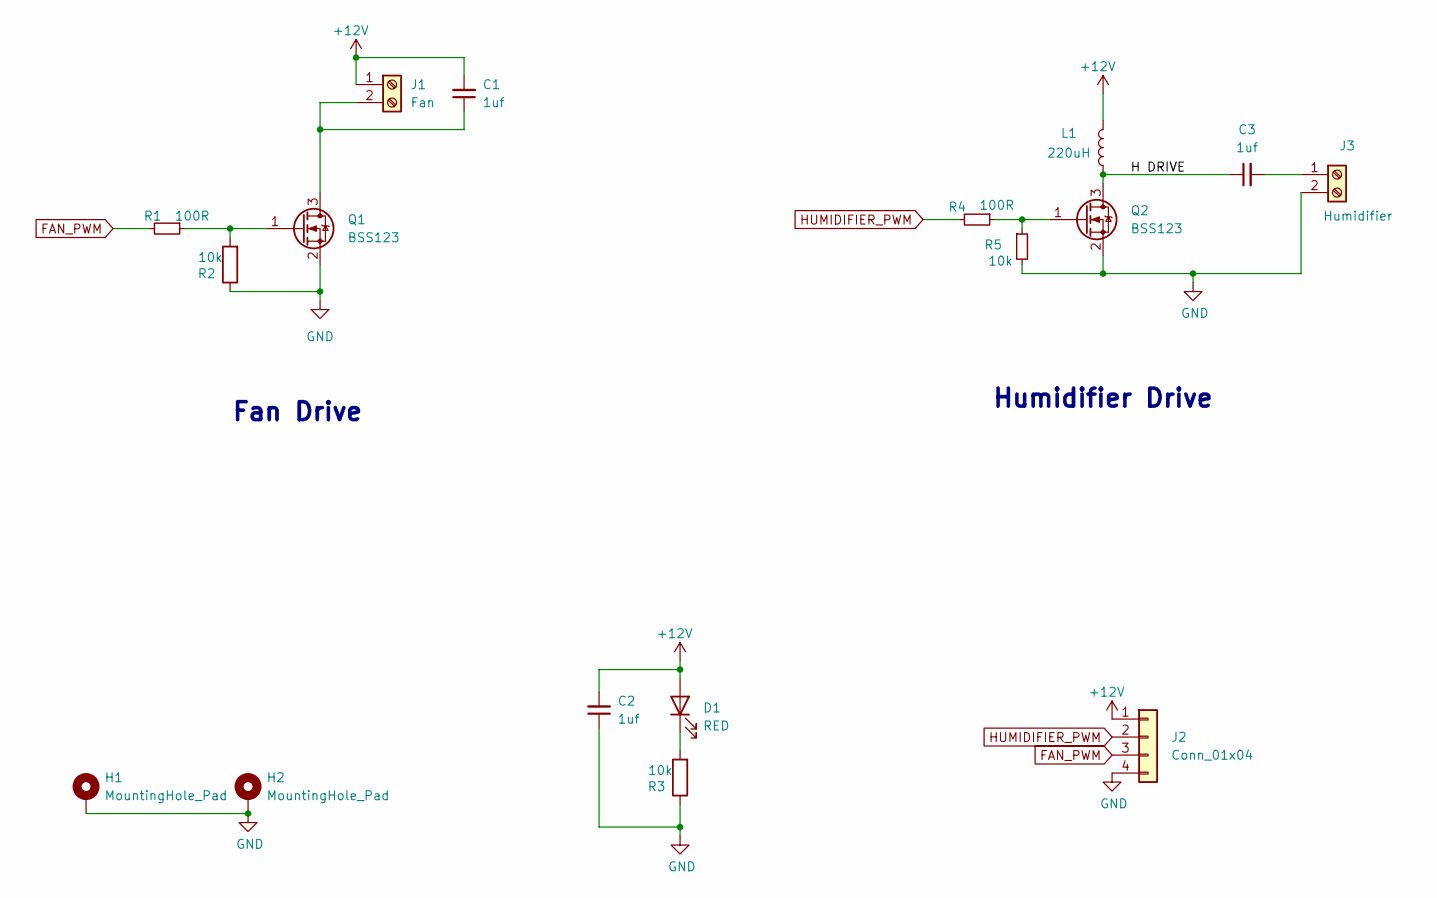
[picture p120: schematic ERM_PCB.kicad_sch]

Parts:
C1, C2, C3: 1uf; C_0603_1608Metric
D1: RED; LED_0603_1608Metric
H1, H2: MountingHole_Pad; MountingHole_3.2mm_M3_Pad
J1: Fan; JST_XH_S2B-XH-A-1_1x02_P2.50mm_Horizontal
J2: Conn_01x04; JST_XH_S4B-XH-A-1_1x04_P2.50mm_Horizontal
J3: Humidifier; JST_PH_S2B-PH-K_1x02_P2.00mm_Horizontal
L1: 220uH; SMDRH104R
Q1, Q2: BSS123; SOT-23
R1, R4: 100R; R_0603_1608Metric
R2, R3, R5: 10k; R_0603_1608Metric

Connections:
+12V: C1.2, C2.2, D1.2 (A), J1.1, J2.1, L1.2
/H DRIVE: C3.1, L1.1, Q2.3 (D)
FAN_PWM: J2.3, R1.2
GND: C2.1, H1.1 (1_1), H2.1 (1_1), J2.4, J3.2, Q1.2 (S), Q2.2 (S), R2.1, R3.1, R5.2
HUMIDIFIER_PWM: J2.2, R4.2
unnamed: D1.1 (K), R3.2
unnamed: C1.1, J1.2, Q1.3 (D)
unnamed: C3.2, J3.1
unnamed: Q1.1 (G), R1.1, R2.2
unnamed: Q2.1 (G), R4.1, R5.1

Notes on the sheet:
Humidifier Drive
Fan Drive

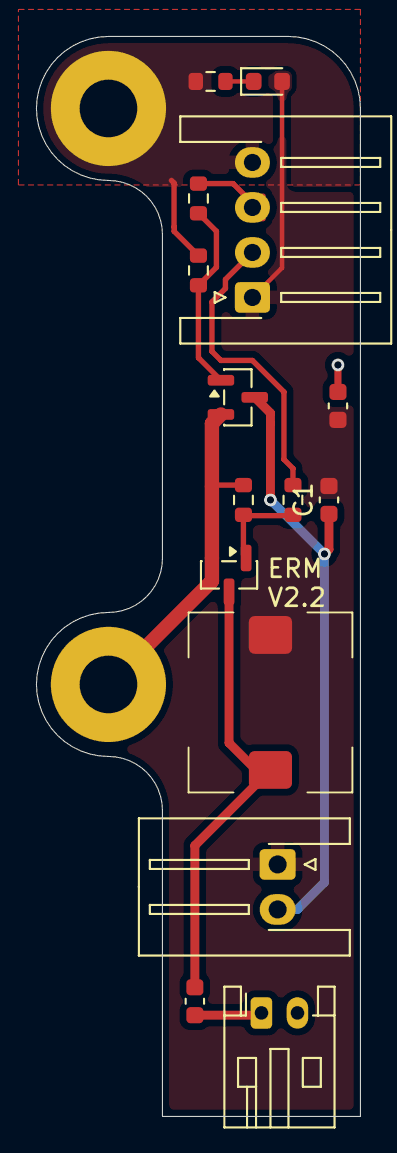
[picture p121: board ERM_PCB.kicad_pcb from above]

Board: 2 copper layers, 18.0 x 60.0 mm, 17 parts (0 on the bottom side), 10 nets.
