OilyT/ShroomShedMKII/ShroomShed_MKII_PCB/ShroomShed_Sensor/ShroomShed_Sensor.kicad_pcb

## KiCad design ShroomShed_MKII_PCB/ShroomShed_Sensor/ShroomShed_Sensor.kicad_pcb (2026-04-28)

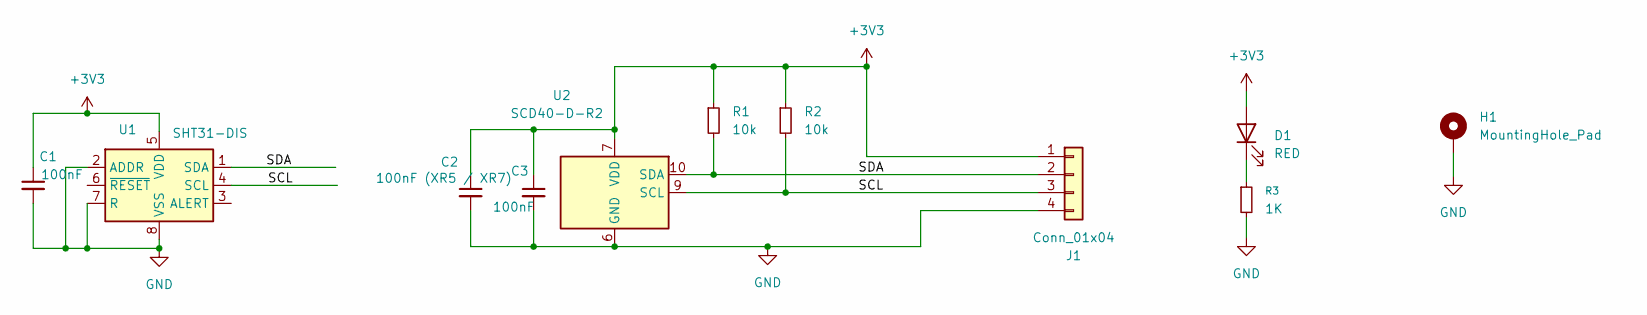
[picture p122: schematic ShroomShed_Sensor.kicad_sch]

Parts:
C1, C3: 100nF; C_0603_1608Metric
C2: 100nF (XR5 / XR7); C_0603_1608Metric
D1: RED; LED_0603_1608Metric
H1: MountingHole_Pad; MountingHole_3.2mm_M3_Pad
J1: Conn_01x04; JST_XH_B4B-XH-AM_1x04_P2.50mm_Vertical
R1, R2: 10k; R_0603_1608Metric
R3: 1K; R_0603_1608Metric
U1: SHT31-DIS; Sensirion_DFN-8-1EP_2.5x2.5mm_P0.5mm_EP1.1x1.7mm
U2: SCD40-D-R2; Sensirion_SCD4x-1EP_10.1x10.1mm_P1.25mm_EP4.8x4.8mm

Connections:
+3V3: C1.1, C2.1, C3.1, D1.2 (A), J1.1, R1.1, R2.1, U1.5 (VDD), U2.7 (VDD), U2.19 (VDD)
/SCL: J1.3, R2.2, U1.4 (SCL), U2.9 (SCL)
/SDA: J1.2, R1.2, U1.1 (SDA), U2.10 (SDA)
GND: C1.2, C2.2, C3.2, H1.1 (1_1), J1.4, R3.2, U1.2 (ADDR), U1.7 (R), U1.8 (VSS), U1.9 (VSS), U2.6 (GND), U2.20 (GND), U2.21 (GND)
unnamed: D1.1 (K), R3.1

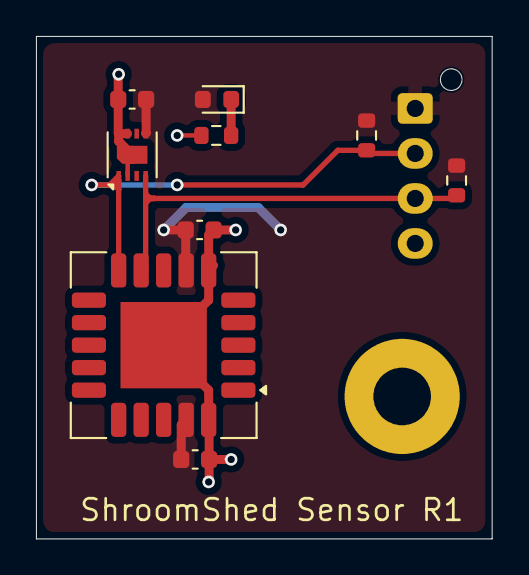
[picture p123: board ShroomShed_Sensor.kicad_pcb from above]

Board: 2 copper layers, 25.3 x 27.9 mm, 11 parts (1 on the bottom side), 5 nets.
