OilyT/ShroomShedMKII/Core/Src/main.c

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
/* Includes ------------------------------------------------------------------*/
#include "main.h"
#include "app_filex.h"

/* USER CODE BEGIN Includes */

#include "stm32h5xx_hal_dma.h"
#include "stm32h5xx_hal_gpio.h"
#include "usbd_core.h"
#include "usbd_cdc_if.h"

#include "shroomshed.h"

/* USER CODE END Includes */


CRC_HandleTypeDef hcrc;

I2C_HandleTypeDef hi2c3;

SPI_HandleTypeDef hspi1;
SPI_HandleTypeDef hspi2;
SPI_HandleTypeDef hspi4;
SPI_HandleTypeDef hspi6;
DMA_HandleTypeDef handle_GPDMA1_Channel7;

TIM_HandleTypeDef htim1;
TIM_HandleTypeDef htim3;
TIM_HandleTypeDef htim4;

UART_HandleTypeDef huart4;

PCD_HandleTypeDef hpcd_USB_DRD_FS;

/* USER CODE BEGIN PV */

USBD_HandleTypeDef hUsbDeviceFS;
extern USBD_DescriptorsTypeDef Class_Desc;

/* USER CODE END PV */

void SystemClock_Config(void);
static void MX_GPIO_Init(void);
static void MX_GPDMA1_Init(void);
static void MX_TIM1_Init(void);
static void MX_UART4_Init(void);
static void MX_USB_PCD_Init(void);
static void MX_SPI1_Init(void);
static void MX_SPI2_Init(void);
static void MX_TIM3_Init(void);
static void MX_ICACHE_Init(void);
static void MX_I2C3_Init(void);
static void MX_SPI6_Init(void);
static void MX_SPI4_Init(void);
static void MX_TIM4_Init(void);
static void MX_CRC_Init(void);
/**
  * @brief  The application entry point.
  * @retval int
  */
int main(void)
{

  /* MCU Configuration--------------------------------------------------------*/

  /* Reset of all peripherals, Initializes the Flash interface and the Systick. */
  HAL_Init();

  /* Configure the system clock */
  SystemClock_Config();

  /* Initialize all configured peripherals */
  MX_GPIO_Init();
  MX_GPDMA1_Init();
  MX_TIM1_Init();
  MX_UART4_Init();
  MX_USB_PCD_Init();
  MX_SPI1_Init();
  MX_SPI2_Init();
  MX_TIM3_Init();
  MX_ICACHE_Init();
  MX_I2C3_Init();
  MX_SPI6_Init();
  MX_SPI4_Init();
  MX_TIM4_Init();
  MX_FileX_Init();
  MX_CRC_Init();
  /* USER CODE BEGIN 2 */

  init_shroomshed();


  /* USER CODE END 2 */

  /* Infinite loop */
  /* USER CODE BEGIN WHILE */

  while (1)
  {

    loop();

    /* USER CODE END WHILE */

    /* USER CODE BEGIN 3 */
  }
  /* USER CODE END 3 */
}

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
