OilyT/ShroomShedMKII/ShroomShed_MKII.ioc

Mcu.UserName=STM32H562VGTx
PA1.GPIO_Label=WATER_LED
PA1.Signal=GPIO_Output
PA11.Signal=USB_DM
PA12.Signal=USB_DP
PA13(JTMS/SWDIO).Signal=DEBUG_JTMS-SWDIO
PA14(JTCK/SWCLK).Signal=DEBUG_JTCK-SWCLK
PA2.GPIO_Label=BOOST_EN
PA2.Signal=GPIO_Output
PA4.GPIO_Label=SD_CS
PA4.Signal=GPIO_Output
PA5.GPIO_Label=SD_SCK
PA5.Signal=SPI6_SCK
PA6.GPIO_Label=SD_MISO
PA6.Signal=SPI6_MISO
PA7.GPIO_Label=SD_MOSI
PA7.Signal=SPI6_MOSI
PA8.GPIO_Label=SHT31_SCL
PA8.Signal=I2C3_SCL
PB0.GPIO_Label=TRANDUCER_PWM
PB0.Signal=S_TIM3_CH3
PB1.GPIO_Label=FAN_PWM
PB1.Signal=TIM1_CH3N
PB13.Signal=SPI2_SCK
PB3(JTDO/TRACESWO).GPIO_Label=TOUCH_SCK
PB3(JTDO/TRACESWO).Signal=SPI1_SCK
PB4(NJTRST).GPIO_Label=TOUCH_MISO
PB4(NJTRST).Signal=SPI1_MISO
PB5.GPIO_Label=TOUCH_MOSI
PB5.Signal=SPI1_MOSI
PB6.GPIO_Label=TOUCH_IRQ
PB6.Signal=GPXTI6
PB7.GPIO_Label=TOUCH_CS
PB7.Signal=GPIO_Output
PB8.GPIO_Label=DISPLAY_LED
PB8.Signal=S_TIM4_CH3
PC13.GPIO_Label=DISPLAY_RST
PC13.Signal=GPIO_Output
PC14-OSC32_IN(OSC32_IN).GPIO_Label=SELF_RESET
PC14-OSC32_IN(OSC32_IN).Signal=GPIO_Output
PC3.GPIO_Label=RGB_MOSI
PC3.Signal=SPI2_MOSI
PC6.GPIO_Label=SELF_BOOT0
PC6.Signal=GPIO_Output
PC9.GPIO_Label=SHT31_SDA
PC9.Signal=I2C3_SDA
PD0.Signal=UART4_RX
PD1.Signal=UART4_TX
PD11.GPIO_Label=EEPROM_WP
PD11.Signal=GPIO_Output
PD12.GPIO_Label=EEPROM_SCL
PD12.Signal=I2C4_SCL
PD13.GPIO_Label=EEPROM_SDA
PD13.Signal=I2C4_SDA
PE2.GPIO_Label=DISPLAY_SCK
PE2.Signal=SPI4_SCK
PE3.GPIO_Label=DISPLAY_DC
PE3.Signal=GPIO_Output
PE4.GPIO_Label=DISPLAY_CS
PE4.Signal=GPIO_Output
PE5.GPIO_Label=DISPLAY_MISO
PE5.Signal=SPI4_MISO
PE6.GPIO_Label=DISPLAY_MOSI
PE6.Signal=SPI4_MOSI
PH0-OSC_IN(PH0).Signal=RCC_OSC_IN
PH1-OSC_OUT(PH1).Signal=RCC_OSC_OUT
