OilyT/ShroomShedMKII/Drivers/sht31/src/driver_sht31_interface_template.c

/**
 * Copyright (c) 2015 - present LibDriver All rights reserved
 * 
 * The MIT License (MIT)
 *
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
 * @file      driver_sht31_interface_template.c
 * @brief     driver sht31 interface template source file
 * @version   2.0.0
 * @author    Shifeng Li
 * @date      2021-03-05
 *
 * <h3>history</h3>
 * <table>
 * <tr><th>Date        <th>Version  <th>Author      <th>Description
 * <tr><td>2021/03/05  <td>2.0      <td>Shifeng Li  <td>format the code
 * <tr><td>2020/11/03  <td>1.0      <td>Shifeng Li  <td>first upload
 * </table>
 */

#include "driver_sht31_interface.h"
#include "main.h"
#include <stdio.h>
#include <string.h>
#include <stdarg.h>
#include "stm32f4xx_hal_i2c.h"
#include "usbd_cdc_if.h"

extern I2C_HandleTypeDef hi2c2;
char sht31_usb_buffer[200];

/**
 * @brief  interface iic bus init
 * @return status code
 *         - 0 success
 *         - 1 iic init failed
 * @note   none
 */
uint8_t sht31_interface_iic_init(void)
{
    return 0;
}

/**
 * @brief  interface iic bus deinit
 * @return status code
 *         - 0 success
 *         - 1 iic deinit failed
 * @note   none
 */
uint8_t sht31_interface_iic_deinit(void)
{
    return 0;
}

/**
 * @brief     interface iic bus write with 16 bits register address
 * @param[in] addr iic device write address
 * @param[in] reg iic register address
 * @param[in] *buf pointer to a data buffer
 * @param[in] len length of the data buffer
 * @return    status code
 *            - 0 success
 *            - 1 write failed
 * @note      none
 */
uint8_t sht31_interface_iic_write_address16(uint8_t addr, uint16_t reg, uint8_t *buf, uint16_t len)
{
    if (HAL_I2C_Mem_Write(&hi2c2, addr, reg, I2C_MEMADD_SIZE_16BIT, buf, len, 1000)) {
        return 1;
    }
    return 0;
}

/**
 * @brief      interface iic bus read with 16 bits register address
 * @param[in]  addr iic device write address
 * @param[in]  reg iic register address
 * @param[out] *buf pointer to a data buffer
 * @param[in]  len length of the data buffer
 * @return     status code
 *             - 0 success
 *             - 1 read failed
 * @note       none
 */
uint8_t sht31_interface_iic_read_address16(uint8_t addr, uint16_t reg, uint8_t *buf, uint16_t len)
{
    if (HAL_I2C_Mem_Read(&hi2c2, addr, reg, I2C_MEMADD_SIZE_16BIT, buf, len, 1000)) {
        return 1;
    }
    return 0;
}

/**
 * @brief      interface iic bus read with 16 bits register address
 * @param[in]  addr iic device write address
 * @param[in]  reg iic register address
 * @param[out] *buf pointer to a data buffer
 * @param[in]  len length of the data buffer
 * @return     status code
 *             - 0 success
 *             - 1 read failed
 * @note       none
 */
uint8_t sht31_interface_iic_scl_read_address16(uint8_t addr, uint16_t reg, uint8_t *buf, uint16_t len)
{
    
    if(HAL_I2C_Mem_Read(&hi2c2, addr, reg, I2C_MEMADD_SIZE_16BIT, buf, len, 1000) != HAL_OK)
    {
        return 1;
    }
    return 0;
}

/**
 * @brief     interface delay ms
 * @param[in] ms time
 * @note      none
 */
void sht31_interface_delay_ms(uint32_t ms)
{
    HAL_Delay(ms);
}

/**
 * @brief     interface print format data
 * @param[in] fmt format data
 * @note      none
 */
void sht31_interface_debug_print(const char *const fmt, ...)
{   
    va_list args;
    va_start(args, fmt);
    int len = vsnprintf(sht31_usb_buffer, sizeof(sht31_usb_buffer) - 2, fmt, args);
    va_end(args);
    
    // Replace \n with \r\n for proper terminal display
    if (len > 0 && sht31_usb_buffer[len - 1] == '\n') {
        sht31_usb_buffer[len - 1] = '\r';
        sht31_usb_buffer[len] = '\n';
        sht31_usb_buffer[len + 1] = '\0';
        len++;
    }
    
    CDC_Transmit_FS((uint8_t*)sht31_usb_buffer, len);  
}

/**
 * @brief     interface receive callback
 * @param[in] type receive type
 * @note      none
 */
void sht31_interface_receive_callback(uint16_t type)
{
    switch (type)
    {
        case SHT31_STATUS_ALERT_PENDING_STATUS :
        {
            sht31_interface_debug_print("sht31: irq alert pending status.\r\n");
            
            break;
        }
        case SHT31_STATUS_HUMIDITY_ALERT :
        {
            sht31_interface_debug_print("sht31: irq humidity alert.\r\n");
            
            break;
        }
        case SHT31_STATUS_TEMPERATURE_ALERT :
        {
            sht31_interface_debug_print("sht31: irq temperature alert.\r\n");
            
            break;
        }
    }
}
