OilyT/ShroomShedMKII/Core/Src/vars.c

#include "vars.h"
#include <stdint.h>
#include <string.h>
#include <stdio.h>
#include <math.h>
#include "display_manager.h"
#include "shroomshed.h"
#include "mushroom.h"
#include "rgb.h"
#include "shroomshed_hal.h"

#ifdef USE_TEST_UNIT
    #define DISPLAY_HUMIDITY_ALPHA 1
    #define DISPLAY_TEMPERATURE_ALPHA 1
#else
    #define DISPLAY_HUMIDITY_ALPHA 0.01
    #define DISPLAY_TEMPERATURE_ALPHA 0.01
#endif

extern MGP_t MGP_list[];
extern uint8_t MGP_list_size;

static float display_humidity = 40;
static float display_temperature = 15;
static int32_t display_airflow_int = 0;
char display_airflow_string[10] = { 0 };
char humidity_display_string[11] = { 0 };


// GLOBAL VARS
bool get_var_shed_manual_mode(void) {
    return shedControl.controlMode == MODE_MANUAL;
}
void set_var_shed_manual_mode(bool value) {
    //not used
}

bool get_var_shed_auto_mode(void) {
    return shedControl.controlMode == MODE_AUTOMATIC;
}

void set_var_shed_auto_mode(bool value) {
    //not used
}

bool get_var_shed_output_normal(void) {
    return shedControl.outputMode == OUTPUT_NORMAL;
}

void set_var_shed_output_normal(bool value) {
    // not used
}


// MAIN SCREEN VARS

const char *get_var_shroom_os_version(void) {
    static char shroom_os_version_str[10];
    snprintf(shroom_os_version_str, sizeof(shroom_os_version_str), "%s", shroomOS_VERSION);
    return shroom_os_version_str;
}


float get_var_humidity_fp(void) {
    return display_humidity;
}

void set_var_humidity_fp(float value) {

    display_humidity = display_humidity * (1 - DISPLAY_HUMIDITY_ALPHA) + value * DISPLAY_HUMIDITY_ALPHA;
}

float get_var_temperature_fp() {
    return display_temperature;
}

void set_var_temperature_fp(float value) {

    display_temperature = display_temperature * (1 - DISPLAY_TEMPERATURE_ALPHA) + value * DISPLAY_TEMPERATURE_ALPHA;
}

const char *get_var_temperature_str() {
    static char temp_str[10];
    snprintf(temp_str, sizeof(temp_str), "%.1f°C", display_temperature);
    return temp_str;
}

int32_t get_var_airflow_int() {
    return display_airflow_int;
}

void set_var_airflow_int(int32_t value) {
    display_airflow_int = value;
}

const char *get_var_airflow_string() {
    sprintf(display_airflow_string, "%d%%", (int)display_airflow_int);
    return display_airflow_string;
}

void set_var_airflow_string(const char *value) {
    strncpy(display_airflow_string, value, sizeof(display_airflow_string) / sizeof(char));
    display_airflow_string[sizeof(display_airflow_string) / sizeof(char) - 1] = 0;
}

const char *get_var_humidity_display_str(void) {
    snprintf(humidity_display_string, sizeof(humidity_display_string),"%.1f/%d%%", display_humidity, shedControl.humidityControlValue);
    return humidity_display_string;
}

void set_var_humidity_display_str(const char *value) {
    // not used
}



// STATIC COLOUR SCREEN VARS
const char *get_var_red_value(void) {
    static char red_value_str[12];
    snprintf(red_value_str, sizeof(red_value_str), "RED %u%%", rgbSettings.staticRed * 10);
    return red_value_str;
}

void set_var_red_value(const char *value) {
    (void)value;
}

const char *get_var_green_value(void) {
    static char green_value_str[14];
    snprintf(green_value_str, sizeof(green_value_str), "GREEN %u%%", rgbSettings.staticGreen * 10);
    return green_value_str;
}

void set_var_green_value(const char *value) {
    (void)value;
}

const char *get_var_blue_value(void) {
    static char blue_value_str[13];
    snprintf(blue_value_str, sizeof(blue_value_str), "BLUE %u%%", rgbSettings.staticBlue * 10);
    return blue_value_str;
}

void set_var_blue_value(const char *value) {
    (void)value;
}



// DISCO SCREEN VARS
static uint8_t disco_power = 100;
static uint8_t disco_speed = 25;
static uint8_t disco_phase = 25;


int32_t get_var_disco_power_int() {
    return disco_power;
}

void set_var_disco_power_int(int32_t value) {
    disco_power = value;
}

int32_t get_var_disco_speed_int() {
    return disco_speed;
}

void set_var_disco_speed_int(int32_t value) {
    disco_speed = value;
}

int32_t get_var_disco_phase_int() {
    return disco_phase;
}

void set_var_disco_phase_int(int32_t value) {
    disco_phase = value;
}

// GENERAL SETTINGS VARS
extern uint8_t display_brightness;

int32_t get_var_display_brightness() {
    return display_brightness;
}

void set_var_display_brightness(int32_t value) {
    display_brightness = value;
}


// GROW SELECTION VARS
char mushroom_names_list[100] = { 0 };

const char *get_var_mushroom_names_list() {
    return mushroom_names_list;
}


void set_var_mushroom_names_list(const char *value) {
    (void)value;

    mushroom_names_list[0] = '\0';
    size_t offset = 0;

    for (uint8_t i = 0; i < MGP_list_size; i++) {
        const char *name = MGP_list[i].name;

        if (name[0] == '\0') {
            continue;
        }

        int written = snprintf(
            &mushroom_names_list[offset],
            sizeof(mushroom_names_list) - offset,
            "%s%s",
            (offset > 0) ? "\n" : "",
            name
        );

        if (written < 0 || (size_t)written >= (sizeof(mushroom_names_list) - offset)) {
            mushroom_names_list[sizeof(mushroom_names_list) - 1] = '\0';
            break;
        }

        offset += (size_t)written;
    }
}


// manual control vars
const char *get_var_manual_humidity_str(void) {
    static char manual_humidity_str[10];
    snprintf(manual_humidity_str, sizeof(manual_humidity_str),"%.1f/%d%%", display_humidity, shedControl.manualHumidityControlValue);
    return manual_humidity_str;
}

void set_var_manual_humidity_str(const char *value) {
    (void)value;
}

const char *get_var_manual_airflow_str(void) {
    static char manual_airflow_str[10];
    snprintf(manual_airflow_str, sizeof(manual_airflow_str), "%d%%", shedControl.manualFanControlValue);
    return manual_airflow_str;
}

void set_var_manual_airflow_str(const char *value) {
    (void)value;
}

// grow selection vars
int32_t mushroom_list_index;

int32_t get_var_mushroom_list_index() {
    return mushroom_list_index;
}

void set_var_mushroom_list_index(int32_t value) {
    mushroom_list_index = value;
}

// AUTOMATIC GROWING VARS
void set_var_grow_progress_str(const char *value) {
    (void)value;
}

void set_var_grow_progress_int(int32_t value) {
    // not used, grow progress is calculated in tick_MGP
}

void set_var_grow_status(const char *value) {
    // n/a
}


// DEBUG SCREEN VARS

const char *get_var_h_pid_p(void) {
    int16_t value = get_PID_p();
    static char str[10];
    snprintf(str, sizeof(str), "%d", value);
    return str;
}

const char *get_var_h_pid_i(void) {
    int16_t value = get_PID_i();
    static char str[10];
    snprintf(str, sizeof(str), "%d", value);
    return str;
}

const char *get_var_h_pid_d(void) {
    int16_t value = get_PID_d();
    static char str[10];
    snprintf(str, sizeof(str), "%d", value);
    return str;
}

const char *get_var_h_pid_power(void) {
    int16_t value = get_PID_power();
    static char str[10];
    snprintf(str, sizeof(str), "%d", value);
    return str;
}
