OilyT/ShroomShedMKII/Core/Src/shroomshed_hal.c

/**
 * @file shroomshed_hal.c
 * @brief shroomshed hardware abstraction layer
 * @author yolo swaggins
 * @date with your mum
 */

#include "shroomshed_hal.h"
#include "stm32h5xx_hal.h"
#include "stm32h5xx_hal_gpio.h"
#include "main.h"
#include "shroomshed.h"
#include <stdint.h>
#include <math.h>


// humidity PID
#define PID_ID_PERIOD 10 // seconds
#define MAX_PULSE 1100
#define MIN_PULSE 600
#define PULSE_RANGE (MAX_PULSE - MIN_PULSE)
#define MAX_POWER 1000

// PV's
static int16_t P_term = 0;
static int16_t I_term = 0;
static int16_t D_term = 0;
static int16_t H_power = 0;


// PFP's

static void set_humidifier_power(uint16_t power);
static void humidity_pid(uint8_t humidity_setpoint);

/* ============================================================================
 * Function Implementations
 * ============================================================================ */


void humidity_process(uint8_t target_value) {

    if (shedControl.humidifierMode == HUMIDIFIER_MODE_HUMIDITY) {
        humidity_pid(target_value);
    } else {
        set_humidifier_power(target_value * 10);
    }
}

static void set_humidifier_power(uint16_t power) {
    uint16_t counter_register_power;

    if (power < 10) {
        counter_register_power = 0;
    } else {
        counter_register_power = power / (MAX_POWER / PULSE_RANGE) + MIN_PULSE;
    }
    
    TRANSDUCER_PWM_TIMER.Instance->CCR3 = counter_register_power;
}

static void humidity_pid(uint8_t humidity_setpoint) {
    const static float Pk = 25.0;
    const static float Ik = 0.25;
    const static float Dk = 250.0;

    static uint16_t ID_counter = 0;
    static float remainder = 0;

    float error = (float)humidity_setpoint - shedState.humidityCurrent;
    static float lastError = 0;

    // for storing temporary calculation float values
    float temp_term = 0;

    // proportional
    temp_term = Pk * error;
    P_term = (int16_t)temp_term;
    if (P_term > MAX_POWER) {
        P_term = MAX_POWER;
    } else if (P_term < -MAX_POWER) {
        P_term = -MAX_POWER;
    }

    ID_counter++;
    if (ID_counter >= CONTROL_PROCESS_HZ * PID_ID_PERIOD) {
        // integral
        temp_term = Ik * error * PID_ID_PERIOD;
        temp_term += remainder;
        remainder = temp_term - (int16_t)temp_term;
        I_term += (int16_t)temp_term;

        if (I_term < 0) {
            I_term = 0;
        }
        if (I_term > MAX_POWER - P_term) {
            I_term = MAX_POWER - P_term;
        }

        // derivative
        float error_delta = error - lastError;
        temp_term = Dk * error_delta / PID_ID_PERIOD;
        D_term = (int16_t)temp_term;

        lastError = error;
        ID_counter = 0;
    }

    H_power = (P_term + I_term + D_term);
    if (H_power > MAX_POWER) {
        H_power = MAX_POWER;
    } else if (H_power < 0) {
        H_power = 0;
    }

    set_humidifier_power(H_power);
}



inline int16_t get_PID_p(void) {
    return P_term;
}

inline int16_t get_PID_i(void) {
    return I_term;
}

inline int16_t get_PID_d(void) {
    return D_term;
}

inline int16_t get_PID_power(void) {
    return H_power;
}


void set_fan_speed(uint8_t speed) {
    float gamma = 0.7;
    uint16_t pwm_output = pow(speed / 100.0f, gamma) * FAN_PWM_TIMER.Init.Period;
    FAN_PWM_TIMER.Instance->CCR3 = pwm_output;
}

void enable_shed(void) {
    start_humidifier();
    start_fan();
    shedControl.outputMode = OUTPUT_NORMAL;
}

void disable_shed(void) {
    stop_humidifier();
    stop_fan();
    shedControl.outputMode = OUTPUT_DISABLED;
}

inline void enable_boost(void) {
    HAL_GPIO_WritePin(BOOST_EN_GPIO_Port, BOOST_EN_Pin, GPIO_PIN_SET);
}

inline void disable_boost(void) {
    HAL_GPIO_WritePin(BOOST_EN_GPIO_Port, BOOST_EN_Pin, GPIO_PIN_RESET);
}

inline void start_humidifier(void) {
    HAL_TIM_PWM_Start(&TRANSDUCER_PWM_TIMER, TIM_CHANNEL_3);
}

inline void stop_humidifier(void) {
    HAL_TIM_PWM_Stop(&TRANSDUCER_PWM_TIMER, TIM_CHANNEL_3);
}

inline void start_fan(void) {
    HAL_TIMEx_PWMN_Start(&FAN_PWM_TIMER, TIM_CHANNEL_3);
}

inline void stop_fan(void) {
    HAL_TIMEx_PWMN_Stop(&FAN_PWM_TIMER, TIM_CHANNEL_3);
}
