OilyT/ShroomShedMKII/Core/Src/inputs_manager.c

/**
 * @file inputs_manager.c
 * @brief Input management module
 * @author 
 * @date 
 * 
 * @details
 * Description of module functionality
 */

#include <stdint.h>
#include <stdbool.h>


/* Private includes */
/* TODO: Add project-specific includes */

/* Private typedef */
/* TODO: Add private typedefs */

/* Private define */
/* TODO: Add private defines */

/* Private macro */
/* TODO: Add private macros */

/* Private variables */
/* TODO: Add static variables */

/* Private function prototypes */
/* TODO: Add static function declarations */

/* Public variables */
/* TODO: Add public variables */

/* Public functions */

/**
 * @brief Initialize input manager
 * 
 * @return void
 */
void inputs_manager_init(void)
{
    /* TODO: Add initialization code */
}

/**
 * @brief Process inputs
 * 
 * @return void
 */
void inputs_manager_process(void)
{
    /* TODO: Add processing code */
}

/**
 * @brief De-initialize input manager
 * 
 * @return void
 */
void inputs_manager_deinit(void)
{
    /* TODO: Add de-initialization code */
}

/* Private functions */
/* TODO: Add static function implementations */
