OilyT/ShroomShedMKII/Core/Inc/input_manager.h

#ifndef INPUT_MANAGER_H
#define INPUT_MANAGER_H

#ifdef __cplusplus
extern "C" {
#endif

/* Includes */

/* Defines */

/* Typedefs */

/* Function Prototypes */

#ifdef __cplusplus
}
#endif

#endif /* INPUT_MANAGER_H */
