OilyT/ShroomShedMKII/(commit log)

2026-01-16 added solidworks files
    [Display_Adapter.kicad_pcb, Display_Adapter.kicad_sch, Display_bracket_AE.SLDPRT, Door_magnet_holder.SLDPRT, Driver_housing.SLDPRT, EC_box.SLDASM, Electronics_housing_Lateral.SLDPRT, Encoder Knob.SLDPRT]
2026-02-02 controller 2.0 commit
    [2,8 tft spi 240x320 v1.2 v2.SLDPRT, 2-8in 240x320 TFT LCD ILI9341.SLDASM, Controller_Module.SLDASM, Controller_Module.SLDPRT, Display_Adapter.SLDASM, Display_Adapter.step, Door_.SLDPRT, Door_AC.SLDPRT]
2026-02-02 source code template setup and blinky achieved
    [ESP32-AT.kicad_sch, ShroomShed_MKII.SLDASM, ShroomShed_MKII_PCB.kicad_sch]
2026-02-03 completed new ERM (solidworks + PCB) solidworks Frame complete
    [ERM_PCB.SLDASM, ERM_PCB.kicad_pcb, ERM_PCB.kicad_sch, ERM_PCB.step, ERM_PC_Board.SLDASM, FRAME_REAR_BOT.SLDPRT, FRAME_REAR_VERT.SLDPRT, FRAME_SIDE_HORIZONTAL.SLDPRT]
2026-02-06 finished V2.1 PCB
    [404010 fan v5.SLDPRT, Controller_Module.SLDASM, Controller_Module.SLDPRT, ERM_Assembly.SLDASM, ERM_Cover.SLDPRT, ERM_PCB.SLDASM, ERM_PC_Board.SLDASM, Exhaust_Sensor_assembly.SLDASM]
2026-02-11 got the display working thank fuck
    [Controller_Module.SLDASM, Controller_Module.SLDPRT, ERM_Assembly.SLDASM, ERM_Cover.SLDPRT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]
2026-02-13 got sht31 library working, had to FIX THE DOGHSHIT RETARDED INTERFACE TEMPLATE
    [ESP32-AT.kicad_sch, ShroomShed_MKII_PCB.kicad_pcb]
2026-02-16 imlemented SCD40 driver and Api
2026-02-19 got usb to serial printing working
    [Polycarbonate_Tub_240x304mm.SLDPRT]
2026-02-19 solidworks assembly all main dimensions now changable
    [Controller_Module.SLDASM, ERM_Assembly.SLDASM, ERM_Cover.SLDPRT, FRAME_REAR_BOT.SLDPRT, FRAME_REAR_VERT.SLDPRT, FRAME_SIDE_HORIZONTAL.SLDPRT, FRAME_SIDE_VERTICAL.SLDPRT, FRAME_TOP_BACK.SLDPRT]
2026-02-20 added stuff like touch and stuff and humidifier control
    [ERM_Assembly.SLDASM, ERM_PCB.SLDASM, Floor.SLDPRT, Sensor.SLDASM, ShroomShed_MKII_CONTROLLER.SLDASM, ShroomShed_MKII_PCB.SLDASM]
2026-02-23 finished 0.1 basic UI, improved touch button press sensitivity
2026-02-25 adapted for V2.1 controller
    [Floor.SLDPRT]
2026-02-26 RGB LED driver fully functional with disco mode
2026-02-27 improved touch implementation with buffer, abandoned interrupts since that was a shit idea and just fucked verything up
2026-03-02 fan PWMM now functional
    [Controller_Module.SLDPRT, Controller_Module.STL, Transducer_Lid.STL, humidifer_holder.STL]
2026-03-05 updated soldiworks to first full 2.0 MKII configuration, added SD driver (not tested)
    [Controller_Module.SLDPRT, Controller_Module.STL, Door_.DXF, Door_.SLDPRT, ERM_Assembly.SLDASM, ERM_Cover.SLDPRT, ERM_Cover.STL, FRAME_ALL_DXF.SLDASM]
2026-03-06 working on improved touch driver, need to fix transmit receive bit synch / timings
    [display_manager.c, shroomshed.h]
2026-03-09 implemented shroomshedV1 low water level detection and DHT heater process
    [Display_Adapter.SLDASM, Display_bracket_AE.SLDPRT, Door_AC.SLDPRT, Door_magnet_holder.SLDPRT, Driver_housing.SLDPRT, Encoder Knob.SLDPRT, FrontPanel.SLDASM, FrontPanel_PCB.SLDASM]
2026-03-11 additions to UI + humidity PID controller now tuned properly
2026-03-16 got 18bit rgb working, now need to use DMA controller as significantly slower than before
    [door_bracket.SLDPRT]
2026-03-18 completed controler V2.2, got basic blocking implementation of display SPI DMA working
    [ERM_PCB.kicad_sch, JLC assembly template.xlsx, ShroomShed_MKII_PCB.kicad_pcb, ShroomShed_MKII_PCB.kicad_sch]
2026-03-24 Fixed distance between display pin headers, checkpoint for proper DMA implementation
    [ShroomShed_MKII_PCB.kicad_pcb, ShroomShed_MKII_PCB.kicad_sch]
2026-04-01 updated cad
    [Controller_Module.SLDPRT, Door_.SLDPRT, EC_box.SLDASM, ERM_BOARD_TRACES.step, ERM_BOARD_TRACES.stl, ERM_PCB_BOARD.step, FRAME_REAR_BOT.SLDPRT, FRAME_REAR_VERT.SLDPRT]
2026-04-09 more stuff
    [Alu_extr_254_56.SLDPRT, L2_bracket_3H.STL, L2_bracket_front_low_left.STL, foot_assembly_2.SLDASM, foot_well_2.SLDPRT, polcarb tub left bracket.SLDPRT]
2026-04-28 Controller V2.2 ordered
    [Controller_Module.SLDPRT, Controller_Module.STL, Controller_Module_V1.SLDPRT, Controller_Module_V1.STL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]
2026-04-29 saving checkpoint before fucking with frame cad
    [Floor.SLDPRT, L2_bracket_front_high.SLDPRT, L2_bracket_front_low_left.SLDPRT, L2_bracket_front_low_right.SLDPRT, Left_Assembly.SLDASM, Right_Assembly.SLDASM, humidifer_holder.SLDPRT]
2026-04-29 Initital frame update commit, seem ok so far
    [FRAME_REAR_BOT.SLDPRT, FRAME_REAR_VERT.SLDPRT, FRAME_SIDE_HORIZONTAL.SLDPRT, FRAME_SIDE_VERTICAL.SLDPRT, FRAME_TOP_BACK.SLDPRT, FRAME_TOP_FRONT.SLDPRT, FRAME_TOP_SIDE.SLDPRT, Left_Assembly.SLDASM]
2026-04-29 checkpoint before I fugg up the whole assembly to fix the equations
    [FRAME_SIDE_HORIZONTAL.SLDPRT, FRAME_TOP_SIDE.SLDPRT, FRAME_TOP_SIDE_2.SLDPRT, Floor.SLDPRT, Left_Assembly.SLDASM, Left_Panel.SLDPRT, Right_Assembly.SLDASM, Right_Panel.SLDPRT]
2026-04-29 cad model updated and not broken, still need to export manufcatoring files for laser
    [Door_.DXF, FRAME_ALL_DXF.SLDASM, FRAME_SIDES.DXF, FRAME_SIDE_HORIZONTAL.SLDPRT, FRAME_TOP_REAR.DXF, FRAME_TOP_SIDE.SLDPRT, FRAME_TOP_SIDE_2.SLDPRT, Floor.DXF]
2026-07-03 updated display driver to work with new displays, updated CAD to more or less final MVP
    [400x1200mm_base.SLDPRT, Controller_Module.SLDPRT, Controller_Module.STL, Controller_Module_V21.STL, Door_.DXF, Door_.SLDPRT, FRAME_CUT_A.DXF, FRAME_CUT_B.DXF]
2026-07-16 restore point
    [Door_.SLDPRT, Left_Panel.SLDPRT, PC_DOOR_REAR.DXF, PC_LEFT_RIGHT.DXF, PC_LEFT_RIGHT_DOOR_REAR.DXF, PC_TOP_X2.DXF, PC_multi_cuts.SLDASM, Rear_Panel.SLDPRT]
2026-07-21 commit before I fuck shit up in my cad assembly
    [Filter_Bracket.SLDPRT, TPU_SEAL_85mm.SLDPRT, TPU_SEAL_85mm.STL, Transducer_Lid_CONV.SLDPRT, Transducer_Lid_CONV.STL, foot.SLDPRT, foot.STL]
2026-07-27 added CRC drivers for EEPROM emulation
2026-07-27 added 2nd meny page with debug display which now shows PID info
2026-07-27 re-enabled disable shed during sensor error
    [sensors.c]
2026-07-27 fixed hal functions for fan, fan now works again
    [main.h, shroomshed_hal.c]
2026-07-27 updated PID gains so working reasonably well now
2026-07-30 added grow kit page with QR code to sporeshift, add home button to most pages
    [Wick_cutting_jig_56mm.SLDPRT, Wick_cutting_jig_56mm.STL, Wick_cutting_jig_58mm.SLDPRT, Wick_cutting_jig_58mm.STL]
2026-08-11 reworking lighting to have static colour option WIP
    [rgb.c, rgb.h]
2026-08-12 changed label colour of single colour page to match the colour and removed useless switch_screen functions
2026-08-12 fixed back buttons and fixed stack issue that was preventing RGB from working on release build preset
    [rgb.c]
2026-08-17 FIXED GROW MENU NOT SHOWING NAMES
    [main.h, mushroom.c, mushroom.h]
2026-08-19 improved test unit switch macro
2026-08-19 sensor no longer auto shuts off shed when using test unit
2026-08-19 minor adjustments to PID gains, modified LV_config to optimise mem usage
2026-09-23 new grow screen that uses simple buttons instead of the shitty roller, OS version is now linked to string var set in shroomshed.c instead of literal
2026-09-29 first changes for new contoller, heckpoint for new door cad
2026-11-09 updates to solidworks assembly, checkpoint befotre making of changes
2026-11-11 add target power humidifier mode to manual control
